YohanHadji/R2Home/README.md

# R2Home
The goal of the project is to design a system with a size of a tube about 40cm long by 7cm in diameter, which can be released in free fall from almost anywhere, and will automatically deploy a parachute canopy and steer it to a precise GPS point. 



You will find way more information about it there : 

https://hackaday.io/project/176621-r2home
https://www.youtube.com/channel/YohanHadji

Support the project on : https://gofund.me/c0ae8d1f

Frequent updates on : https://twitter.com/YohanHadji

If you have any question fell free to contact me at hadji.[putmyfirstnamehere]@gmail.com
