YohanHadji/R2Home/Parachute Design Ressources/Tipps2.pdf

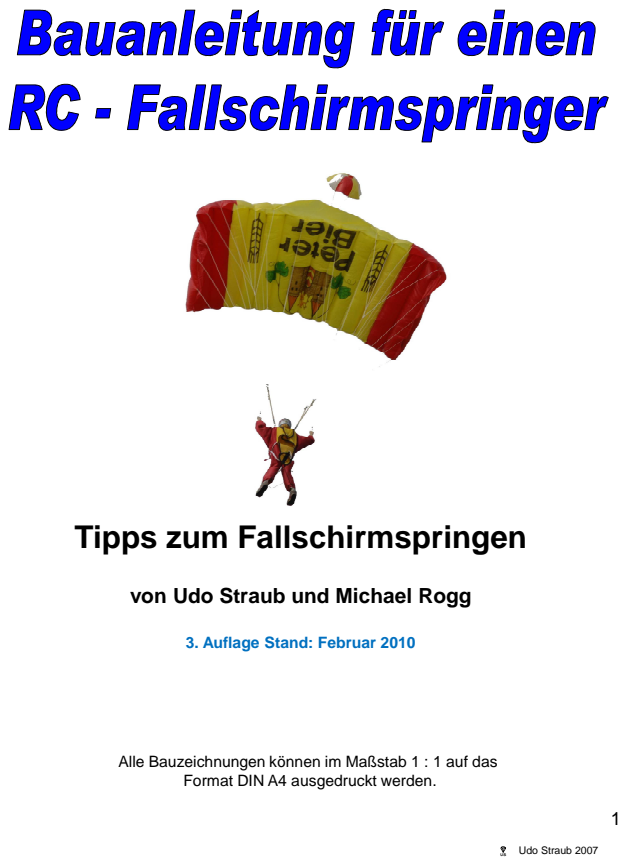
[picture p1: page 1]
Udo Straub 2007

Tipps zum Fallschirmspringen

von Udo Straub und Michael Rogg

3. Auflage Stand: Februar 2010

Alle Bauzeichnungen können im Maßstab 1 : 1 auf das

Format DIN A4 ausgedruckt werden.

## Informationen von Modellfallschirmspringern – für Modellfallschirmspringer

und für solche, die es werden wollen.

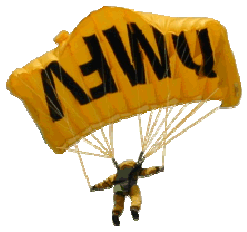
[picture p2: figure]

# Inhaltsverzeichnis

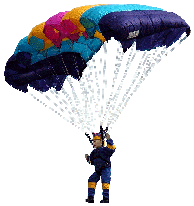
[picture p3: figure]

Informationen zum Modellfallschirmspringen ( nicht nur für Anfänger)

Die Schleppflugzeuge und das Absetzen der Springer

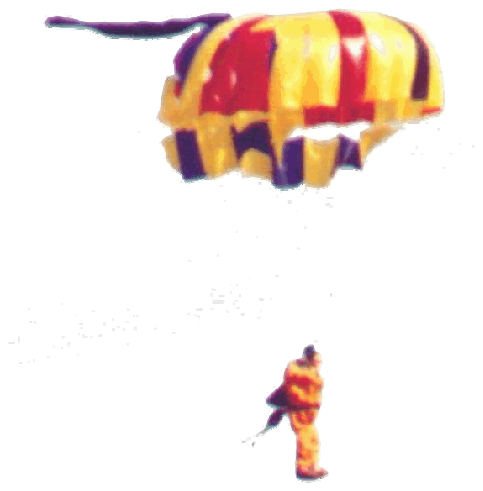
[picture p4: figure]

2

Aerodynamik des Flügelschirms

Wie wird der Fallschirm gepackt?

Der Schlepper vom Dienst

Der Springer im freien Fall

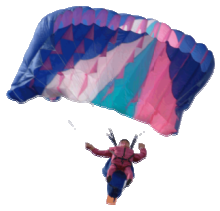
[picture p5: figure]
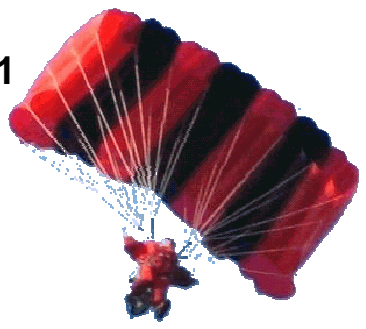
[picture p6: figure]

91
Impressum

## Infos (nicht nur) für Einsteiger von Michael Rogg

Allgemeine Infos zur Matratze

Stabilisatoren halten die Kappe offen (seitlich). Die Flairs (Dreiecke an der Unterseite) erleichtern das Einhalten der Flugrichtung.
Eine Vorbremsung des Schirmes ist evtl. notwendig, da die Kappe mit einem Anstellwinkel nach vorne unten fixiert ist. Ohne Vorbremsung würde die Kappe bei zu langen Steuerleinen sofort nach vorne unten Fahrt aufnehmen/wegschießen. Mit Vorbremsung geht der Schirm im Prinzip zuerst als Kappe ohne Vorwärtsfahrt auf. Erst dann beginnt der Schirm nach vorne zu gleiten.
Das System kann sich nur entfalten, wenn die Leinen ihre ganze Länge erreicht haben. Beim Original zieht der kleine Schirm den großen in einer Tasche verpackt aus dem Rucksack des Springers. Diese kleine Tasche ist mit Gummiringen verschlossen, die durch die Leinen von der Mitte aus versperrt werden. Wirft der Springer den kleinen Schirm aus, entfalten sich zuerst die Leinen, die dabei Stück für Stück die Tasche entriegeln, auf ihre volle Länge. Erst dann wird der Schirm aus der Tasche gezogen. Wurde der Schirm sauber gepackt, ist es praktisch egal, wie er in die Tasche gestopft wird.

Sicherheit

3

Kein Springer sollte jemals ohne einen Ortungspiepser auf die Reise geschickt werden. Eine Sicherheitseinrichtung, die eine vorzeitige Öffnung des Schirms am Flugzeug absolut verhindert ist ebenfalls unabdingbar. Der Schirm würde sich sonst mit großer Wahrscheinlichkeit am Leitwerk verhängen - mit katastrophalen Folgen!!!
Deshalb wird stets einen Art "Reißleine" mit maximal 30 cm Länge am Flugzeug befestigt. (Maurerschnur kann halten, muss aber nicht. Besser ist ein 12 mm breites Kunststoffband mit etwa 10 cm Klettverschluss.) Bei der einen Methode bleibt die Fernsteuerung eingeschaltet und ein Drahthaken an der Sicherheitsleine, der durch Ösen geführt wird, verhindert, dass sich der Schirm zu früh öffnet.
Bei der anderen Methode steckt ein Kohlepin im Allerwertesten des Springers. Er betätigt zwei Schalter (Redundanz!). Fällt der Springer vom Flugzeug ab, wird die Anlage eingeschaltet.

Auf dem Markt werden Sets angeboten, die auf einer Platine Ortungspiepser und Schalter enthalten. Sie sind teuer, aber sehr zu empfehlen, da der Pin die idealen Maße hat, um auch unter schwierigsten Bedingungen sicher auszulösen. Ich habe es mit meiner Do schon erlebt, dass ein Springer nicht vom Pin wollte und wild baumelnd unter dem Flugzeug hing. Stress lass nach!

Abb. 1

## Springer auf den Punkt gebracht !? von Michael Rogg

Tipps für das Zielspringen mit Modell-Fallschirmspringern

Beim Zielspringen mit Modell-Fallschirmspringern steht der Springerpilot sieben Meter vom Nullpunkt entfernt. Wie schwierig es ist, unter dieser Maßgabe bei wechselnden Platz- und Wetterverhältnissen die Scheibe zu treffen, zeigt ein Blick in die Ergebnislisten der Wettbewerbe.
Auch ich habe in den letzten Jahren versucht, mich immer näher heranzuarbeiten. Getreu dem Motto „es gibt für alles einen Grund“, habe ich meine Sprünge und (Fehl-!!!) Landungen analysiert und meine Schlüsse daraus gezogen. Der folgende Aufsatz ist eine Zusammenfassung meiner Erfahrungen, ohne Anspruch auf Allgemeingültigkeit oder Vollständigkeit. Schließlich geht jeder Pilot auch beim Fallschirmspringen seinen individuellen Weg.

### 1 DIE TECHNIK

Müssen es Gelenkarme sein?
Genau wie bei den „großen“ Springern werden die Geschwindigkeit reguliert und die Kurven gesteuert, indem die Hinterkante das Schirmes beid- bzw. einseitig nach unten gezogen wird. Zurzeit werden dazu zwei verschiedene Arme eingesetzt:
A) Arme, die nur am Schultergelenk beweglich sind

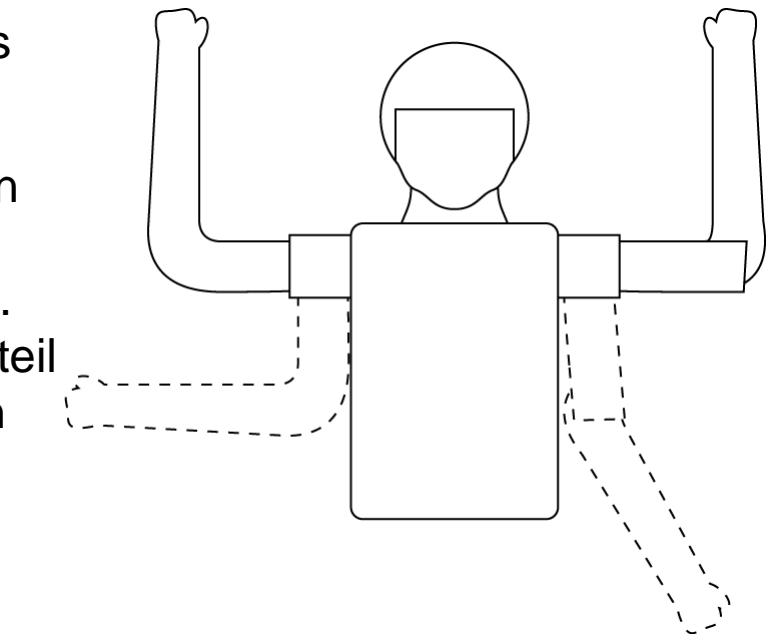
[picture p7: figure]

4

und deren Ellbogengelenk fixiert ist (Abb. 1, links).

B) Gelenkarme, bei denen über ein Hebelsystem Schulter- und Ellbogengelenk bewegt werden (Abb.1, rechts).
Die Gelenkarme haben sich in den letzten Jahren zunehmend durchgesetzt. Sie bieten einen deutlich größeren Steuerweg, der für viele Schirme dringend benötigt wird. Gelenkarme sind jedoch sehr aufwändig in der Herstellung und damit teuer! Es sollten sinnvoller Weise Servos mit mindestens 80 Ncm Stellkraft, besser 130 Ncm, verwendet werden.

Sie sind leicht und kostengünstig aus verschiedenen Werkstoffen herzustellen und haben sich im Dauerbetrieb als äußerst robust und zuverlässig erwiesen. Es genügen Servos mit ca. 80 Ncm Stellkraft. Nachteil dieses Armtyps: der Steuerweg reicht nicht bei allen Schirmen aus, um den ganzen Geschwindigkeitsbereich
auszuschöpfen.

Die Senderbelegung

Hier gibt es wohl so viele unterschiedliche Möglichkeiten wie Piloten. Da ich Flächenflieger bin, bevorzuge ich eine Belegung, bei der das Steuern des Springers mit der eines Seglers mit Querrudern und Störklappen identisch ist.
Beide Funktionen liegen bei mir auf einem Kreuzknüppel. Das bedeutet:
Knüppel vorn: volle Fahrt
Knüppel hinten: Stall („Störklappen ausgefahren“)
Knüppel links/rechts: Kurven
Wichtig ist, dass der Sender so programmiert wird, dass z. B. in der Stellung „ganz vorne“ + „ganz rechts“ der linke Arm den ganzen Weg vom oberen Anschlagspunkt bis zum unteren Endpunkt zurücklegen kann, wobei der linke Arm ganz oben bleibt (Abb. 2). V-Leitwerksmischer lassen diesen extremen Ausschlag nicht unbedingt zu. Frei programmierbaren Mischern ist deshalb der Vorzug zu geben. Werden notfalls zwei freie Mischer gekoppelt, sollte die Sache funktionieren. Ich selbst verwende eine MC 24 und habe zu meinem Erstaunen festgestellt, dass man zwei Mischer mit exakt derselben Bezeichnung (z.B. QR auf K1) zweimal (!) verwenden, und so den Ausschlag auf das geforderte Maß bringen kann.

5

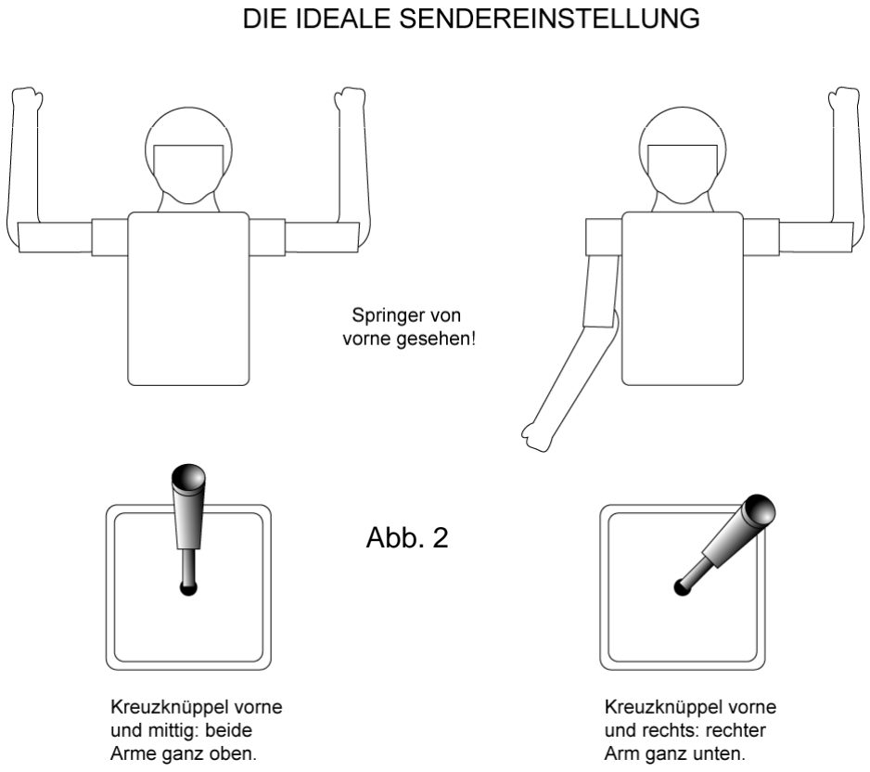
[picture p8: figure]
Abb. 2

Außerdem muss per Ruderwegbegrenzung sichergestellt sein, dass ein Servo einen Arm nicht über den oberen oder unteren mechanischen Endpunkt hinausziehen kann.

Nicht wenige Wettbewerbsspringer haben die Funktionen „Fahrt“ und „Kurve“ auf zwei Kreuzknüppel aufgeteilt, wobei dann die Geschwindigkeit über „Höhe“ gesteuert wird.

Gleiten oder sinken?

Vom Segelfliegen geprägt, habe ich anfangs meine Bemühungen um technische Verbesserungen zu lange auf das Gleiten gelegt. Bei gegebenem Schirm eine Sackgasse, wie sich bald herausstellen sollte. Denn: auf Grund seiner geringen Eigengeschwindigkeit kann sich ein Springer, im Gegensatz zu Segelflugmodellen, häufig nicht gegen den herrschenden Wind durchsetzen. Deshalb bleibt nichts anderes übrig, als den Springer stets recht nah am Zielpunkt zu halten und durch angepasstes Sinken auf den Punkt zu steuern. Manche Wettbewerber passen die Flughöhe an, indem sie mittels Stahlseil die vorderen Tragegurte etwas nach unten ziehen…
Für technische Verbesserungen gilt deshalb: nachdenken, wie sich das SINKEN beeinflussen lässt.
Auch beim Einfliegen eines Springers muss ein guter Kompromiss zwischen extremem Langsamflug (-> geringes Gewicht) und gutem Durchsetzungsvermögen bei Wind (-> höhere Flächenbelastung) gefunden werden.

### 2 DIE TAKTIK

### 2.1 Die Phasen des Zielsprungs

6

Wiederholung. Im Laufe der Zeit wurde mir klar, dass Zielsprünge „für Kopf und Finger“ am ehesten „vergleichbar“ und „wiederholbar“ werden, wenn man sie in Abschnitte unterteilt.

Folgende Unterteilung hat sich als recht nützlich erwiesen:
1. Anflug zum Absetzpunkt
2. Freier Fall und Öffnen
3. Anflug bis zum „Punkt“
4. Anflug bis zum Eindrehen
5. Anflug auf den Zielpunkt

### 1. Anflug zum Absetzpunkt

Auch wenn man es auf den ersten Blick kaum glauben mag: der richtige Absetzpunkt ist oft schon mehr als die halbe Miete. Stimmen Richtung und Entfernung in idealer Weise, hat der Springerpilot kaum etwas anderes zu tun, als den Springer auf sich zu fliegen zu lassen.

Die Richtung
ist dann perfekt gewählt, wenn der Wind den Springer genau auf den Zielpunkt zudriften lässt. Zwei Faktoren machen den Piloten hier das Leben schwer: erstens die Tatsache, dass sich die Windrichtung mit zunehmender Höhe oft stark ändert (hier ist ein feinfühliger und erfahrener Absetzpilot Gold wert) und zweitens die Windstärke.

Bei Abbildung 3 kommt der Wind in der Höhe von links. Hier ist der Vorhaltewinkel mit Sicherheitszugabe so groß zu wählen, dass der Springer am Ende seines Fluges auf jeden Fall eher „im Wind“ und damit links des Piloten ankommt und sich auf keinen Fall von rechts her gegen den Wind vorarbeiten muss. Bei entsprechend starkem Wind würde er das einfach nicht schaffen!
Säumen hohe Büsche oder Bäume den Flugplatz ist mit starken Verwirbelungen bis hin zu umlaufenden Winden zu rechnen. Dann helfen ein gutes Reaktionsvermögen und das notwendige Glück manchmal mehr, als die Theorie.
Die Windstärke

kann von Höhenmeter zu Höhenmeter extrem schwanken, vor allem, wenn der Landeplatz in einer Senke oder auf einer Kuppe liegt. Wird in einer Senke gelandet, kann der Wind auf den letzten Metern komplett ausbleiben. Bei Hügelkuppen wird in etwa 15 bis 50m Höhe oft ein Düseneffekt spürbar, der den Springer einige Sekunden lang mitreißt. Die Luft fließt hier, ähnlich wie bei einem Profil, sehr schnell über eine Wölbung. Dann ist genaueste Beobachtung angesagt.

7

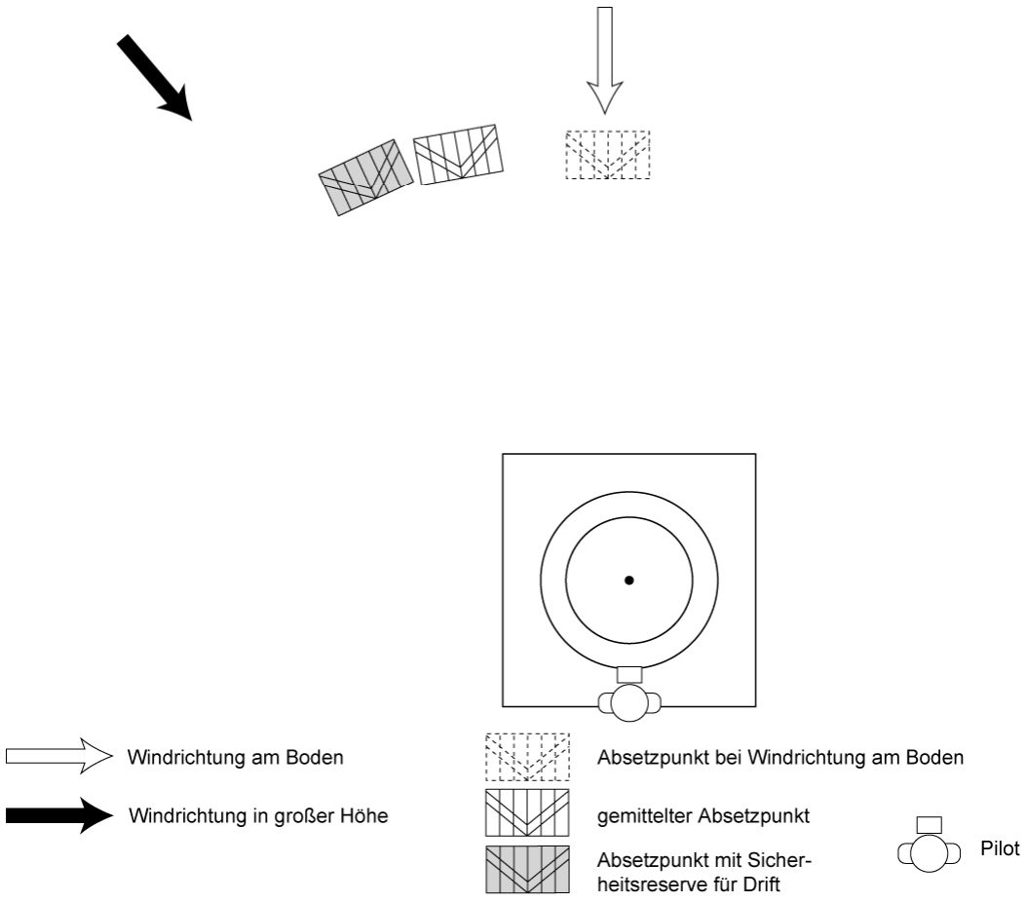
[picture p9: figure]

Lassen es die Geländeverhältnisse zu, so wird bei starkem Wind besser „zu weit vorne“ abgesetzt. Ist, was in der Praxis eher selten vorkommt, zu befürchten, dass der Springer den Zielpunkt nicht mehr erreicht, Schirm auf geringstes Sinken anbremsen und dem Wind die Arbeit überlassen, sprich Springer herantreiben lassen. Ein auf volle Fahrt geöffneter Schirm würde den Platz nicht erreichen, da er im Verhältnis zur Strecke, die er noch zurücklegen kann, viel zu schnell sinkt.
Bei besonders starkem Wind kann es von Vorteil sein, den Springer nur auf die unbedingt notwendige Höhe zu schleppen. Es genügt, wenn nach den beiden im Wettbewerb geforderten Vollkreisen gerade noch genug Zeit bleibt, um den Springer zum „Punkt“ zu bringen.
Hat man sich verschätzt, oder hat der Wind während des Sprunges aufgefrischt, ist es taktisch klüger, auf einen Kreis zu verzichten, als das Risiko einzugehen, über den Platz hinaus geblasen zu werden. Besteht die Gefahr, dass wegen auffrischender, starker Brise der Springer weit ins Lee abgetrieben wird, Springer lange fallen lassen und Kappe stets voll geöffnet gegen den Wind halten. Keinesfalls Kreise fliegen!

### 2. Freier Fall und Öffnen

Wenn man den freien Fall „tunen“ will, kommt man an zahlreichen Probesprüngen nicht vorbei! Dreht sich der Springer grundsätzlich wie auf einem Teller in eine Richtung, obwohl er sauber symmetrisch gebaut ist, kann man versuchen durch Bleizugabe (Körperinnenseite) auf der gegenüber liegenden Seite das Problem zu beheben.

8

Wippt die Puppe mit Kopf/Beinen stark auf und ab, oder überschlägt sich gar, liegt der Schwerpunkt nicht an der richtigen Stelle. Vor allem bei Gelenkarmen ist die Puppe oft zu kopflastig. Blei in den Beinen tut Not!

Für das Öffnen gilt: es wird selten zu spät geöffnet! Der Springer ist genauestens zu beobachten. Zum Zeitpunkt der Schirmöffnung muss er ruhig und sauber liegen. Viele Puppen benötigen einige Sekunden, bis sie ruhig auf ihrem Luftpolster durch die Luft gleiten.
Nervöse Anfänger zählen am besten in Ruhe laut bis drei, ehe sie öffnen.
Sollte der Schirm zum Öffnen sehr lange brauchen, muss überprüft werden, ob der Hilfsschirm tatsächlich sehr schnell ausgeworfen wird. Hilfsschirm so packen, dass ein beträchtlicher Teil der Verbindungsleine zum Hauptschirm nicht aufgewickelt ist, Hilfsschirm evtl. mit nur zwei oder drei Umdrehungen in den Auswurflappen einrollen. Öffnet sich der Schirm einmal nicht innerhalb des üblichen Zeitrahmens, beide Arme kurzzeitig etwas nach unten bewegen. Das bringt für gewöhnlich sofort „Bewegung“ in die Sache. In diesem Fall jedoch darauf achten, dass beim Entfalten der Kappe beide Arme ganz oben am Anschlag stehen, damit beim Öffnungsstoß die Mechanik geschont wird.

### 3. Anflug bis zum „Punkt“

Was ist „der Punkt“? Ich markiere mir nach meiner räumlichen Vorstellung stets einen Punkt am Himmel, von dem ab für mich die heiße Phase der Landung beginnt. „Der Punkt“ befindet sich etwa 40 bis 60 m und meist in direkter Windrichtung vor mir. Bei Seitenwind liegt er einige Grad „in den Wind“. Der Springer befindet sich am „Punkt“ in etwa 40 m Höhe. Nach der Vollendung der im Wettbewerb geforderten Kreise werden Distanz und Höhe so abgeglitten, dass sich der Springer möglichst ruhig genau „dem Punkt“ nähert. Der „Punkt“ hat für das Eintrainieren des letzten Abschnittes enorme Bedeutung,
Da er ein konstanter Ausgangspunkt ist, von dem sich die Landemanöver in relativ engen Grenzen wiederholen.

### 4. Anflug bis zum Eindrehen

Bei Windstille kann der Springer ab dem „Punkt“ angebremst und mit gleichmäßigem Sinken zum Zielpunkt geflogen werden. Die Landeeinteilung der Flugzeuge in Gegenanflug, Queranflug und Endanflug kann hier

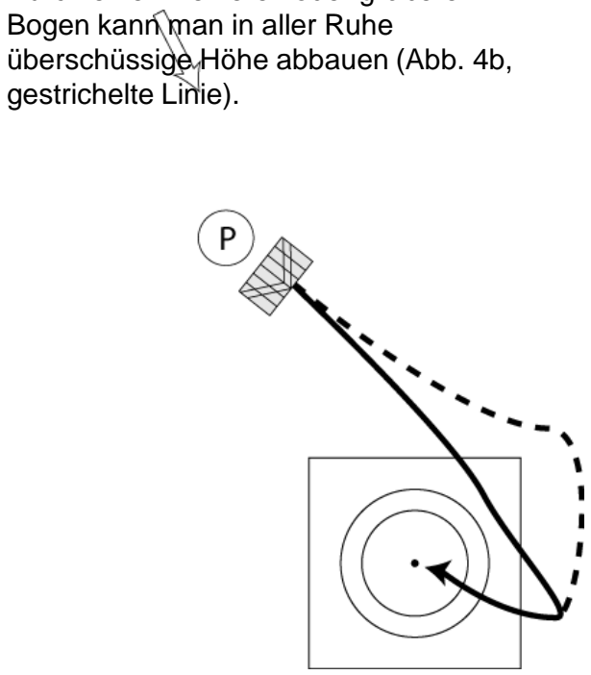
[picture p10: figure]
Bogen kann man in aller Ruhe überschüssige Höhe abbauen (Abb. 4b, gestrichelte Linie).

9

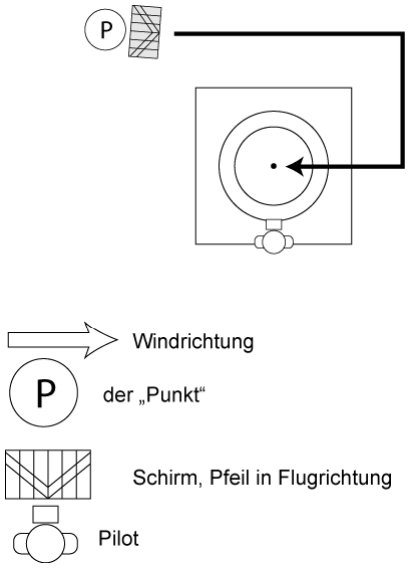
[picture p11: figure]

Abb. 4a

Abb. 4b

durchaus angewandt werden (Abb. 4a).

Durch einen kleineren oder größeren

Ab mittlerem Wind muss der Springer zunächst einige Sekunden volle Fahrt mit dem Wind abgleiten. Bei zu geringer Eigenfahrt wäre beim Eindrehen gegen den Wind der Widerstand der Kappe zu groß und es ginge wertvolle Zeit verloren, bis der Springerpuppe der Wind wieder ins Gesicht bläst. Hier ziehen es nicht wenige gute Piloten vor, den „Punkt“ außerhalb der direkten Windrichtung zu legen und die letzten Meter vor dem Eindrehen im spitzen Winkel zum Wind und

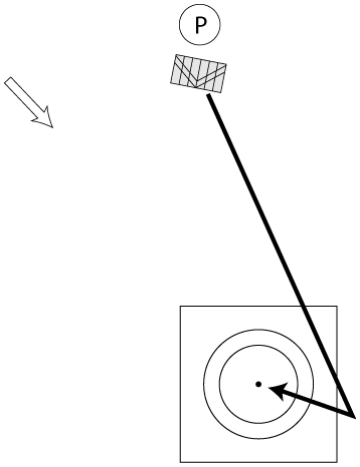
[picture p12: figure]

seitwärts driftend zurück zu legen. Auf diese Weise kann der Einfluss des Windes sehr gut abgeschätzt werden (Abb. 4c).

10

Abb. 4c

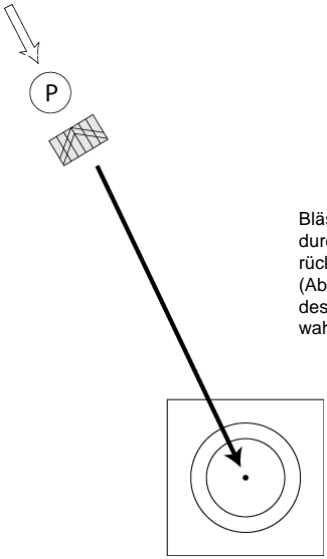
[picture p13: figure]

Bläst es sehr stark, aber auch konstant, kann es durchaus vernünftig sein, vom „Punkt“ weg rückwärts driftend den Zielpunkt anzugehen (Abb. 4d). Spätestens, wenn Hemd und Hose des Piloten im Wind flattern, ist dies die einzig wahre Technik.

Abb. 4d

### 5. Anflug auf den Zielpunkt

Gibt es über diese paar Meter tatsächlich noch etwas zu sagen?
Selbstverständlich! Zunächst ist alles eine Frage des „richtigen“ Standpunkts! Manche Piloten stellen sich gerne mit der Nase in den Wind, andere bevorzugen eine Stellung 90 Grad dazu. Der eine dreht notfalls gerne mal den Springer über seinem Kopf ein, der andere kann den Springer nur von links vernünftig steuern… Wichtig und richtig ist es sicherlich, mit wechselnden Standpunkten zu üben und Erfahrung zu sammeln, sich im Training vor allem auch auf seine „schlechte“ Seite zu konzentrieren, ehe man im Wettbewerb durch äußere Umstände dazu gezwungen wird.
Gewöhnt man sich außerdem an, mit seinen Zehenspitzen stets genau in Richtung Zielpunkt zu zeigen, hat man im Eifer des Gefechtes durch einfaches Ausrichten des Oberkörpers schon mal die exakte Richtung gefunden.

11

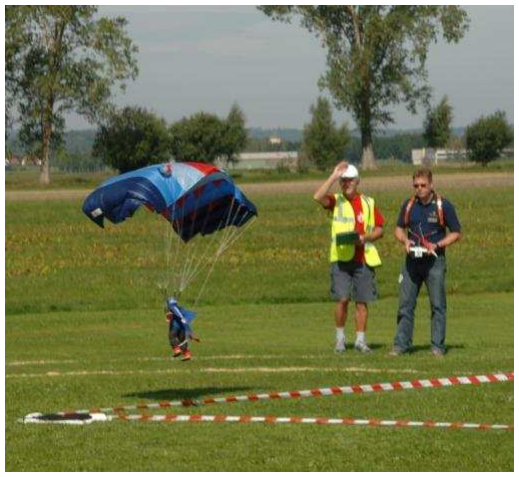
[picture p14: figure]

Die Regeln schreiben bislang vor, dass der Springer am Schluss ein paar Meter gegen den Wind fliegen muss und keinesfalls direkt aus einer Kurve heraus auf die Scheibe geschleudert werden darf. Allein schon aufgrund des oft krassen Missverhältnisses zwischen Windgeschwindigkeit und Springergeschwindigkeit, ist man in der Praxis damit zufrieden, wenn das Modell am Ende einige Sekunden stabil gegen den Wind fliegt.
Ob es sich dabei notfalls über Grund rückwärts bewegt, spielt keine Rolle.
Vor allem bei gemäßigtem, absolut konstantem Wind ist es mir immer wieder passiert, dass die Puppe über das Ziel hinausschoss, obwohl bis zur vorletzten Sekunde des Fluges alles perfekt zu sein schien. Eine logische Erklärung wäre, dass auf den letzten zwei oder drei Höhenmetern die Windgeschwindigkeit rasant zurückgeht. Nimmt der Springer deshalb auch nur für einen kurzen Moment Fahrt auf, schwingt selbst bei promptem Anbremsen die Puppe wegen ihrer Massenträgheit nach und setzt zu weit entfernt auf.

Ein zweites, häufig zu beobachtendes Phänomen zeigt sich, wenn nach mehreren Durchgängen der Wind ganz abflaut. Für gewöhnlich schießen auch in dieser Situation die Springer über den Zielpunkt hinaus. Jetzt kommt plötzlich die sonst kaum merkbare Minimalfahrt zum Tragen und die Puppe lässt sich nicht mehr über dem Zielpunkt halten. Eine Tatsache, auf die sich die wenigsten Wettbewerber innerlich einstellen können.
Dies kann nur umgangen werden, indem man mit etwas mehr Fahrt als „gewöhnlich“ den Landeanflug angeht.

Alles verstanden? Dann wird es Zeit, zum Flugplatz zu fahren…

Anregungen und Kritik (und vielleicht auch Lob) bitte über die Internetseite des MFC Ettringen (www.mfc-ettringen.de) oder privat (rgkestrel@aol.com/) Tel. 08246 1422 an den Autor.

Unendlich viel Springerspaß wünscht Euch

Michael Rogg, im Juli 2006

12

## Wie wird der Fallschirm gepackt?

von Udo Straub

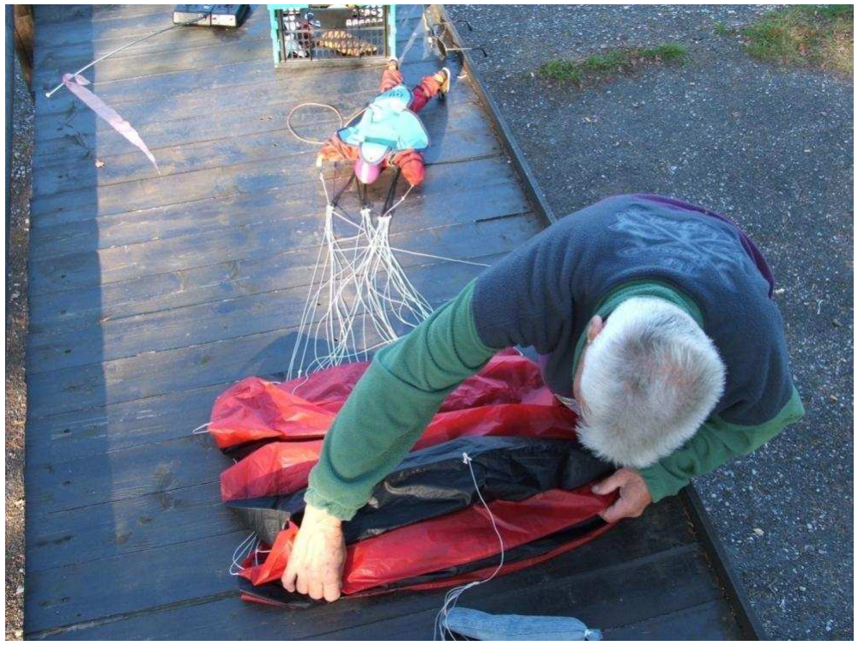
[picture p15: figure]

13

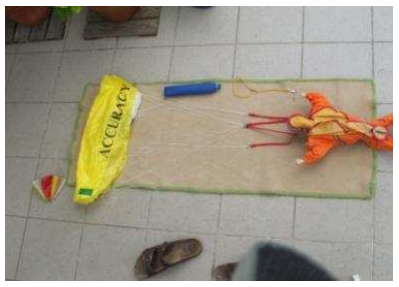
[picture p16: figure]

1

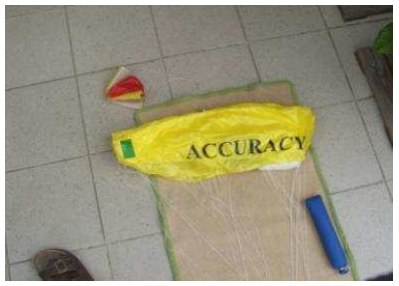
[picture p17: figure]

2

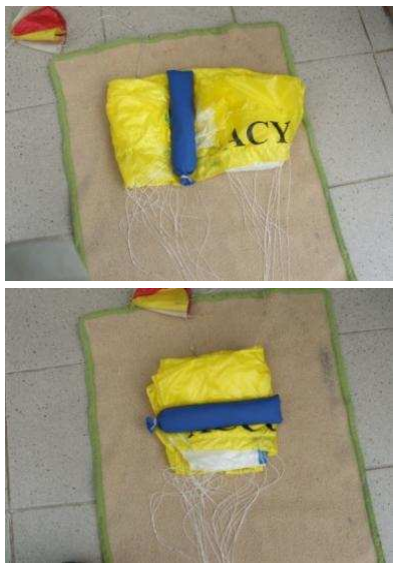
[picture p18: figure]

3

- aus einer alten Decke habe ich eine Packunterlage
- ein kleiner Sack mit Sand gefüllt erleichtert das Packen auch bei Wind
- der Springer wird auf dem Bach liegend gepackt. Die Schirmöffnung nach oben.
- Die Fangleinen liegen noch normal

3

4

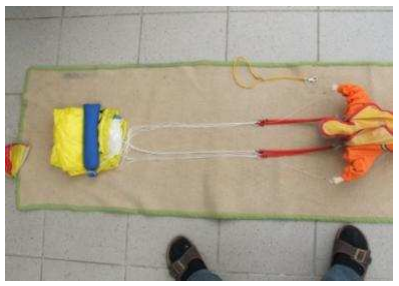
[picture p19: figure]

5

- Danach vorne 1/3 eingeschlagen
- Die Fangleinen werden von den Tragegurten zum Schirm gerichtet

14

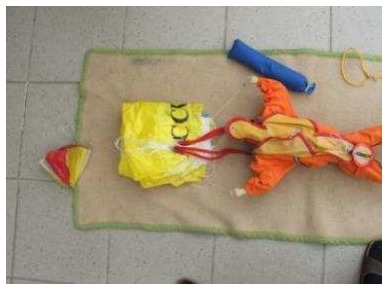
[picture p20: figure]

6

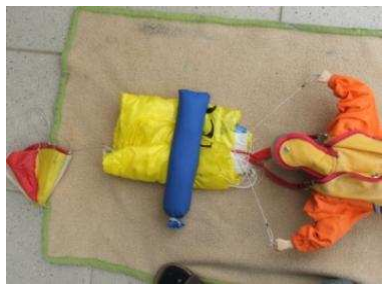
[picture p21: figure]

7

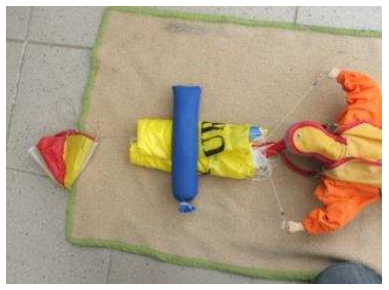
[picture p22: figure]

8

- Jetzt die Fangleinen und Tragegurte auf den Schirm legen.
- Die Fangleinen dann mit dem ersten Drittel des Schirmes erneut einschlagen
- Nun das andere Drittel ebenfalls einschlagen

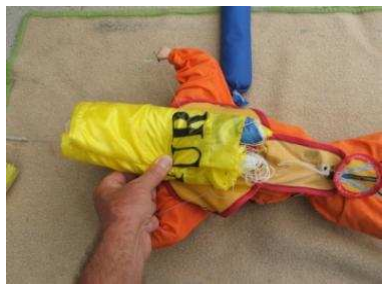
[picture p23: figure]

9

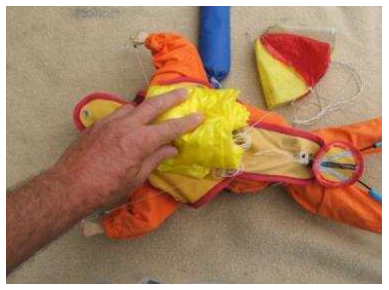
[picture p24: figure]

10

- Den ganzen Pack in den Packsack legen uns umzuklappen
- Die obere Hälfte nochmals umschlagen

15

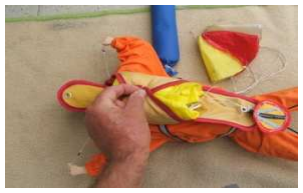
[picture p25: figure]

11

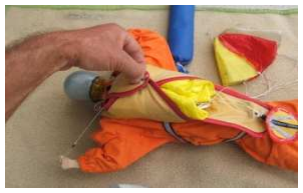
[picture p26: figure]

12

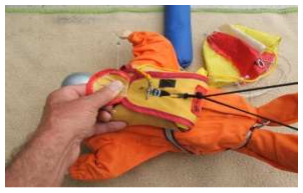
[picture p27: figure]

13

- Die beiden Seitenteile des Packsackes werden zusammengeführt..
- Die obere Packlasche folgt
- zuletzt die untere Packlasche einfädeln und mit dem Sicherungspin sichern

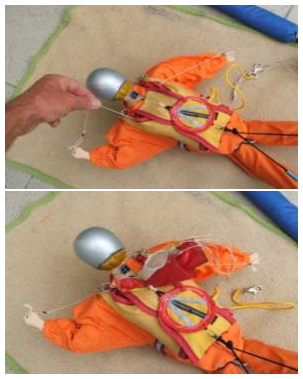
[picture p28: figure]

14

15

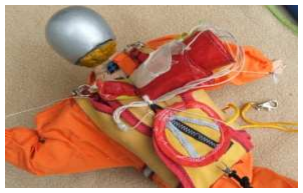
[picture p29: figure]

16

- Ggf. die Steuerleinen ein wenig herausziehen. Der Arm muss bei gepackten Schirm voll beweglich sein.
- Danach die Auslöseschlaufe (Fernsteuerung einschalten) einhängen.
- Die Leinen des Hilfsschirms ebenfalls unterklemmen
- Den Hilfsschirm einfach zwischen dem Packsack und der Auslöseleine klemmen.

16

## Hier die Auslösung Ein 3mm

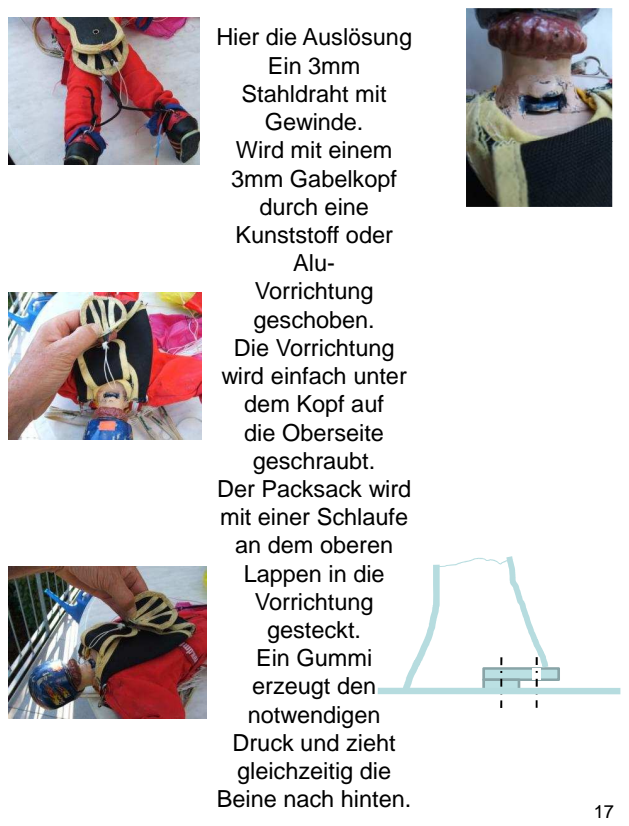
[picture p30: page 17]
Beine nach hinten.

Stahldraht mit
Gewinde.
Wird mit einem
3mm Gabelkopf
durch eine
Kunststoff oder
Alu-
Vorrichtung
geschoben.
Die Vorrichtung
wird einfach unter
dem Kopf auf
die Oberseite
geschraubt.
Der Packsack wird
mit einer Schlaufe
an dem oberen
Lappen in die
gesteckt.
Ein Gummi
erzeugt den
notwendigen
Druck und zieht
gleichzeitig die

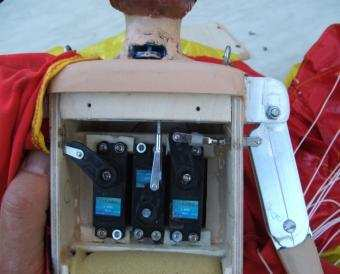
[picture p31: figure]

## Hier die gesamte

Anlenkung.

## Starke Servos > 6kg Zugkraft und 3mm Gabelköpfe auf 3mm Gewindestange reichen

aus.

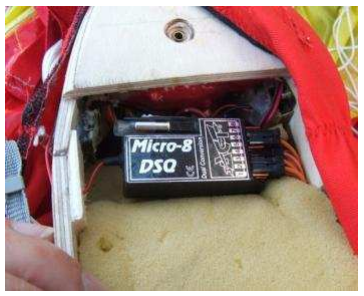
[picture p32: figure]

## Der offengelegte Empfänger. Dahinter der Ortungspiepser. Rechts der Schalter Ein/ Aus – links der Summer für den

Ortungspiepser.

## Ganz unten die beiden Endschalter für EIN/

AUS.

## Ich habe also zwei in Reihe geschaltete EIN/AUS- Schalter und als Sicherheit den SAFTY-PIN plus Elektro-

PIN.

## Deshalb auch zwei Stifte an der SEFTY-LINE ( Bild

rechts oben) | 18

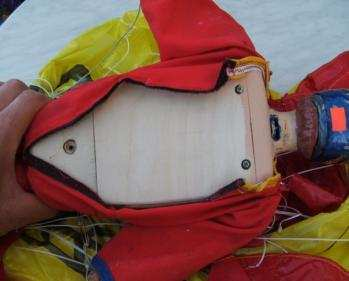
[picture p33: figure]

# Fachliteratur zum Thema

19

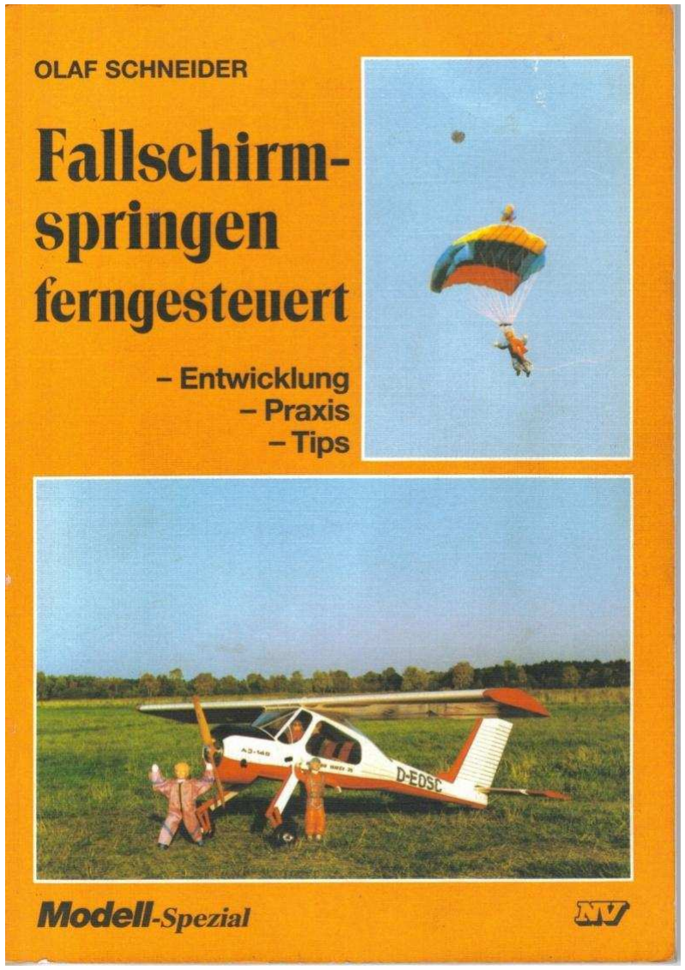
[picture p34: figure]

## Neckar – Verlag GmbH, 78045 Villigen-Schwenningen www.webshop.neckar-verlag.de

# Die Schlepper vom Dienst

von Michael Rogg

Diese Zeilen sind den unerlässlichen Schleppern - Mensch und Maschine - gewidmet. Es geht um Abgassysteme und Aufnahmevorrichtungen, Flügelspannweiten und Fahrwerke, Profile und Propeller, den Transport und selbstverständlich um dasTeam.
Zuweilen wird dieser Begriff als Kurzform für „Toll, Ein Anderer Macht´s.“ interpretiert. In unserem Fall ist nicht nur etwas Wahres daran, sondern es trifft den Nagel voll auf den Kopf.
Die besten Springerambitionen blieben auf der Strecke (Piste), gäbe es in den Vereinen keine lieben Kollegen, die nicht nur bereit sind die Springerpuppen auf Höhe zu schleppen, sondern auch noch geduldig den Anweisungen der Fallschirmspringerfans zu folgen. Darüber hinaus fertigen sie für die Springer Schleppmodelle an oder rüsten vorhandene Flugzeuge zum Absetzen um. Im Namen aller Springer-Piloten sei all diesen lieben Menschen deshalb hier zuerst einmal ein herzliches und riesiges Dankeschön ausgesprochen!
Und jetzt gibt es Tipps, wie man die Sache auf Dauer vernünftig angeht.
Es muss nicht immer Kaviar sein

In einer Zeit, da üppig motorisierte Flugmodelle mit zwei Metern Spannweite oder mehr auf unzähligen Flugplätzen zu Hause sind, sollte es kein Problem sein, eine für den

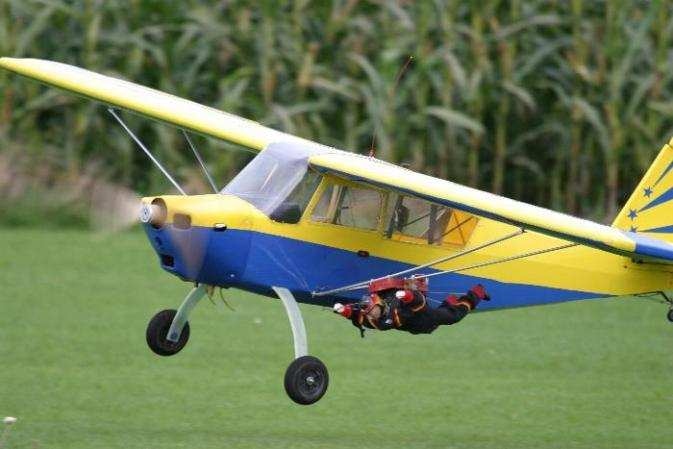
[picture p35: figure]

20

Springertransport geeignete Maschine der „Mittelklasse“ zu finden.
Um Anregungen zu geben und dabei verschiedenste Interessen und Vorlieben zu berücksichtigen, wurde eine Tabelle mit, wenn man so will, drei verschiedenen Typen von Modellen zusammengestellt.

Stellvertretend für auf Flugplätzen häufig zu findende (Baukasten-) Modelle, die mit wenig Aufwand für den Springertransport umgerüstet wurden, gibt es Informationen zu einer Bellanca Decathlon, Do 27, Jodel Robin und Piper PA18. In der mittleren Gruppe finden sich mit einer Daisy, einem Hannibal und einer Charter drei Beispiele für nach modifizierten Bauplänen erstellte Schleppmodelle. In der dritten Kategorie ist von einem OHA zu lesen - ein reines Zweckmodell, dessen Piloten Stein und Bein darauf schwören, dass es das beste Absetzmodell ist, das es gibt.
Wem die hier vorgestellten Modelle zu klein oder zu profan sind, wird zugeben müssen, dass es keines sonderlichen Aufwands bedarf, eine demontierbare Springeraufnahme (s. u.) auch an größeren Modellen vorzusehen. Ausgesprochene Großmodelle verfügen oft über eine extrem niedrige Grundgeschwindigkeit. Ein 160er Boxermotor dürfte ob zwei Kilogramm mehr oder weniger zu bewegendem Gewicht lediglich schmunzeln – wenn er denn könnte. Sowohl die überschüssige Motorkraft als auch die außerordentliche Minimalgeschwindigkeit prädestinieren Großmodelle auf jeden Fall für den
Springertransport.
Pflichtenheft für Schleppmaschinen

Die Gesamtauslegung des Modells sollte so sein, dass es bei gutmütigen Flugeigenschaften etwas übermotorisiert ist. Spannweiten ab etwa zwei Meter sind ideal, ebenso tragende oder dicke symmetrische Profile (Clark Y, NACA 2415, NACA 4415 usw.). Ein Springer wiegt für gewöhnlich zwischen 1,4 und 1,7 kg. Ein kritischer Blick auf die Gesamttragflächenbelastung kann deshalb nicht schaden. Wie man weiß, ist eine

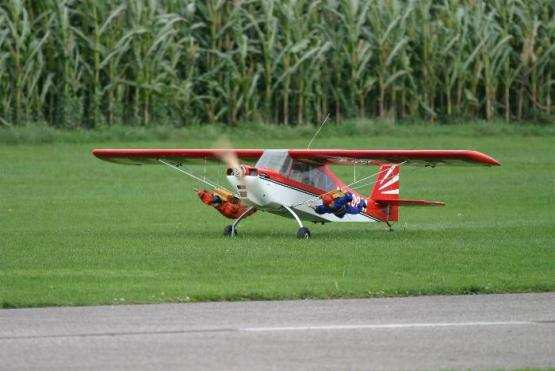
[picture p36: figure]

21

niedrige Flächenbelastung mit ausschlaggebend für eine niedrige Mindestfluggeschwindigkeit – eine absolut wünschenswerte Eigenschaft für Absetzmaschinen. Hochdecker oder Schulterdecker mit einigen Grad V-Form lassen in Punkto Eigenstabilität um die Längsachse bekanntlich nichts zu wünschen übrig. Auch das kommt unserem Einsatzzweck sehr entgegen. Um die Querachse ist ebenfalls ein hohes Maß an Eigenstabilität sehr gefragt. Dies wird durch ordentliche Höhenleitwerksabmessungen und einen großen Leitwerkshebelarm erreicht.
Die Springer können nicht immer so angebracht werden, dass sie die Lage des Schwerpunkts nicht beeinflussen. Bei vielen Modellen erzwingt die Fahrwerkskonstruktion eine Aufhängung hinter dem Schwerpunkt. Die Flugzeuge müssen deshalb etwas kopflastig ausgewogen werden.

Storchenbeine sind nicht zwingend vorgeschrieben, aber von Vorteil. Je höher das Fahrwerk ist, desto bandscheibenfreundlicher lassen sich die Springer unterschnallen. Wann ist die Fahrwerkshöhe gerade noch ausreichend? Schnallen Sie den oder die Springer unter den Rumpf und stellen Sie das Modell auf glatten, ebenen Grund. Sind an der engsten Stelle noch zwei Fingerbreiten Luft, geht die Sache in Ordnung. Das ist z. B. bei meiner Do 27 beim hinteren Springer der Fall. Auf einer Graspiste wird beim Rollen zwar der Eindruck erweckt, dass der Springer mit den Kniescheiben die Wiese umpflügt, bislang hatte aber keiner meiner Fluggäste auch nur Grasflecken auf dem Springerkombi.
Das Fahrwerk muss robust und hart im
Nehmen sein. GFK-Fahrwerke der Firma
KHK sind bei den Schlepppiloten äußerst
beliebt. Bei Baukastenmodellen erzwingt die erhöhte Zuladung oft eine härtere Federung. Dann muss mit zusätzlichen oder dickeren Stahldrähten bzw. Spiralfedern nachgebessert werden. Kommen Springerhände oder Leinen dem Rad s ehr nahe, sollte man an der Fahrwerksschwinge einen Abweiser anbringen.

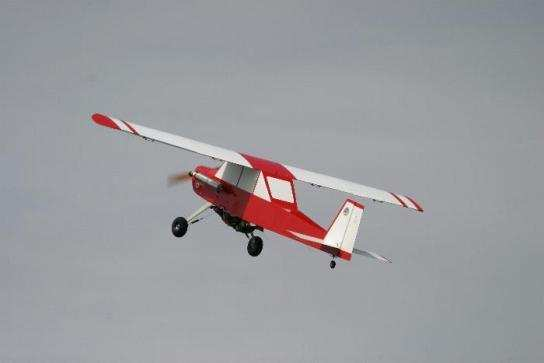
[picture p37: figure]

Dampf ist wichtig, aber nicht alles. Eine Wilga mit 2,2 m Spannweite, tragendem Profil, 35

22

ccm OS BGX und Resonanzrohr aus unserem Verein ließ sich von den kleinen Passagieren in keinster Weise beeindrucken. Sie klettert (e – leider) wirklich hervorragend. Ideal sind zweifelsohne Resonanzrohre mit einem Auslass am hinteren Ende, die in einem Tunnel im Rumpfinneren verlegt sind. Die Abgase treten dann hinter der Außenlast ins Freie, der Springer behält eine „weiße Weste“. Wer einen Benzinmotor mit Topfschalldämpfer verwendet, muss versuchen die Abgase zur Seite zu leiten. Sonst sieht der arme Springer schon nach einer Handvoll Transporte aus wie ein Aviateur, der ein Flugzeug mit Umlaufmotor pilotiert hat. Öliger Auswurf von Methanolmotoren darf sich keinesfalls auf dem Springer ansammeln. Die verwendeten Kriechöle perlen nicht wie Wasser auf den verwendeten Geweben ab, sondern dringen in sie ein und setzen sich fest. Über kurz oder lang würde der Fallschirm verkleben, das teure Stück wäre ruiniert.
Wer fliegen kann, hat auch viel Erfahrung mit Propellern. Bitte einfach daran denken, dass es stets mit Volllast nach oben geht und von den unerlässlichen Luftquirls genügend Leisetreter auf dem Markt sind. Acht oder zehn Zoll Steigung sind für unseren Zweck ideal.
Grundsätzliche Überlegungen zu Springeraufnahmen

Die Springeraufnahme hat die Aufgabe, den kleinen Passagier während des Transports sicher zu fixieren und ihn schließlich ebenso zuverlässig für den freien Fall zu entlassen. Weder Motorvibrationen noch heftige Schläge beim Rollen oder abrupte Flugmanöver dürfen ein Verrutschen des Springers zur Folge haben. Was folgt daraus im Detail?

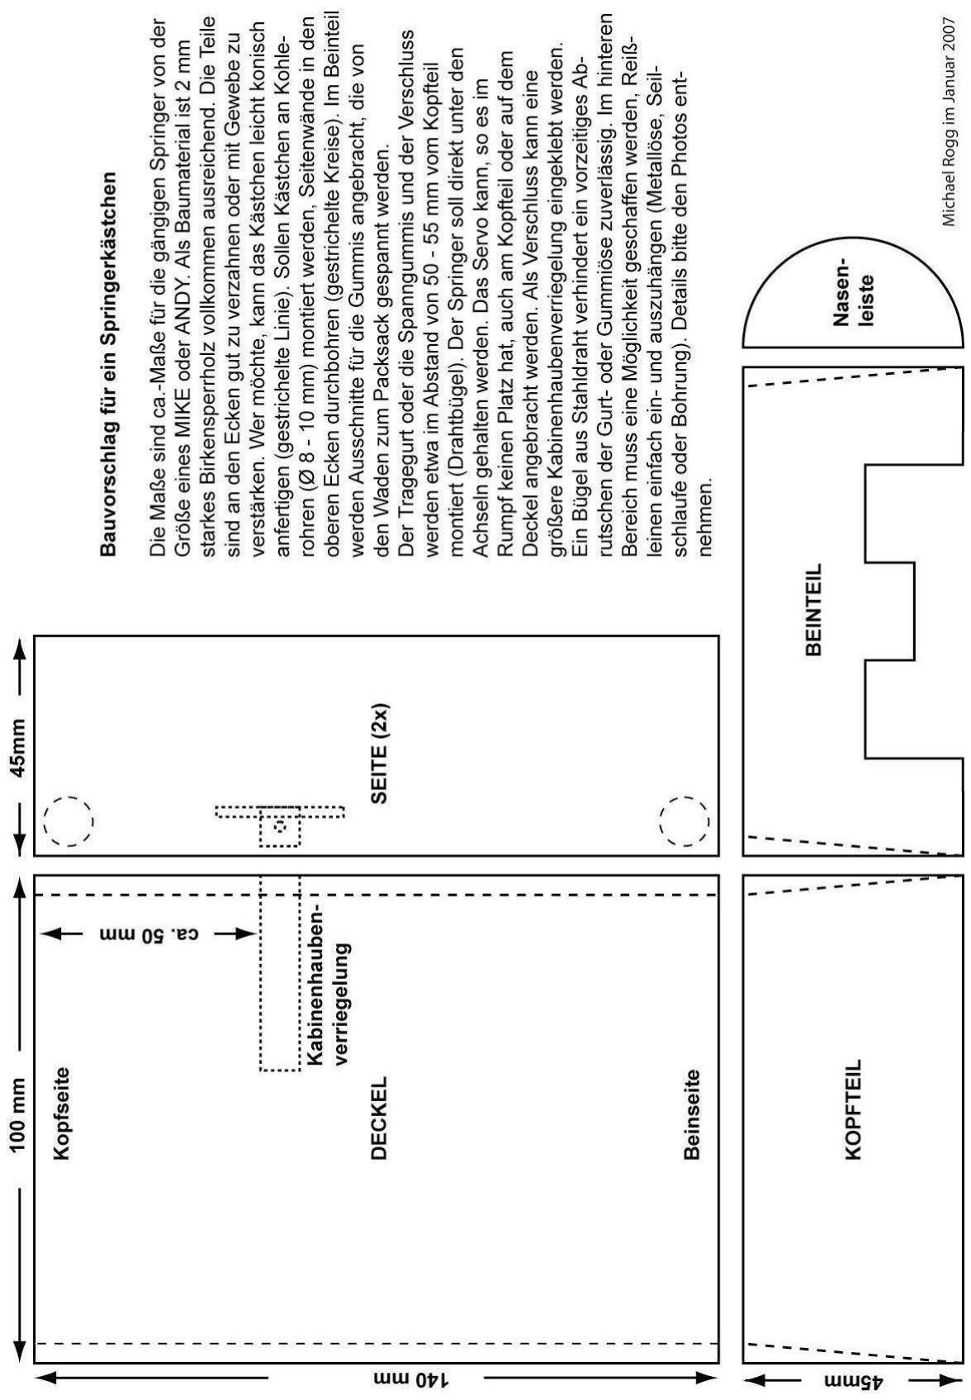
[picture p38: page 23]

23

Generell gilt: Bei der Gestaltung der Halterungen und Verschlüsse darf man seiner Phantasie freien Lauf lassen. Es sollte sich jedoch nach menschlichem Ermessen keine Leine oder Antenne in irgendeiner Weise verhaken können.

Das Kästchen
Eine der größten Gefahren für die Schleppmaschine stellt ein sich vorzeitig öffnender Schirm dar. Puppe oder Packsack sind deshalb mit entsprechenden Sicherheitseinrichtungen ausgestattet (vgl. Berichte 1 und 2). Ein kleines Kästchen an der Schleppmaschine (Maße siehe Zeichnung) ist ein weiterer wichtiger Beitrag zur Sicherheit. Es umschließt den Packsack eng, aber ohne ihn einzuklemmen. Sollte sich durch Vibrationen oder sonstige Ursachen einmal ein Lappen des Packsacks lösen o. ä., verhindert das Kästchen, dass sich die Fallschirmkappe im Luftstrom des Propellers entfaltet.
Befestigungsmöglichkeit für die Reißleine
Am hinteren Ende des Kästchens muss eine kräftige, gut zugängliche Öse oder Schlaufe für die Befestigung der Reißleine vorhanden sein. Zum Ein- und Aushängen von Reißleinen wird fast ausnahmslos eine der folgenden Techniken angewendet: man fädelt eine Schlaufe ein, benutzt einen Karabinerhaken oder Klettverschluss.

Gurt oder Gummi
Haltegurte oder -gummis haben die Aufgabe, den Springer sicher zu fixieren. Was passieren kann, wenn 1,5 kg an einem Bein hinter dem Schwerpunkt unter der

24

Ein breiter, stramm sitzender Gurt, der den Brustkorb der Puppe direkt unter den Achseln umfasst hat sich gut bewährt. Da man nie ganz perfekt gleich packen kann, trägt allein schon der Packsack immer etwas unterschiedlich auf. Außerdem haben nicht alle Springerpuppen das gleiche Maß. Deshalb muss man entweder für einen flexiblen Gurt sorgen (z. B. Hosenträgermaterial) oder den Verschluss eines Ledergurts anpassungsfähig gestalten. Eine Kombination aus Schlüsselring, Haushaltsgummis und Drahtöse leistet dabei gute Dienste. Der Einsatz von Klettverschluss ist auch immer eine Überlegung wert.
Die Verwendung von zwei breiten Gummiringen hat sich ebenfalls ausgezeichnet bewährt. Sie werden auf einer Seite im Abstand von einigen Zentimetern durch Ösen oder Schlaufen gezogen und auf der Verschlussseite mit einem kräftigen Kabelbinder oder kleinen Schlüsselring zusammengefasst.
Verriegelung
Der Verriegelungsmechanismus muss gut zugänglich und solide konstruiert sein. Ehe Sie ein Servo dafür auswählen bedenken Sie bitte, dass ordentlich Zug auf dem Riegel lasten wird und es sehr unangenehm sein kann, mit nur einem Springer auf einer Seite des Rumpfes zu landen.
In der Praxis sehr bewährt haben sich Mechanismen, die über die Fernsteuerung lediglich auf Zug geöffnet werden. Das Schließen übernimmt eine Spiralfeder. Ein handelsüblicher Kabinenhaubenverschluss leistet hier gute Dienste.

Wer etwas mehr Zeit und Aufwand investieren möchte, kann sich einen L-förmigen Riegel basteln. Die L-Form entlastet das Servo in besonderer Weise, da der Hebelarm, der verriegelt, deutlich länger ist, als der Hebelarm an dem der Gurt eingehängt wird.
Als „Gestänge“ wird flexibler Bowdenzug oder Stahlseil verwendet. So kann der Springer-Pilot sein Modell jederzeit einhängen, ohne dass der Pilot der Absetzmaschine ständig dabei sein muss.

Aufnahme für einen einzelnen Passagier

Ist ein Modell von Anfang an für den Transport eines einzelnen Springers vorgesehen, gibt es wohl keinen vernünftigen Grund es nicht schon beim Bau mit einer permanenten Springeraufnahme auszustatten. Dazu wird in die Rumpfunterseite kleines Kästchen eingelassen (Maße siehe Zeichnung). Der Springer sollte natürlich möglichst in der Nähe des Schwerpunktes seinen Platz finden. Achten Sie jedoch darauf, dass sich keine Leinen am Fahrwerk verfangen können. Auch wenn sie zunächst Bauchweh dabei haben: manchmal ist es besser, den Springer mit dem Kopf in Richtung Leitwerk unterzuschnallen.
Wird ein Flugzeug nur gelegentlich zum Absetzen eingesetzt, sieht man eine Befestigungsmöglichkeit für ein abnehmbares Kästchen vor. In diesem Fall werden in den Rumpf einfach zwei Einschlagmuttern eingeharzt.

Zwei oder mehr Springer sollen mit

25

Richtung der Tragflächen verteilt werden sollen. Eine Do 27 mit 2,7 m Spannweite hat genügend Längsstabilität, um die Puppen problemlos unter dem Rumpf zu transportieren. Sie reagiert auf die Schwerpunktverschiebungen nach dem Absetzen eines Springers äußerst gutmütig. Wenn nur der vordere Platz belegt ist, hält sich die Kopflastigkeit in Grenzen und lässt sich mit wenigen Zacken Höhe ausgleichen. Ist das Modell etwas kopflastig ausgewogen, hat man selbst dann keine ernsthaften Probleme, wenn nur in der hinteren Aufnahme ein Springer transportiert wird. (Selbstverständlich wird bei einem Einzelschlepp stets der vordere Platz belegt.) Unterschätzen Sie den Stirnwiderstand von Springeraufnahmen nicht. Halten Sie die Stirnseiten aller Halterungen so klein wie möglich. Gestalten Sie Stirnseiten stets rund.
Die Alternative zur Längsachse des Rumpfes ist die Querachse der Tragflächen.
Hier stellt sich zunächst die Frage ob Streben vorhanden sind und ob man die Springeraufnahmen daran befestigen möchte. Vor allem wenn die Streben aus Stahlrohren gefertigt sind, wie bei der 3-Meter-Version der Decathlon, steht einer Befestigung an ihnen nichts entgegen. Ich persönlich ziehe eine Aufhängung an Raumpfauslegern vor. Dabei werden die Aufnahmen an zwei Kohlestangen (Ø 8 mm) oder Kohlerohren (Ø 10 mm) in möglichst geringem Abstand zum Rumpf fixiert. Die Rohre oder Stangen schiebt man quer durch den Rumpf. In die Kohlerohre werden an besonders belasteten Stellen, wie dem Übergang in den Rumpf, kurze Buchenholzstücke eingeklebt. Karosseriesplinte aus dem RC-Car-Bereich sind ein probates Mittel wenn es um die Fixierung der Kohleträger geht.
Hat man üppig Motorleistung, kann zeitgleich mit den Springern an den Auslegern eine weitere Puppe unter dem Rumpf mitgenommen werden.

Standards

Durch das in Wettbewerben des DMFV nach wie vor gültige Gewichtslimit von 1,7 Kilogramm haben die allermeisten Springer eine vergleichbare „Standardgröße“. Sie können also sicher sein, dass Sie fremde Springer problemlos transportieren können, wenn Ihr Transportkästchen die in der Zeichnung angegebenen Maße hat und wenn man die Reißleine ohne Aufwand wechseln kann. Es lohnt sich sicherlich auch, innerhalb eines Vereins Standards zu vereinbaren. Dann kann eine Springeraufnahme problemlos von Modell zu Modell wandern.
Fliegen – Safety First

Der Transport und das Absetzen sind von jedem halbwegs versierten Piloten leicht zu bewältigen. Damit Sie vor unnötigen herben Rückschlägen definitiv verschont bleiben, seien hier noch ein paar grundlegende Dinge kurz erwähnt.
Bis man die Grenzen des sicheren Fliegens ausgelotet hat, empfiehlt es sich, das Modell beim Rollen ganz sauber mit Seitenruder gerade zu halten. Bei Seitenwind ist nach Bedarf mit etwas Querruder vorzuhalten. Nutzen Sie die gesamte Länge der Startbahn. Lassen Sie das Modell möglichst viel Fahrt aufnehmen. Es muss am Ende von selbst abheben und flach steigen.
Durch die Außenlasten haben sich die aerodynamischen Eigenschaften Ihres Modells in mehrfacher Hinsicht verschlechtert. Die höhere Tragflächenbelastung bedingt eine höhere

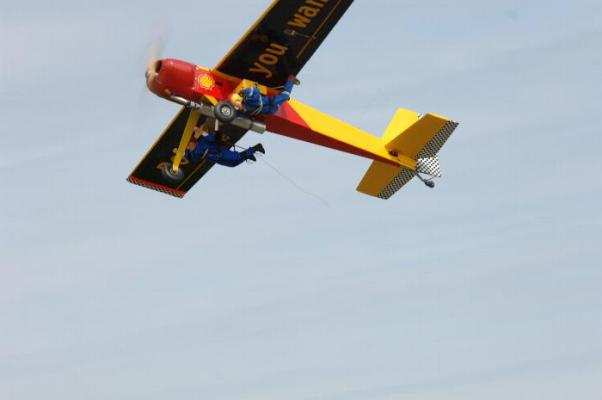
[picture p39: figure]

26

Minimalgeschwindigkeit. Anders herum formuliert: Der Strömungsabriss kommt eine ganze Ecke früher. Springer und Aufnahme haben eine deutlich spürbare Bremswirkung. Dieser Effekt tritt eben gerade dann auf, wenn sie mehr Fahrt brauchen. Landeklappen erhöhen nicht nur den Auftrieb, auch sie haben eine deutliche Bremswirkung. Verzichten Sie aus Sicherheitsgründen deshalb zunächst auf die Landeklappen und erfliegen Sie später die optimale Einstellung peu á peu. Vergessen sie nicht, dass Sie letztendlich bei einer vollgeladenen Maschine (viel) mehr Masse als zuvor in Bewegung setzen oder abfangen müssen. Ein satter Ruderdruck ist notwendig – wieder ein gute Argument für viel Fahrt.

Absetzen

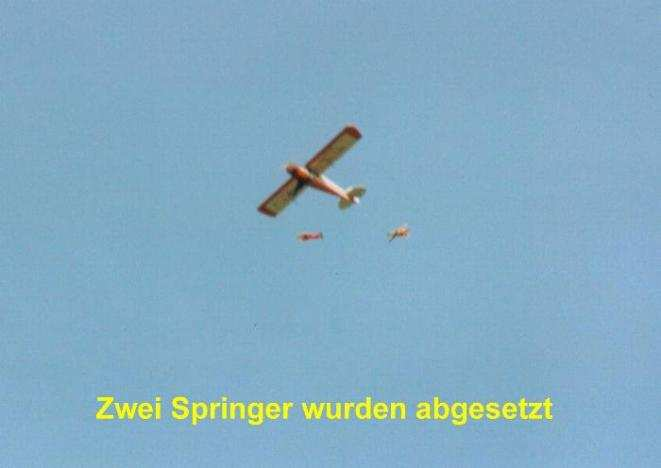
[picture p40: figure]

Verständigen Sie sich rechtzeitig mit Ihrem Springer-Piloten über den Absetzpunkt.
Tipps, wie man ihn auch unter ungünstigen Umständen sinnvoll wählt, finden sie in unserem Download ….

27

Das Absetzflugzeug sollte in den letzten zehn oder mehr Sekunden exakt gegen den Wind fliegen und keine Richtungskorrektur mehr vornehmen müssen. Nehmen Sie das Gas langsam und kontinuierlich heraus und lassen sie die Maschine Fahrt abbauen. Der Springer-Pilot sollte etwa drei Sekunden vor dem Erreichen des Absetzpunkts eine laute und deutliche Anweisung geben.
Im Idealfall fliegt das Flugzeug zum Zeitpunkt des Absetzens gerade noch so schnell, dass Sie es mit einer Hand sauber aussteuern können, ohne dass gleich mit einem Strömungsabriss gerechnet werden muss.
Da der Springer in großer Höhe und im Schatten des Flugzeugs oder Dunst nicht so einfach auszumachen ist, wird das Absetzen mit einem nachhaltigen „Weg!!!“ bestätigt. Sieht man den Springer tatsächlich einmal nicht, zählt der Springerpilot in Ruhe bis Drei und öffnet dann den Schirm.
Je mehr Geschwindigkeit ein Flugzeug im Moment des Absetzens hat, desto mehr Probleme gibt es im freien Fall. Es dauert viel länger, bis sich die Puppe stabilisiert. Eine in rasanter Vorwärtsfahrt abgesetzte Puppe hört manchmal nicht mehr auf, sich zu überschlagen. Dann verheddern sich beim Öffnen Körperteile in den Leinen usw.
Gut, das wäre auf die Dauer eine Möglichkeit, einen eventuell lästigen Springerfan loszuwerden, aber wir sind doch ein Team, nicht wahr?

## Die Aerodynamik des Flügelschirms

von Hartmut Buch und Dipl.Phys. Norbert Lucke

Auch bei den Modellfallschirmspringern bestimmen die rechteckigen Stauluftgleitfallschirme das Bild der Sprung-/ Modellfluggelände. Ihre Besonderheiten bestehen vor allem in ihrer hohen Fluggeschwindigkeit bei geringem Sinken sowie in ihrer hervorragenden Manövrierfähigkeit noch im Landevorgang. Die Grundlage dafür bilden die spezifischen aerodynamischen Vorgänge an der Kappe des Stauluftgleiters.
FLIEGER - REVUE veröffentlichte bereits in den Heften 6 und 7 / 1984 einen ausführlichen Beitrag zur Aerodynamik des Flügelschirms. Dieses Grundwissen über unsere Fallschirme sollte jeder Modellfallschirmspringer kennen.
Eigentlich dürfte jedem Fallschirmspringer klar sein, dass die Stauluftgleitfallschirme völlig andere aerodynamische Eigenschaften besitzen als die Rundkappengleitfallschirme. Deshalb werden auch nur jene Sportler in einem vertretbaren Zeitraum mit ihnen zu hohen Leistungen gelangen, die sich gründlich mit der Theorie vertraut gemacht haben. Mangelnde Kenntnis der Spezifik des Flügelschirms kann sogar zu Unfällen führen. Selbst erfahrene Springer, die in Bodennähe einen überzogenen Flugzustand herbeiführten oder mit zu hoher Fluggeschwindigkeit bei der Landung aufkamen, waren davon betroffen. Dabei bietet der Flügelschirm bei richtiger Handhabung ein hohes Maß an Sicherheit und gestaltet vor allem den Landevorgang wesentlich „sanfter" als eine Rundkappe.
Und diese Aerodynamischen Grundlagen sind auch auf die Modellfallschirme übertragbar.

28

Fallschirme – Widerstandskörper

Der klassische Fallschirm war ein idealer Widerstandskörper, denn großer Widerstand garantierte relativ langsames Sinken und sichere Landungen.
Die konkav, nach innen gekrümmte Fläche, also die Form der Hohlkugel, ist bekanntlich am besten dazu geeignet, einen entsprechend großen Widerstand zu erzeugen. Die Rundkappe wird von der Luft außen und innen umströmt, und der Widerstand entsteht durch einen Überdruck innerhalb und einen Unterdruck oberhalb der Kappe. Der so erzeugte Widerstand sicherte beispielsweise an dem sowjetischen Luftlandefallschirm D-1, der eine Kappenfläche von 82 m² (!) aufwies, bei einer Masse des Springers von 80 kg eine Sinkgeschwindigkeit von 5 m/s. Nehmen wir nun den modernen Flügelschirm. Der Seifenhennersdorfer RL-10 besitzt eine Kappenfläche von nur 21 m², doch beträgt die mittlere Sinkgeschwindigkeit lediglich 3 m/s bei 100 kg (Gleitverhältnis 1:3). Trotz drastischer Verringerung der Kappenfläche wird also ein fast doppelt so hoher Wirkungsgrad erreicht. Ohne auf die vielen Fallschirmformen einzugehen, die zwischen der traditionellen Rundkappe, für die wir den D-1 als Beispiel nannten, und dem modernen Sportfallschirm liegen, wollen wir nun betrachten, wie die erstaunlichen Verbesserungen zustande kamen, die sich selbstverständlich nicht nur im geringen Sinken ausdrücken.

Fallschirm oder Flügel?

Während die Konstrukteure bei der Entwicklung der herkömmlichen Typen stets bestrebt waren, einen hohen Widerstand zu erzeugen, mussten sie bei der Schaffung des Flügelschirmes einen anderen Weg gehen. Um eine möglichst hohe Vorwärtsgeschwindigkeit zu gewährleisten, darf der Flügel nur einen geringen Stirnwiderstand besitzen. Gleichzeitig muss am Flügel ein Auftrieb erzeugt werden, der eine geringe Sinkgeschwindigkeit des Systems Fallschirmkappe Springer ermöglicht.
Die Schöpfer der ersten Flügelschirme brauchten sich - vom Prinzip der Entstehung des Auftriebes aus betrachtet - nichts Neues einfallen zu lassen. Sie konnten bei den Flugzeugkonstrukteuren Anleihen aufnehmen und fanden in der Aerodynamik des Tragflügels die Grundlagen für die neuen Schirme. Das große Problem bestand allerdings darin, dass der Fallschirm erst nach dem Absprung mit dem Öffnungsvorgang jene Form erhält, die seine Funktionsfähigkeit sichert. Diese Besonderheit des Luftfahrtgerätes Fallschirm machte es den Konstrukteuren schwer, denn nach wie vor musste das ganze System vor jeden Einsatz in einem Tornister untergebracht werden, und somit kam wieder nur ein flexibles Material, also ein Gewebe, in Frage. Sollte jedoch der neue Fallschirm erstmals ein auftriebserzeugendes Luftfahrtgerät werden, dann muss er nach der Öffnung ein Flügelprofil (Querschnitt durch den Flügel) besitzen, denn nur mittels des entsprechenden Profils war die Erzeugung von Auftrieb möglich.

29

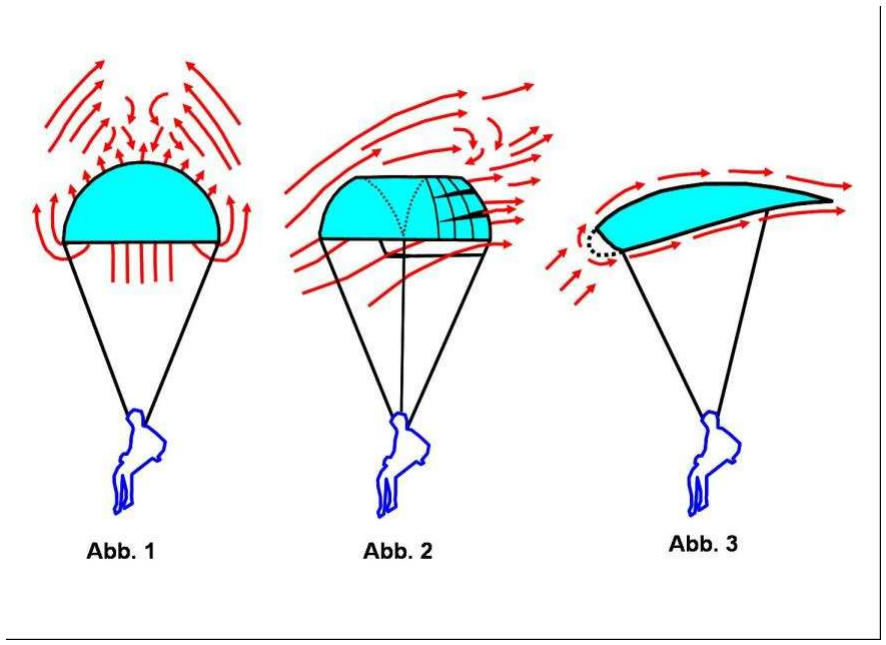
[picture p41: figure]

## Strömungsverhältnisse an Fallschirmkappen

Die ersten Rechteckgleiterentwicklungen besaßen bereits ein Profil, verwirklicht durch eine einzelne gewölbte Stofffläche. Wir hatten es hier also mit einem sehr dünnen Profil zu tun, das in einem begrenzten Anstellwinkelbereich (Anstellwinkel: Winkel zwischen Profilsehne und Anblasrichtung) auch einen ausreichend großen Auftrieb lieferte. Bestimmte, von dieser Profilform und dem Flügel abhängige Eigenschaften wie geringer Anstellwinkelbereich und mangelnde Stabilität im Langsamflug ließen eine Reihe von Wünschen offen. Mit einem solchen Profil war der steuerbare Rechteck-Fallschirm offensichtlich nicht zu realisieren. Erst mit der Entwicklung des druckaufgeblasenen Flügelschirms, der eine obere und eine untere Fläche sowie durch Rippen gebildete Kammern besitzt, war die Losung für ein Gerät gefunden, mit dem die Forderungen der Sportspringer erfüllt werden konnten. Dieser Flügel besaß einen großen Anstellwinkelbereich, hohen Eigenvortrieb bei geringem Sinken, gute Steuerbarkeit und Stabilität, besonders in Bezug auf das Abbremsen der Vorwärtsgeschwindigkeit.
Die Luftfüllung der Kammern nach dem Öffnungsvorgang lässt ein relativ dickes, unsymmetrisches Profil mit konkaver Unterseite entstehen. Ähnliche Profile fanden in den zwanziger Jahren bei einigen langsamfliegenden Motorflugzeugen und bei Schulgleitern Verwendung. Diese dicken Profile haben die Eigenschaft, dass sie bei geringer Fluggeschwindigkeit in einem großen An-stellwinkelbereich geflogen werden können. Nun ist aber der Flügelschirm nicht starr, sondern flexibel, und außerdem fehlt die Profilnase, jener Punkt also - er wird auch Staupunkt genannt -, an dem sich die anströmende Luft teilt. Die Fallschirmkonstrukteure jedoch erbrachten den Nachweis dass es auch ohne ihn geht.
Die Profilnase des Flügelschirms wird nach der Füllung der Kammern durch den Stau der

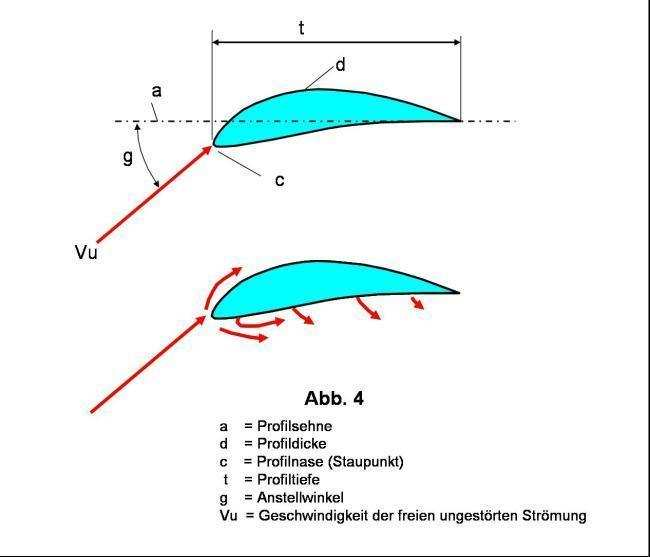
[picture p42: figure]

30

Luft gebildet. So entsteht hier der Staupunkt, von dem aus die Luft das Profil unten und oben umströmt. Die Strömungsvorgänge, die sich nun an der Kappe abspielen (Abb. 3), unterscheiden sich im Prinzip nicht vor denen am starren Tragflügel.

Das Profil macht's möglich

Obwohl das Profil des Flügelschirmes vorn offen ist und damit auch Strömungsvorgänge zwischen innerer und äußerer Kappenfläche eine bestimmte Rolle spielen, berücksichtigen wir diese Besonderheit hier erst einmal nicht, da sie von untergeordneter Bedeutung ist. Die Luft zwischen den Kappenflächen hat die Aufgabe, dem flexiblen Flügel sein charakteristisches Profil zu geben.
Am Staupunkt teilt sich die anströmende Luft. Auf Grund der Profilform haben die Luftmoleküle auf der Oberseite einen längeren Weg zurückzulegen als die auf der Unterseite. Deshalb ist die Geschwindigkeit und damit der dynamische Druck auf der Oberseite größer als auf der Unterseite des Profils. Folglich ist auch der statische Druck auf der Oberseite kleiner als auf der Unterseite. Es wirkt somit eine Druckdifferenz von unten nach oben (Abb. 5), die, multipliziert mit der Fläche, auf die sie wirkt, eine nach oben gerichtete Kraft ergibt (die theoretischen Erklärungen dafür finden wir im Stetigkeitsgesetz und im Bemoullischen Gesetz).
Die Profiloberseite eines Flügels trägt mit ihrem Druck etwa zu zwei Dritteln zur Entstehung der auftriebserzeugenden Druckdifferenz bei. Genau wie beim Flugzeug hängt das Fliegen also auch beim Flügelschirm nicht so sehr vom Druck unterhalb, sondern vom Unterdruck und der damit verbundenen Sogwirkung oberhalb des Flügels ab.

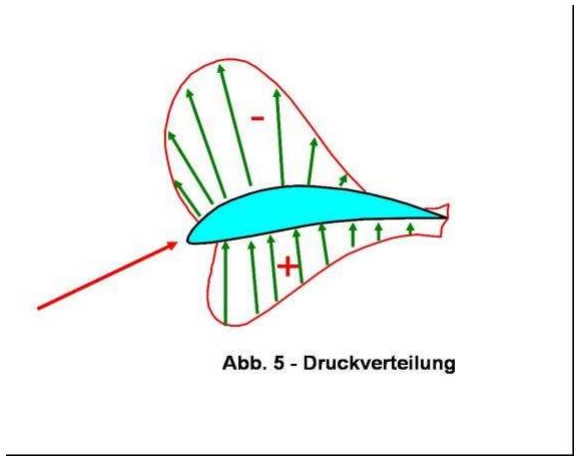
[picture p43: figure]

Die Profilform stellt selbstverständlich nur eine Einflussgröße des
Auftriebes dar, sie ist jedoch der

31

Ausgangspunkt, da ganz bestimmte Profilformen ganz bestimmte Eigenschaften besitzen. Wir erwähnten bereits das dünne Profil der ersten Flügelschirme, das nur durch eine einzige Bahn gebildet wurde. Der geringe Bereich, in dem bei diesem Profil der Anstellwinkel verändert werden kann, machte sie für das Zielspringen ungeeignet, schränkt doch der. geringe Anstellwinkelbereich die Möglichkeit ein, die
Vorwärtsgeschwindigkeit abzubremsen und bei verringerter Geschwindigkeit wirksame, stabile Steuermanöver auszuführen. Zu schnell erreichte dieser Flügel den kritischen Anstellwinkel, jenen Bereich, bei dem die Strömung abzureißen beginnt (wir kommen. Noch auf die dabei entstehenden aerodynamischen Verhältnisse zu sprechen).

Gesucht und gefunden

Die theoretischen und praktischen Erkenntnisse mit diesen ersten Typen zeigten den Konstrukteuren eindeutig, welche Profilform für das Zielspringen günstiger war, nämlich das dicke Profil, dessen grundsätzliche Eigenschaften wir bereits genannt hatten. Als mit dem druckaufgeblasenen Fallschirm die konstruktive Losung dafür gefunden war, wurden bei den Herstellern zunächst eine ganze Reihe von dicken Profilen im Windkanal und bei Sprüngen mit Prototypen auf ihre Eignung getestet, ehe schließlich das geeigneteste Profi! gefunden worden war. Es stellte den günstigsten Kompromiss zwischen den verschiedenen Anforderungen dar, denn stets sind es mehrere, zum Teil einander widersprechende Eigenschaften, die miteinander in Einklang gebracht werden müssen. So hat ein dünneres Profi! zwar den Vorteil, dass es schneller ist und damit die Gleitzahl erhöht werden kann, jedoch besitzt es ungünstige Eigenschaften im Langsamflug. Es wäre auch möglich gewesen, dem Flügelschirm ein dickeres Profil zu geben als es die gegenwärtigen Typen besitzen, das jedoch wäre bei guten Langsamflugeigenschaften auf Kosten der Gleitzahl gegangen.
Die Strömungsversuche mit dem druckaufgeblasenen Flügelschirm erbrachten auch ein klares Bild darüber, wie sich die Strömung innerhalb der Kammern verhält. Die Luft strömt in die Kammern ein, staut sich und wird verwirbelt. Ein Teil der einströmenden Luft fließt vorn, an der Unterseite der Öffnung, wieder ab. Bei der Verwendung von teilweise luftdurchlässigem Material für die Gewebebahnen der Oberkappe und der Unterkappe tritt außerdem ein gewisser Anteil der in den Kammern gestauten Luft durch das Kappengewebe hindurch und beeinflusst die Umströmung des Profils. Innerhalb der Kammern

32

schließlich die gewünschte Profilform. Obwohl die notwendige Luftfüllung des Flügels und die dabei auftretende Zirkulation von innen nach außen eine Besonderheit darstellen, ist die Umströmung des Flügelschirmprofils in ihrem Wesen nichts anderes als die des starren Tragflügels.
Wir haben nun die Profilform als wichtige Einflussgroße des Auftriebes kennen gelernt Sie ist aber nicht die einzige. Weitere Faktoren sind die Strömungsgeschwindigkeit (Staudruck) der Anstellwinkel des Profils und die Flügelfläche. Vereinfacht ausgedrückt, kann beispielsweise durch Erhöhung der Kappenfläche in bestimmten Grenzen der Auftrieb vergrößert werden. Allerdings produziert der Flügelschirm nicht nur Auftrieb, sondern auch Widerstand, und zwar eine ganze Menge. Das relativ dicke Profit, das sich für den Flügelschirm als günstig erwiesen hat, besitzt einen großen Anstellwinkelbereich, auf den die guten Steuereigenschaften und die hohe Stabilität auch während des Langsamfluges zurückzuführen sind. Mit der Änderung des Anstellwinkels beim Herunterziehen oder Nachlassen der Steuerknebel verändert sich auch das Verhältnis zwischen Auftrieb und Widerstand. Dieses Verhältnis wird in der Luftfahrt bekanntlich durch den Auftriebsbeiwert (ca.) und den Widerstandsbeiwert (cw) ausgedrückt. Das sind zwei dimensionslose Größen, die jeweils für verschiedene Anstellwinkel im Windkanal ermittelt werden. Die an unserem Flügelschirm auftretenden Widerstände unterscheiden sich in ihren Entstehungsursachen ebenfalls nicht vom starren Flügel. Allerdings sind die Reaktionen völlig anders.

Turbulenz dominiert

Nehmen wir als erstes den Reibungswiderstand, der durch eine gewisse Zähigkeit der Luft und natürlich durch die Oberflächenbeschaffenheit (Rauhigkeit) entsteht. Diese Zähigkeit bedingt ein Anhaften der Luftteilchen unmittelbar an der umströmten Körperoberfläche. Die Strömungsgeschwindigkeit ist hier gleich Null, und diese Schicht bremst die Teilchen der nächsten Schicht. Das setzt sich so lange fort, bis an einer bestimmten Stelle die Luftteilchen die Geschwindigkeit der freien Strömung erreicht haben.
Den Bereich, in dem die Geschwindigkeit von Null auf die Geschwindigkeit der freien Strömung anwächst, nennt man Grenzschicht. Sie misst nur wenige Millimeter, und die darin auftretenden Reibungskräfte besitzen eine große Bedeutung. Bei Verwirbelungen innerhalb der Grenzschicht sprechen wir von turbulenter Grenzschicht. Ist die Strömung unverwirbelt, haben wir es mit laminarer Grenzschicht zu tun. Am Tragflügel entstehen stets beide Grenzschichtarten, laminare im vorderen, turbulente im hinteren Abschnitt. Ganz allgemein kann man feststellen, dass der laminare Bereich an unserem flexiblen Flügel sehr klein ist, die turbulente Grenzschicht überwiegt. Wir haben es mit einem extremen Turbulenzprofil zu tun.
Zwar besitzt die laminare Grenzschicht den Vorzug, dass ihr Reibungswiderstand wesentlich geringer als der der turbulenten ist (deshalb strebt man bei Segelflugzeugen einen großen laminaren Bereich an), doch es sind auch Nachteile damit verbunden. Die laminaminare Grenzschicht löst sich bei höherem Anstellwinkel schneller vom Profil ab als die turbulente, da letzterer die Fähigkeit innewohnt, aus der

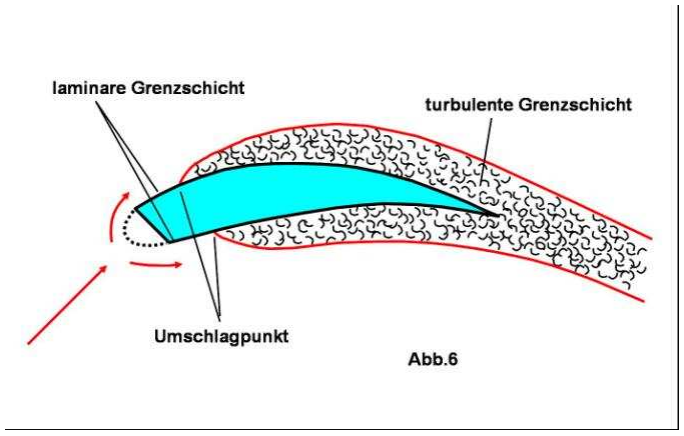
[picture p44: figure]

33

Flügelschirm in einem großen Anstellwinkelbereich Auftrieb liefert.

Der Widerstand unseres Profils wird jedoch nicht nur von Reibungskräften, sondern auch vom Druckwiderstand bestimmt. Er unterteilt sich wiederum in den Form- und in den induzierten Widerstand.
Betrachten wir zuerst den Formwiderstand.

Ganz schöner Wirbel

Nicht nur die klassische Fallschirmkappe erzeugt bei ihrer Umströmung Wirbel, sondern auch die aerodynamisch gestaltete Kappe des Flügelschirms. Die daran auftretenden Verwirbelungen sind abhängig von Größe und Form des Profils und dem jeweiligen Anstellwinkel, denn alle Faktoren zusammen tragen zu einem geschlossenen Wirbelsystem bei (s. Abb. 7). Mit größer werdendem Anstellwinkel verstärken sich die Wirbel und erhöhen damit den Formwiderstand. Das kann schließlich so weit führen, dass sie die Grenzschicht ablöst und der Auftrieb praktisch zusammenfällt. Durch den Ausgleich der Druckdifferenz zwischen Profilober- und Unterseite treten auch kräftige Wirbel an den Flügelenden auf. Sie bewirken den so genannten induzierten Widerstand. Flugzeugkonstrukteure begegnen ihm beispielsweise mittels Endkeulen an den Flügelnden oder indem sie den Tragflügeln eine große Streckung und schmal auslaufende Flügelnden geben. Das geht am Fallschirm allerdings nicht. Die geringe Streckung unseres Flügelschirmes produziert deshalb einen sehr großen induzierten Widerstand und erhöht damit den Widerstandsbeiwert entscheidend. Ließe sich nun durch entsprechende konstruktive Maßnahmen nicht auch dieser Widerstandsanteil reduzieren und damit das Verhältnis von ca zu cw zugunsten des Auftriebs verbessern? In diesem Zusammenhang müssen wir einiges zum Einsatzzweck unseres Flügelschirms sagen.

34

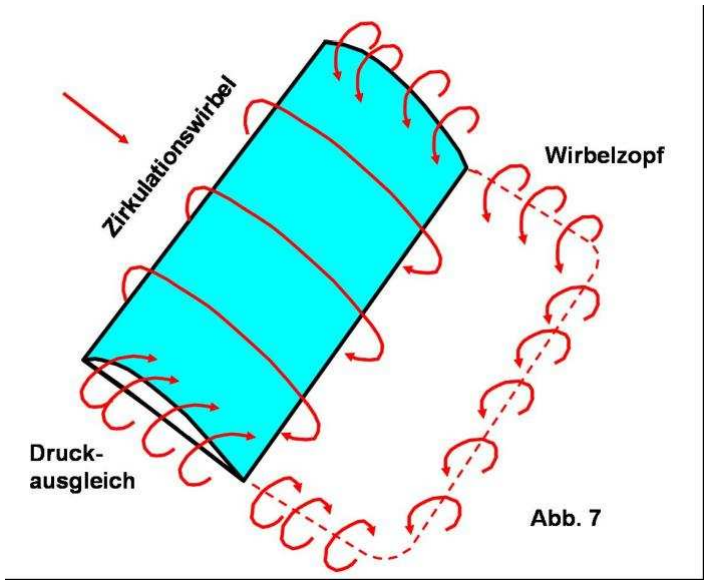
[picture p45: figure]

Der Fallschirm als Sportgerät

Eine wesentliche Aufgabe für die Sportfallschirmentwicklung war und ist es, Fallschirmkappen mit optimalen technischen und aerodynamischen Eigenschaften für das Zielspringen zu schaffen. Gilt es doch dabei, mit möglichst geringer Geschwindigkeit das Ziel so anzufliegen, dass dem Sportler genügend Zeit bleibt, die Nullscheibe exakt zu treten. Die beim Bremsen des Fallschirmes verbleibende horizontale Geschwindigkeitskomponente soll also nur geringfügig über der gerade, am Landeplatz herrschenden Windgeschwindigkeit liegen, damit das System Fallschirmkappe - Springer fast senkrecht mit einer geringen Vorwärtsgeschwindigkeit das Ziel anfliegt. Bei geringen Bodenwindgeschwindigkeiten ist dies allerdings nicht ganz problemlos, weil sich der Vortrieb eines solchen tragflügelähnlichen Staukammergleitfallschirmes nicht völlig wegbremsen lässt, ohne dass die Strömung abreißt und sich die Geschwindigkeit des Systems daraufhin wieder wesentlich erhöht.

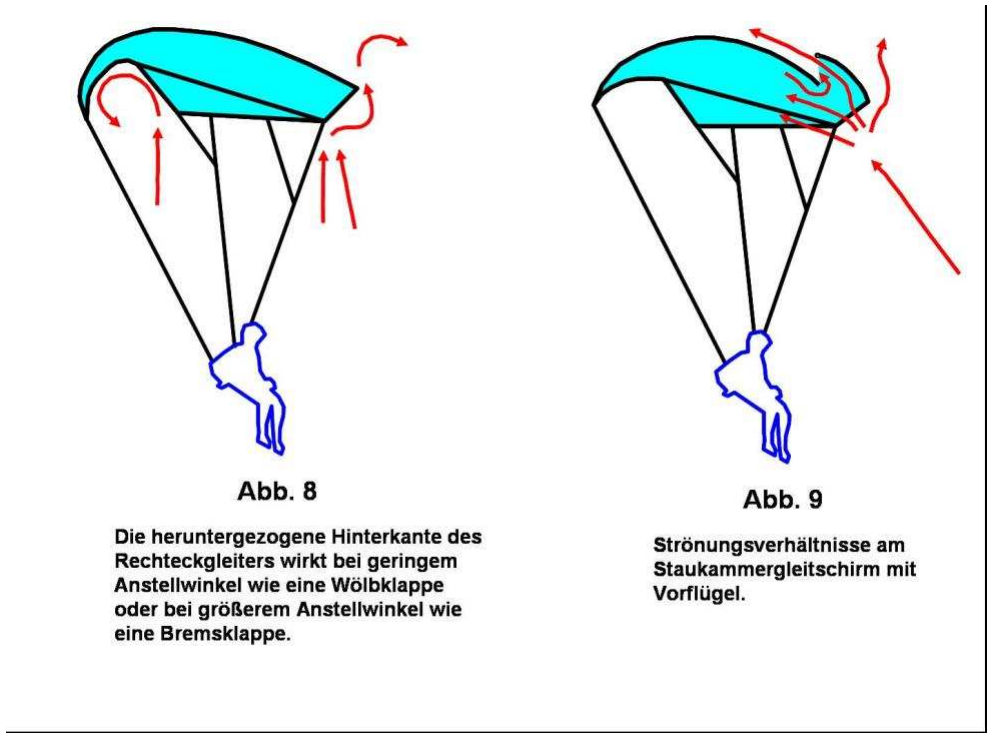
[picture p46: figure]

35

An dieser Stelle einige Erklärungen zu diesem Effekt: Wie bereits beschrieben, wird das Profil im Flugzustand unter dem Anstellwinkel A angeströmt. Der Vektor der Anströmgeschwindigkeit B ist der Bahngeschwindigkeit entgegengerichtet. In ihren Beträgen stimmen beide Größen überein. Mit Bahngeschwindigkeit ist dabei die Geschwindigkeit des Systems Fallschirmkappe-Springer bezüglich des Bezugssystems Luft gemeint. Das heißt, nur bei genau 0 m/s Bodenwind, also bei absoluter Windstille, stimmt diese Geschwindigkeit mit der über dem Erdboden beobachteten und tatsächlich für den Springer ausschlaggebenden Bahngeschwindigkeit überein.
Im Normalfall muss man also, um die entsprechenden Geschwindigkeiten über Grund zu erhalten, Vortrieb der Kappe und Windgeschwindigkeit einfach addieren bzw. beim Fliegen gegen Wind die Windgeschwindigkeit vom Vorschub subtrahieren.
Um zu bremsen, wird die Hinterkante der Fallschirmkappe mittels der Steuerleinen beiderseitig gleichmäßig heruntergezogen. Dadurch wird das Profil im hinteren Bereich gewölbt. Dieses gewölbte Profil besitzt aber einen höheren Widerstand. Und zwar wachsen zunächst sowohl der Auftriebsbeiwert ca als auch der Widerstandsbeiwert cw. Der Gesamt (Normal) Widerstandsbeiwert ergibt sich, da ca und cw senkrecht aufeinander stehen, als cn² = ca² + cw². Beim Durchwölben des Profils wachsen ca und cw aber nicht proportional. Vielmehr wächst cw schneller als ca. Das führt dazu, dass der Quotient ca/cw umso kleiner wird, je stärker der Schirm gebremst wird. Das Verhältnis von ca zu cw entspricht aber genau dem Gleitvermögen, das heißt, der so genannten Gleitzahl m der Fallschirmkappe.

Für die Gleitzahl gilt:

m = tan = ca/cw = V vor/ V sink

36

Diese Beziehung gilt im Bezugssystem Luft. Die Verringerung von m ist gleichbedeutend mit einer Verkleinerung des Gleitwinkels y. Bei konstanten Windverhältnissen nimmt C im gleichen Maße ab (vergl. Abb. 10). Beim Zielanflug wird im Idealfall so weit gebremst,
bis der Landewinkel C fast 0 wird, der Springer also nahezu senkrecht landet. Bei sehr kleinen Windgeschwindigkeiten müsste in diesem Fall auch der Gleitwinkel C sehr klein werden, wie Abb. 8 zeigt. Diese Abbildung verdeutlicht aber auch, dass mit einer Verkleinerung von G eine Erhöhung des Anstellwinkels A verbunden ist. Er kann nun aber nicht beliebig erhöht werden, denn wenn ein bestimmter kritischer Anstellwinkel erreicht wird, ist die Strömung nicht mehr in der Lage, der Profilkontur an der Oberseite des Flügels zu folgen. Die Grenzschicht löst sich bereits an der Profilvorderkante ab, und der Auftrieb des Tragflügelprofils bricht zusammen (vergl. Abb. 8). Übrig bleibt dann in erster Näherung nur noch ein „einfacher Widerstandskörper" von etwas über 20 m² Fläche. Dass dies für eine sichere Landung nicht ausreicht, dürfte allgemein einleuchten. (Selbst kleine Rettungsfallschirmkappen, die in konventioneller Rundkappenbauweise gefertigt sind, haben noch etwa die doppelte tragende Fläche!) Um der Forderung nach einem möglichst geringen Landewinkel, d. h. fast senkrechtem Zielanflug, auch bei wenig Wind gerecht zu werden, gehen die Bestrebungen bei der Entwicklung von Hochleistungssportfallschirmen deshalb allgemein dahin, Kappen zu bauen, die einen möglichst großen kritischen Anstellwinkel besitzen, oder besser gesagt, die über einen großen Anstellwinkelbereich hinweg stabil und flugfähig sind.

Neben der recht aufwendigen Suche nach Profilen, die diese Forderung immer besser erfüllen sollen, sind aus dem Flugzeugbau einige Methoden zur Auftriebserhöhung und Reduzierung der Landegeschwindigkeit bekannt.

Eine Möglichkeit ist die Anbringung eines
Vorflügels. Durch diesen wird die Strömung so
beeinflusst, dass sie im stark angebremsten Zustand, d.h. bei Erreichen eines relativ hohen Anstellwinkels an der Profiloberseite, weiterhin anliegt. Dieses Verfahren wurde bei den Kappen der RL-12-Baureihe aus DDR-Produktion in der

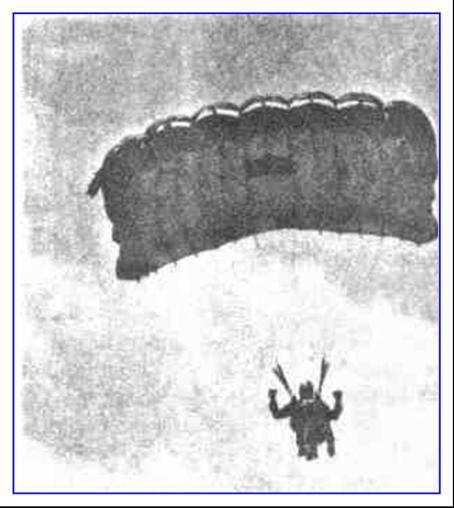
[picture p47: figure]

Welt erstmals für solche flexiblen Staukammergleitfallschirme angewandt. Dadurch konnte gegenüber den Vorgängermodellen eine spürbare Verbesserung der aerodynamischen Parameter erreicht werden. Abb. 9 zeigt schematisch die Strömungsverhältnisse an solch einer Vorflügelkappe. Die Abbildung verdeutlicht, dass auch im stark angebremsten Zustand die Luft, die durch den, Spalt an der Oberkappe ausströmt, dem sich stromabwärts an diese Stelle anschließenden Bereich der Profilkontur folgt. Auf Grund

37

dessen wird im hinteren Bereich des Profils noch ein Auftrieb erzeugt, wenn sich die Strömung an der Profilnase bereits ablöst. Das gestattet es, den Vortrieb einer solchen Kappe weiter abzubremsen als bei einer Kappe mit einem aerodynamisch gleichwertigen Profil ohne Vorflügel. Außerdem bringt der Vorflügel eine spürbare Auftrieberhöhung, also eine Verringerung der absoluten Landegeschwindigkeit durch Reduzierung der Sinkgeschwindigkeit.

Und weil die Strömung auch nach Erreichen des kritischen Anstellwinkels im Gebiet hinter dem Vorflügel und vor allem unter diesem noch anliegt und einen Auftrieb erzeugt, bricht die Fallschirmkappe auch in diesem überzogenen Zustand weder seitlich aus, noch rutscht sie nach hinten weg - ein Vorteil, den erfahrene Springer zum Abbau überschüssiger Höhe beim Zielanflug ausnutzen. Der Forderung nach einer möglichst geringen Landegeschwindigkeit könnte man formal natürlich auch mit entsprechend großen Kappenflächen gerecht werden. In gleichem Maße, wie die Sinkgeschwindigkeit verringert würde, nähme aber in diesem Fall auch die maximale Vorwärtsgeschwindigkeit ab.

Bekanntlich wird das Zielspringen bis zu 7 m/s Wind-geschwindigkeit durchgeführt. Das verlangt also eine maximale Vorwärtsgeschwindigkeit des Fallschirms von mindestens 8 m/s. Das ist besonders für sehr leichte Springer von Bedeutung, da sich mit dem Gewicht des Systems nicht nur die Sinkgeschwindigkeit, sondern in gleicher Weise auch die maximale Vorwärtsgeschwindigkeit erhöht. Und somit sind wir wieder bei der Frage, ob nicht durch konstruktive Veränderungen das Verhältnis von ca zu cw verbessert werden könnte. Ein Vergleich der international führenden Fallschirmtechnik zeigt, dass alle diese Kappen in ihrer maximalen Gleitzahl um den Wert ca/cw = 3 liegen. Eine Erhöhung dieses Wertes auch nur um ein paar Zehntel wäre jedoch beim derzeitigen Stand der Technik mit einem ungeheuer großen Aufwand und viel Feinarbeit am Profilverlauf selbst verbunden. Auch eine Vergrößerung der Kappenstreckung, d.h. der Einsatz von schmaleren Flügeln mit einem großen Verhältnis von Kappenbreite zu Kappentiefe, brächte hier keine durchschlagenden Erfolge. Außerdem kann die Breite einer Staukammer nicht beliebig erhöht werden, ohne dass dabei das Profil in unzulässiger Weise verzerrt würde. Man müsste also die Anzahl der Spanten erhöhen. International tauchen deshalb wohl auch vereinzelt Zielsprungkappen auf, die anstelle der allgemein üblichen sieben doppelten Staukammern neun besitzen und somit über ein größeres Streckungsverhältnis verfügen. Aber auch sie zeigen sich den anderen führenden Sportfallschirmkappen nicht überlegen. Unter anderem müssen an diesen gestreckten Kappen die Fangleinen verlängert werden, da sie sonst seitlich stärker gekrümmt würden. Eine generelle Leinenverlängerung wirkt sich aber negativ auf die Stabilität der Kappe aus und speziell auf den Kontakt, den der Springer zur Kappe hat.

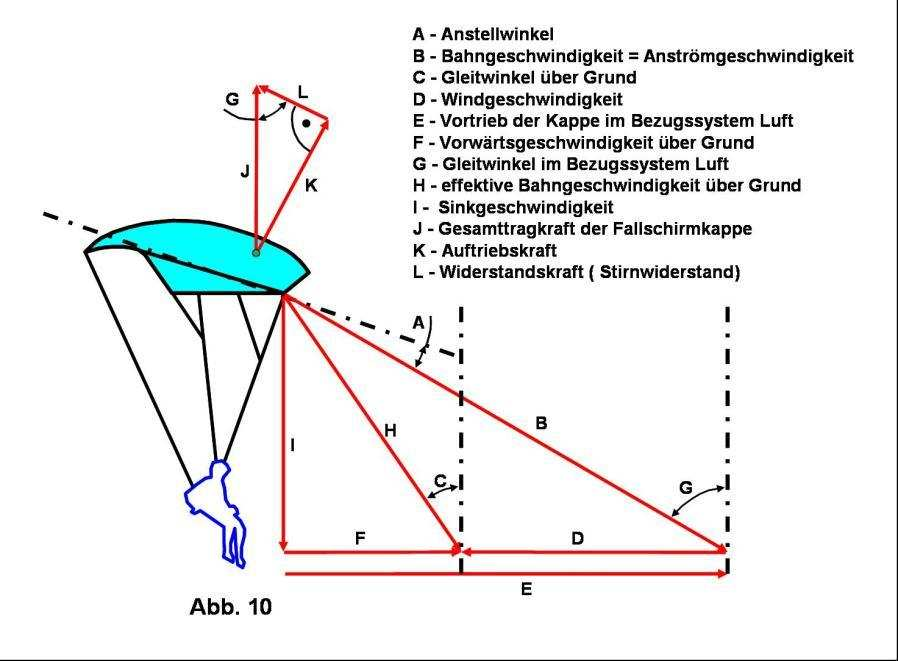
[picture p48: figure]

38

Eine Verkürzung der Fangleinen wiederum führt, wie bereits angedeutet, zu einer stärkeren Krümmung der Fallschirmkappe, bezogen auf die Querachse. Damit aber sind grundsätzlich eine Verschlechterung des Gleitvermögens und eine Erhöhung der Sinkgeschwindigkeit im angebremsten Zustand verbunden. Das lässt sich folgendermaßen erklären: Durch die seitliche Krümmung ist der Auftrieb, den die Randkammern liefern, nicht genau nach oben gerichtet, weil der Auftriebsvektor stets senkrecht auf der Kappenoberfläche steht. Je stärker die Kappe gekrümmt würde, desto stärker wäre also der Verlust an effektiver Auftriebskraft. Des Weiteren führt eine Verkürzung der Fangleinen indirekt zu einer Anstellungserhöhung am Kappenprofil, da der Vektor der Gesamtauftriebskraft im vorderen Teil der Kappe angreift und dadurch die Kappe beim Verkürzen der Fangleinen hinten stärker heruntergezogen wird als vorn. Die Erhöhung des Anstellwinkels bewirkt wiederum eine Abnahme der Bahngeschwindigkeit, Das heißt, im vollen Gleiten nehmen sowohl die Sinkgeschwindigkeit als auch der Vortrieb ab. Für die optimale Fangleinenlänge muss also der günstigste Kompromiss zwischen maximalem ca und maximaler Stabilität gesucht werden.
In diesem Zusammenhang sei eindringlich vor eigenmächtigen Veränderungen von Leinenlängen und Anstellungen derartiger Fallschirmkappen gewarnt!
Ziel künftiger Entwicklungen wird es also sein, bei einer weiteren Verbesserung des Steuer- und Bremsverhaltens die Sinkgeschwindigkeit und den Landewinkel in stark angebremstem Zustand zu verkleinern.
Dennoch können die Fachleute kein Gerät schaffen, das jede unkontrollierte Steuerbewegung des Springers hinnimmt, dass sich ohne Abreißen der Strömung über-

39

ziehen lässt. Der Flügelschirm muss wie ein Tragflügel geflogen werden. Die an der Kappe herrschenden aerodynamischen Gesetzmäßigkeiten kann kein Springer ungestraft ignorieren.

Fallschirm mit Polare

So liefert der Flügel beispielsweise nur in einem ganz bestimmten, genau ermittelten Anstellwinkelbereich Auftrieb. Immer stehen Auftrieb und Widerstand in einem ganz bestimmten Verhältnis zueinander. Dieses Verhältnis wird für ein ganz bestimmtes Profil, einen ganz bestimmten Tragflügel oder für das gesamte Luftfahrtgerät in der Polare dargestellt.
Auch von unseren Flügelschirmen bestehen solche Polaren. Je nach Stellung der Steuerknebel verläuft der Flug stets mit einem bestimmten Anstellwinkel. Ausgangspunkt ist die Nullstellung der Steuerknebel. Hierbei wird der Anstellwinkel durch die entsprechende Länge der Fangleinen garantiert. Es ist ein kleiner Anstellwinkel, bei dem die Kappe eine hohe Vorwärtsgeschwindigkeit entwickelt. Mit dem Herabziehen der Steuerknebel variiert nun der Springer entsprechend der Flugsituation den Anstellwinkel. Dabei wird die Hinterkante des Flügels nach unten gezogen, gewölbt. Das Profil wird somit verändert und der Anstellwinkel vergrößert (Abb. 10). Der Fallschirm reagiert darauf im Prinzip wie ein starrer Tragflügel beim Ausfahren von Wölbklappen. Der Gesamtwiderstand erhöht sich, und die Fluggeschwindigkeit wird verringert.

An dieser Stelle wollen wir uns kurz den Verhältnissen zuwenden, die beim Fliegen einer Kurve auftreten. Richtungsänderungen werden durch einseitiges Herunterziehen der Steuerknebel eingeleitet. Dabei wird die betreffende Hinterkante einseitig verwölbt. Die Wölbung bewirkt, dass für diese Seite ca/cw sinkt, woraus die Drehung nach dieser Seite resultiert.
Doch zurück zu unserer Polare. Sie entsteht, indem man in ein rechtwinkliges Achsenkreuz den Auftriebsbeiwert ca längs der senkrechten und den Widerstandsbeiwert cw längs der waagerechten Achse für verschiedene Anstellwinkel aufträgt. Dabei benutzt man im allgemeinen für den Widerstandsbeiwert einen etwa fünfmal größeren Maßstab als für den Auftriebsbeiwert, da die cw-Werte wesentlich kleiner sind als die ca-Werte und deshalb bei der Verwendung gleicher Maßstäbe die Widerstandsbeiwerte schlecht ablesbar wären. Für jeden Anstellwinkel, für den ein Wertepaar ca und cw zur Verfügung, steht, erhält man somit einen Punkt. Nun werden die Punkte miteinander verbunden. Die Wertepaare für die Punkte gewinnt man vorwiegend durch Modellmessungen im Windkanal.
Wir unterscheiden Profil-, Flügel- und Flugzeugpolare in Abhängigkeit davon, welche Widerstandsbeiwerte in die Polare eingehen. So enthält die Flügelpolare neben dem Reibungs- und Formwiderstand auch den induzierten Widerstand. In die Gesamtpolare geht neben dem Flügelwiderstand auch der schädliche Widerstand mit ein, der jedoch beim Flügelschirm im Gegensatz zum Flugzeug nicht sehr groß ist. Er setzt sich lediglich aus dem Widerstand zusammen, der durch den Springer und die Fangleinen entsteht. Dieser Widerstand des Fallschirmspringers wurde bei all unseren bisherigen Überlegungen vernachlässigt. Beim vollen Gleiten wird der Springer durch den angreifenden Fahrtwind etwas zurückgedrückt, und das gesamte System

40

Fallschirm - Springer wird um einen bestimmten Winkel gedreht. Dieser mit der Wirkung eines Ruders zu vergleichende Einfluss des Springers dreht die gesamte Flugbahn um diesen Winkel nach unten, bewirkt also eine geringfügige Verschlechterung des Gleitvermögens. Bei leichten Brisen erhöht sich der Gesamtwiderstandsbeiwert cn zunächst so, dass seine beiden Komponenten ca und cw annähernd proportional wachsen. Da aber, bedingt durch die Vergrößerung von cn, die Bahngeschwindigkeit und somit auch der Vorschub der Kappe geringer sind, wird der Springer vom Fahrtwind nicht mehr so stark zurückgedrückt; die Flugbahn wird etwas flacher, und die Kappe erreicht hier ihr optimales Gleitvermögen (Bezugssystem Luft); sie wird insgesamt langsamer, d. h., Sinkgeschwindigkeit und Vortrieb im vollen Gleiten nehmen ab. Damit ist beim Fliegen mit der Windrichtung eine Vergrößerung der Flugstrecke, also der Reichweite, verbunden, denn das System Kappe-Springer befindet sich länger in der Luft und wird also längere Zeit vom Wind getrieben. Beim Fliegen gegen den Wind tritt schon bei geringen Windgeschwindigkeiten der gegenteilige Effekt ein. Hier hilft bei zu flachem Aufbau des Zielanfluges ein gefühlvolles Herunterziehen der vorderen Zwischengurte. Durch die damit verbundene Verringerung des Anstellwinkels der Kappe nimmt cn ab, die Bahngeschwindigkeit wird größer, und die Kappe läuft besser gegen den Wind. Aber Vorsicht! Zugleich erhöht sich auch die Sinkgeschwindigkeit.

Unmittelbar vor der Landung sind deshalb die vorderen Zwischengurte unbedingt wieder loszulassen, und die Kappe ist in gewohnter Weise zu steuern.
Bei wenig Wind oder Windstille führt dieses Verfahren allerdings nicht zum Erfolg. Hier hilft ein ganz leichtes Bremsen. Auch kann z. B. durch Anziehen der Beine der schädliche Widerstand verringert werden.

Diese Sachverhalte beruhen in ihrem Erscheinungsbild auf den spezifischen aerodynamischen Eigenschaften der Fallschirmkappe. Es gibt auch Gleitfallschirme, deren Leinen so eingestellt sind, dass in Verbindung mit dem Profil beim leichten Bremsen ca zunächst schneller wächst als cw, da der Quotient ca/cw größer wird. Nur wenn ca schneller wächst als cw, erhöht sich die Auftriebskraft K wirklich, da die Vektorsumme aus den beiden senkrecht zueinander stehenden Komponenten K‚ Auftriebskraft und L (Widerstandskraft) gleich dem Gesamtwiderstand K ist. Eine solche Kappe reagiert zunächst auch bei höheren Windgeschwindigkeiten auf ein leichtes Bremsen, z.B. beim Zielanflug, nicht mit einer Neigung, sondern mit einem Anheben der Flugbahn. Hierbei spielen auch dynamische Effekte eine Rolle. So zeigen z. B. alle Gleitfallschirme beim stetigen Durchziehen der Steuerleinen aus dem Gleiten heraus ein mehr oder weniger dynamisches Aufgleiten, was mit dem Abfangen eines Flugzeuges bei der Landung verglichen werden kann. Die plötzliche Anstellungserhöhung beim Bremsen führt zu einer Verlagerung des stärksten Teils des Unterdruckgebiets über dem Profil in den hinteren Bereich des Flügels. Es wird durch eine verstärkte Strömung von der Druckseite (Profilunterfläche) her vor allem über die Profilnase ausgeglichen.

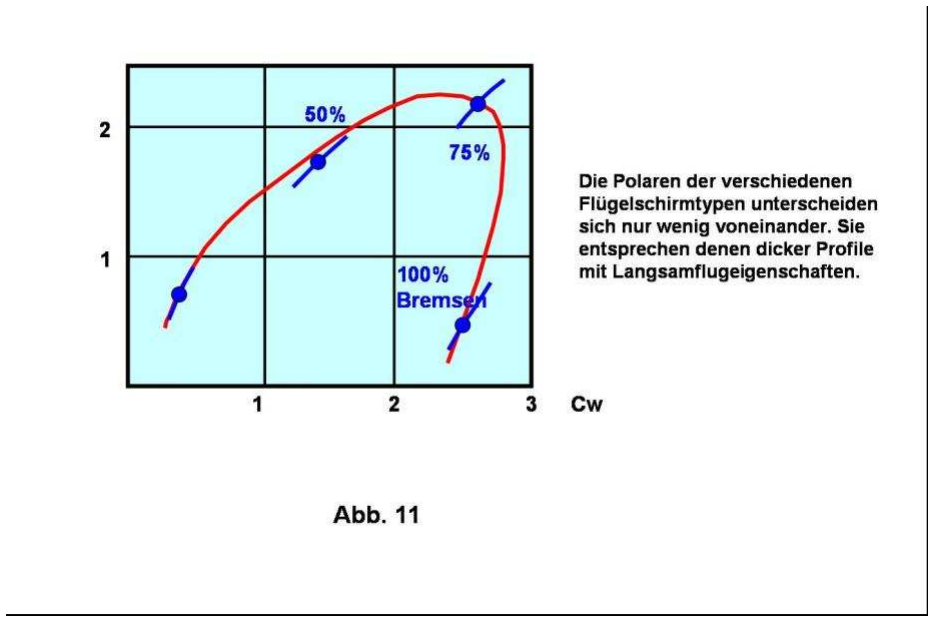
[picture p49: figure]

41

Die verstärkte Strömung und das Unterdruckgebiet selbst erzeugen kurzzeitig einen erhöhten Auftrieb, der zusammenbricht, wenn das Unterdruckgebiet ausgeglichen ist. Der Flügel ist dann überzogen und quittiert diesen Zustand mit erhöhtem Sinken. Die günstigste Höhe zur Ausnutzung dieses Aufgleiteffektes schwankt in Abhängigkeit davon, wie ausgeprägt die betreffende Kappe dieses Verhalten zeigt, zwischen etwa 1 und 4 m. Bei Kappen mit Vorflügel, wie ihn die RL-12-Serien besitzen, füllt sich das Unterdruckgebiet auch durch den Spalt in der Oberkappe. Deshalb zeigen sie dieses Überziehverhalten nicht so ausgeprägt. Daraus folgt aber, dass solche Kappen sehr direkt und sofort alle vom Springer eingeleiteten Steuermaßnahmen sehr präzise und ohne Verzögerung ausführen. Beim Bremsen mittels der Steuerleinen wird die Flugbahn sofort gedrückt und beim Nachlassen der Steuerleinen angehoben. Allerdings ist auch diese positive Eigenschaft wieder mit einem Kompromiss verbunden: Eine Kappe, die auf kleinste Steuerreaktionen sofort anspricht, ist auch anfälliger gegenüber thermischen Einflüssen und anderen Störungen, da diese, ebenso wie die Beeinflussung der Kappe durch die Steuerleinen, eine Kappendeformation hervorrufen. Bei exakt arbeitender Steuerung kann das ein erfahrener Springer jedoch sofort kompensieren.
Aber kehren wir wieder zu der Polare zurück. Wir wollten ja wissen, welche Informationen sie für uns enthält. Mit größer werdendem Anstellwinkel, das zeigt die Kurve (Abb. 11), steigen zunächst Auftriebs- und Widerstandsbeiwert kontinuierlich an. Bei einem bestimmten Anstellwinkel nimmt ca aber wieder ab. Das heißt, der Auftrieb bricht zusammen, da sich jetzt die Grenzschicht der Strömung über die

42

winkel erreicht hat (wir nennen ihn kritischen Anstellwinkel), ist er nicht mehr tragfähig. Je nach Schirmtyp kann es dabei - wie im vorigen Abschnitt festgestellt - zu einem seitlichen Wegrutschen oder zu einem Abkippen nach hinten kommen. Dieser überzogene Flugzustand ist in großen - Höhen völlig ungefährlich, und ein Nachlassen der Steuerknebel schafft sofort Abhilfe. Allerdings kann es beim plötzlichen Durchziehen oder Nachlassen der Steuerleinen auf Grund der Masseträgheit zu beträchtlichen Pendelausschlägen kommen. In Bodennähe ist dieser Vorgang deshalb durchaus gefährlich; er könnte wegen der damit verbundenen Erhöhung der Sinkgeschwindigkeit zu ernsthaften Verletzungen des Springers fuhren. Plötzliche Änderungen von Windgeschwindigkeit und -richtung können ebenfalls einen aerodynamisch überzogenen Zustand der Kappe hervorrufen, wenn längere Zeit mit stark abgebremstem Vorschub geflogen wird. Wenn wir am Schluss dieses Beitrages noch einmal auf die Gefahren eingingen, die mit dem Fliegen im Bereich des kritischen Anstellwinkels auftreten können, dann nicht, um irgendjemand Angst vor diesem Sportfallschirmtyp zu machen. Der Flügelschirm ist ein wunderbares, attraktives und leistungsfähiges Luftfahrtgerät. Sein Profil trägt zu hervorragenden Zielsprungergebnissen ebenso wie zu einer hohen Sicherheit bei, denn der große Anstellwinkelbereich verleiht dem Flügel eine Gutmütigkeit, die vergleichbar ist mit der von Flugzeugen mit Kurzstart- und -landeeigenschaften. Der Springer muss sich jedoch stets bewusst sein, dass er unter einem aerodynamischen Flügel hängt und die Entfernung zwischen Öffnungshöhe und Landeplatz nicht fallend, sondern fliegend überwindet!

# Der Springer im „freien Fall“

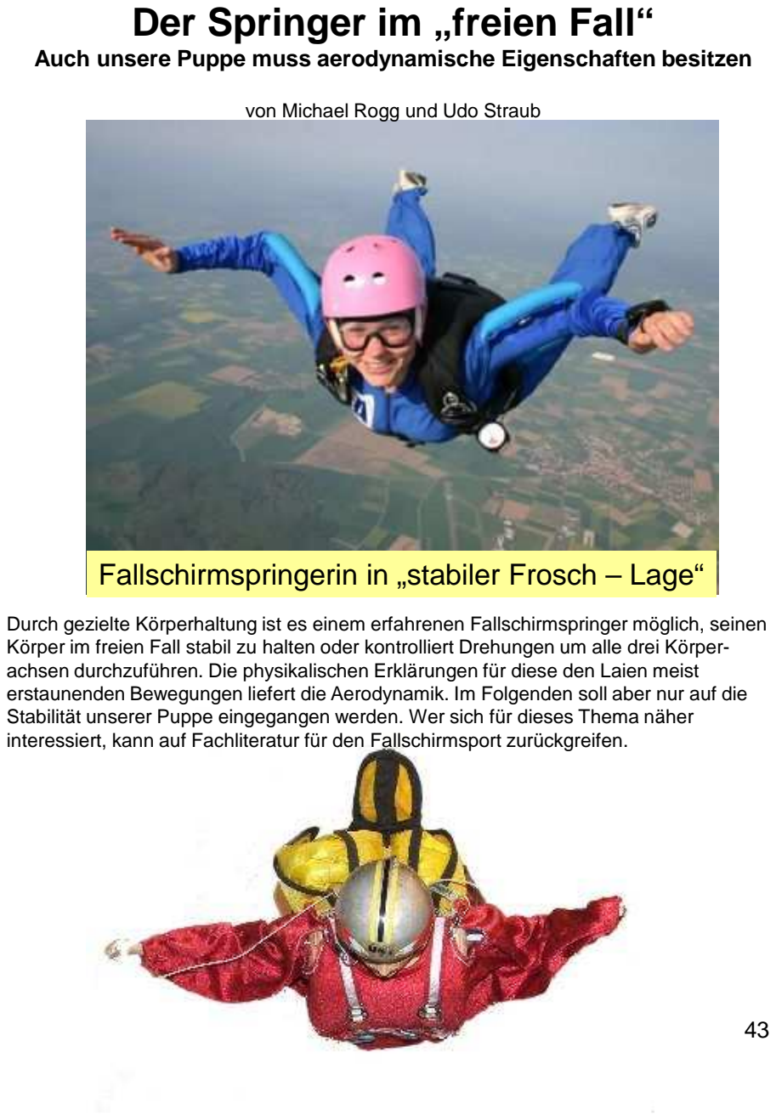
[picture p50: page 43]

Auch unsere Puppe muss aerodynamische Eigenschaften besitzen

von Michael Rogg und Udo Straub

43

## Fallschirmspringerin in „stabiler Frosch – Lage“

Durch gezielte Körperhaltung ist es einem erfahrenen Fallschirmspringer möglich, seinen Körper im freien Fall stabil zu halten oder kontrolliert Drehungen um alle drei Körperachsen durchzuführen. Die physikalischen Erklärungen für diese den Laien meist erstaunenden Bewegungen liefert die Aerodynamik. Im Folgenden soll aber nur auf die Stabilität unserer Puppe eingegangen werden. Wer sich für dieses Thema näher interessiert, kann auf Fachliteratur für den Fallschirmsport zurückgreifen.

Chaos im freien Fall?

Lässt man einen neuen Springer länger im freien Fall, wird er – leider – oft zwei Unarten zeigen. Er wird entweder schaukeln oder sich drehen – oder beides zugleich. Sowohl heftiges Schaukeln als auch Drehen kann Fehlöffnungen verursachen.
Die Puppe im freien Fall

Unsere Puppe kann nur die Arme und eingeschränkt die Beine bewegen. Damit diese aber stabil fällt muss bei der Konstruktion einiges beachtet werden. Als stabile Lage für einen Fallschirmspringer kenne wir die „Große X-Lage“ und die „Froschlage“. Die Übergänge zu beiden Lagen sind für einen Fallschirmspringer fliesend.

Unser Ziel soll es sein, die Puppe so im freien Fall haben, das der Körper wagrecht und ohne Drehungen fällt. Denn nur so ist eine fehlerfreie Schirmöffnung möglich. Fällt der Springer mit dem Kopf zuerst, könnte sich der Schirm in den Füßen verfangen. Dreht sich der Körper, wird unser Schirm Verdrehungen haben, die dann das Stern nicht mehr ermöglichen.

44

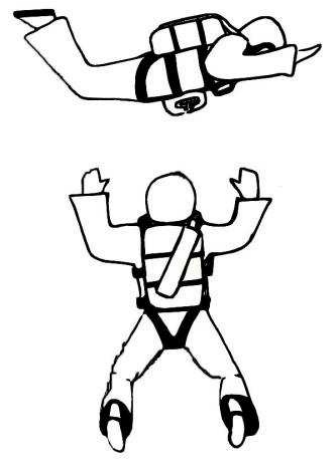
[picture p51: figure]
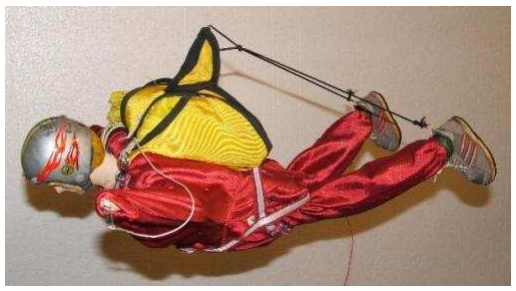
[picture p52: figure]

Für unsere Puppen hat sich die „Froschlage“ als die effektivste erwiesen. Dabei wird durch die Anordnung der Arme und Beine im freien Fall ein Hohlkreuz erzeugt. Wenn dann der Akku im Bauch nach vorne platziert wird, fällt der Springer schon mal mit dem Bauch zuerst.
Sind die Arme und Beine symmetrisch geformt und gleich schwer, wird der Springer sich auch nicht drehen.

Beruhigungsmittel freier Fall

Behandeln wir zuerst das Schaukeln. Damit ist ein unruhiges Flugverhalten entlang der Längsachse gemeint. Es ist von Modellflugzeugen auch als „Pumpen“ bekannt. Das Schaukeln oder Pumpen ist ein untrügliches Zeichen dafür, dass der Schwerpunkt nicht sauber im schon wiederholt zitierten Bierbauch liegt. Für gewöhnlich beginnt die Schaukelbewegung des Springers damit, dass die Arme etwas abtauchen. Dann muss Blei in die Füße. Manchmal kann eine Schaukelbewegung auch mit der Jahrzehnte alten Mantatechnik behoben werden: tiefer legen - und zwar den Bierbauch. Man gestaltet den Winkel zwischen Körper und Beinen spitzer, indem man die Kante der Oberschenkel etwas nachschleift. Bitte machen Sie einige Testsprünge noch ehe die Schleiflatte an den Kniekehlen kratzt und Ihr Springer tatsächlich mit der Silhouette eines Federballs vom Himmel stürzt.

45

Drehen

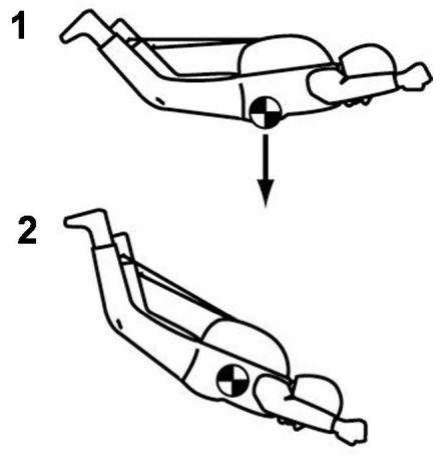
[picture p53: figure]

Nun zum Drehen. Die RC-Puppe dreht sich dabei um ihren Bauchnabel. Es sieht aus wie eine Art Flachtrudeln. Kommt das Drehen eher selten vor, ist es langsam und einmal nach der einen, dann wieder nach der anderen Seite gerichtet, dürfen Sie Glückwünsche entgegen nehmen. Besser kann man nicht bauen. Gelegentliches, nicht zu schnelles Drehen kann man beenden, indem man mit den Armen gegensteuert. Dreht die Puppe nach links, fährt man den rechten Arm etwas aus usw. Dazu sei eine kleine Denkübung erlaubt. Da wir den Springer von unten beobachten und er auf uns zufliegt, bedeutet eine Drehung entgegen dem Uhrzeigersinn eine… Rechts-Drehung. Der Knüppel am Sender muss nach… links, damit der… linke Arm ausschlägt.
Vergessen Sie auf keinen Fall, den entsprechenden Arm für den Öffnungsvorgang wieder in die obere Endposition zu fahren. Das Servogetriebe wird es Ihnen danken.
Dreht sich der Springer jedoch schnell und stets zur gleichen Seite, ist der Hobbychirurg gefragt. Man öffnet den Körper und klebt mit etwas Silikon Blei an die Innenseite einer Rumpfwand. Auch hier gilt: Im Falle einer Rechtsdrehung muss das Blei nach links etc.

# Impressum

## Beiträge von:

Udo Straub, Hangweg 19, 97616 Bad Neustadt/ S.

## Tel.: 09771 – 3329, Mail: strudo@t-onine.de

## Michael Rogg, Hausen 22, 86807 Buchloe Tel: 08246 – 1422, Mail: rgkestrel@aol.com

## Quellennachweis:

## Zeitschrift FLIEGER – REVUE , Ausgabe 6 u. 7/1984

46

## Möller Buch und Zeitschriften Verlag GmbH Oraniendamm 48, D-13469 Berlin

## www.fliegerrevue.de

## Inhalt zusammengestellt von Udo Straub – 2007

Stand Februar 2010

Deutscher Modellflieger Verband e.V.

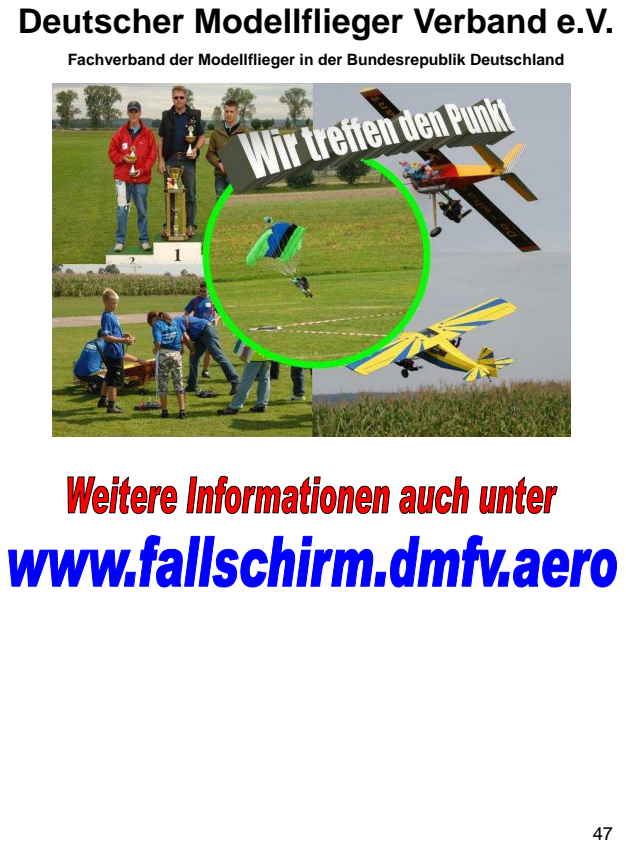
[picture p54: page 47]

Fachverband der Modellflieger in der Bundesrepublik Deutschland
