YohanHadji/R2Home/Parachute Design Ressources/Plans/Simple/DEST2266.pdf

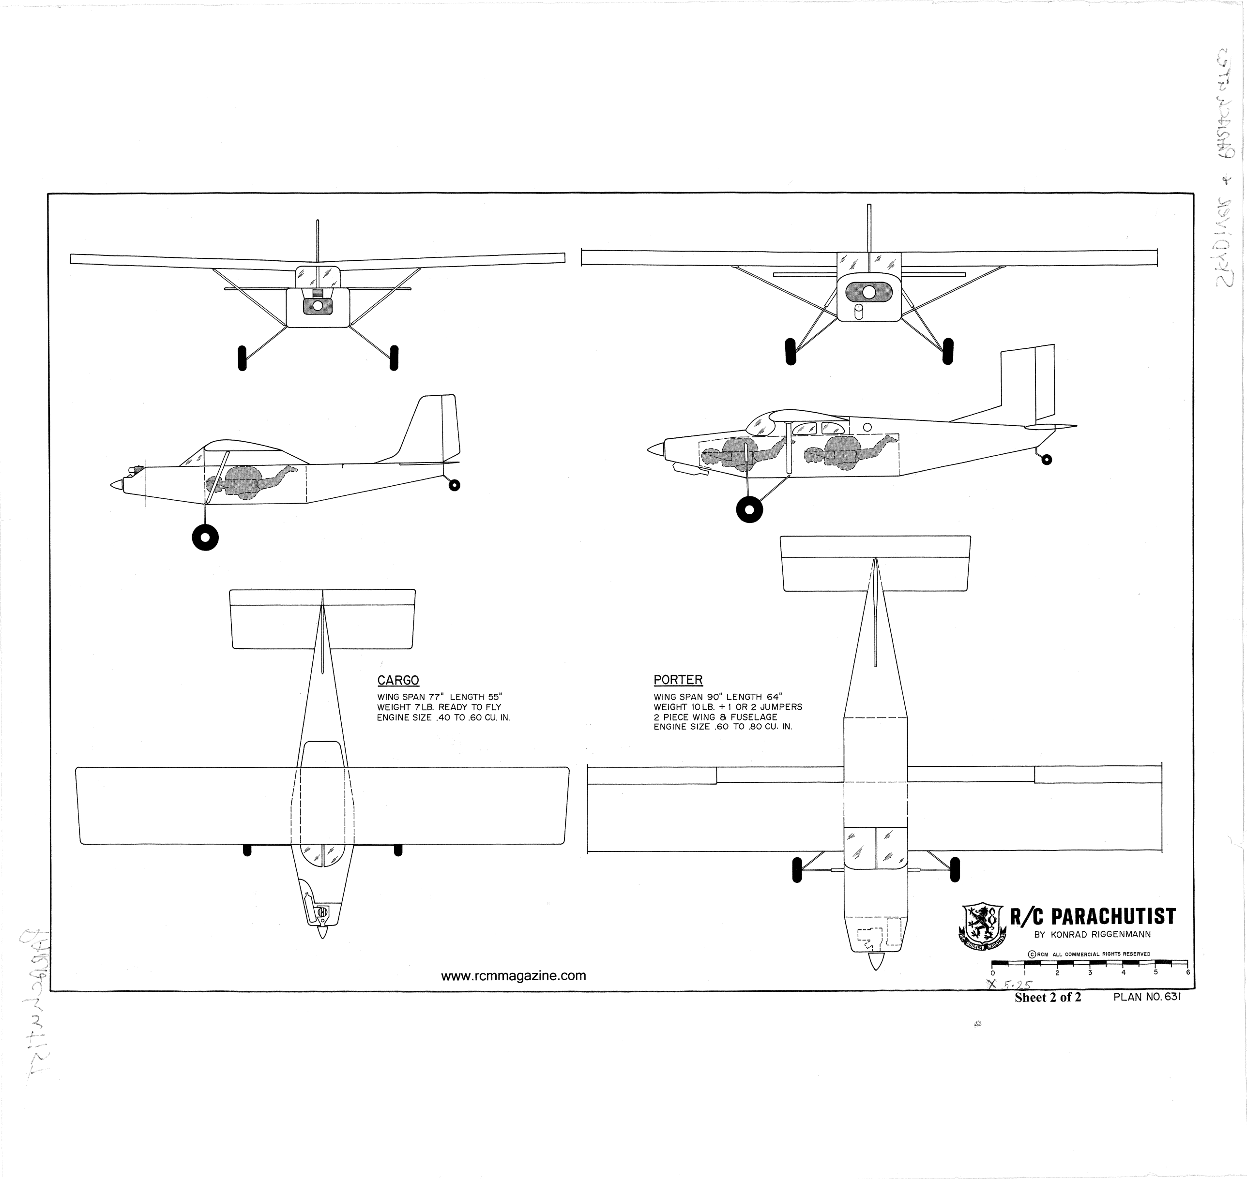
[picture p55: page 1]
