YohanHadji/R2Home/Parachute Design Ressources/Plans/Simple/DEST2267.pdf

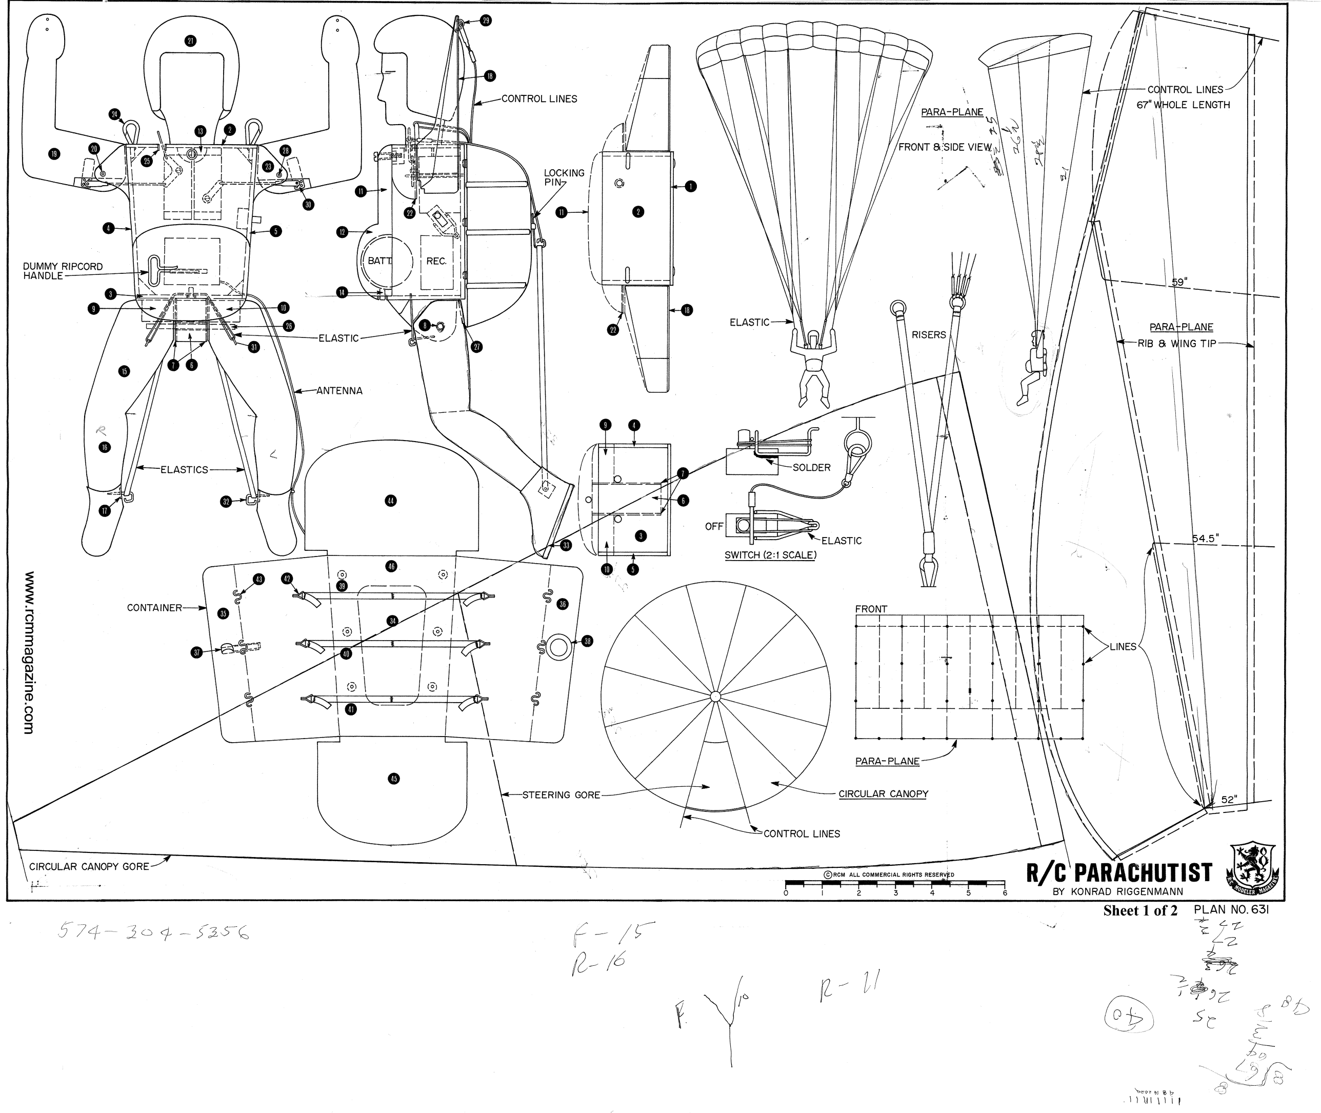
[picture p56: page 1]
