YohanHadji/R2Home/Parachute Design Ressources/Plans/Simple/RC_Parachutist_oz6168.pdf

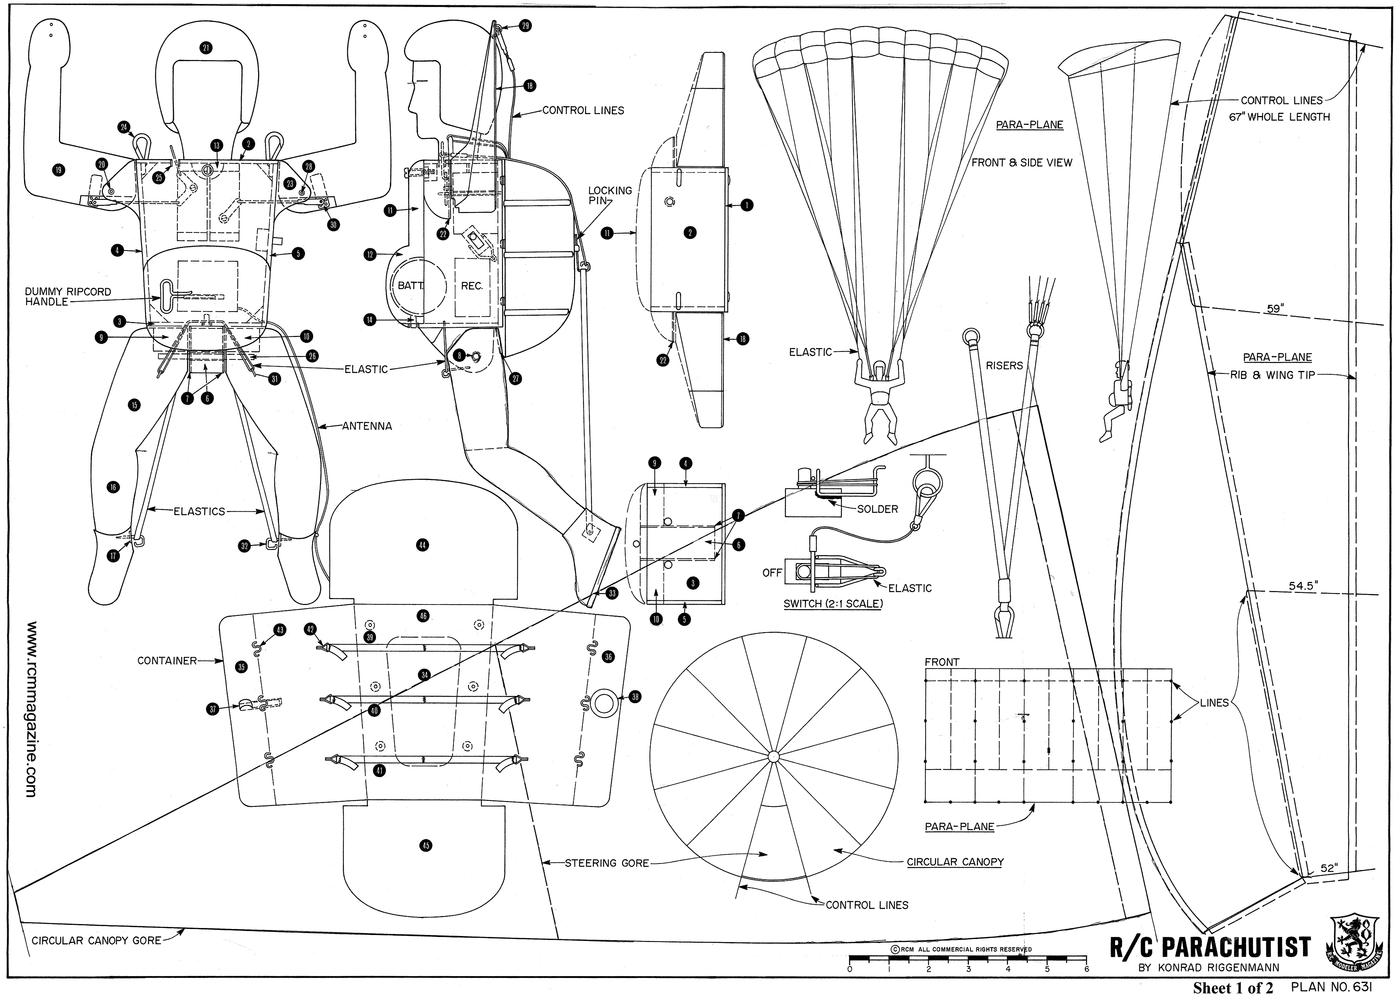
[picture p57: page 1]
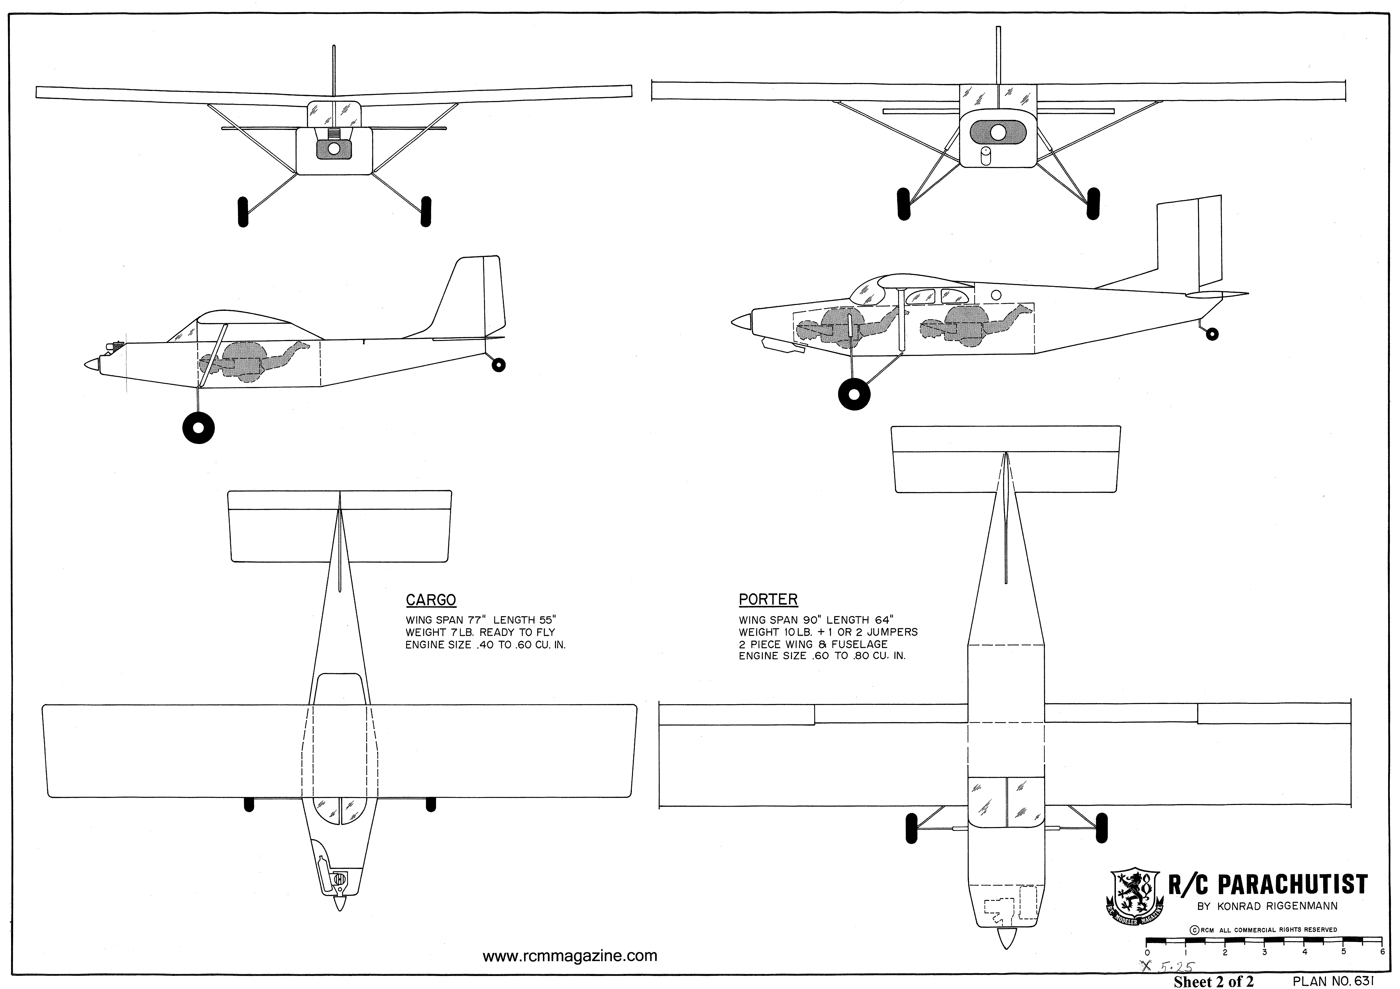
[picture p58: page 2]
