YohanHadji/R2Home/Image/Autopilot_flight_data.png

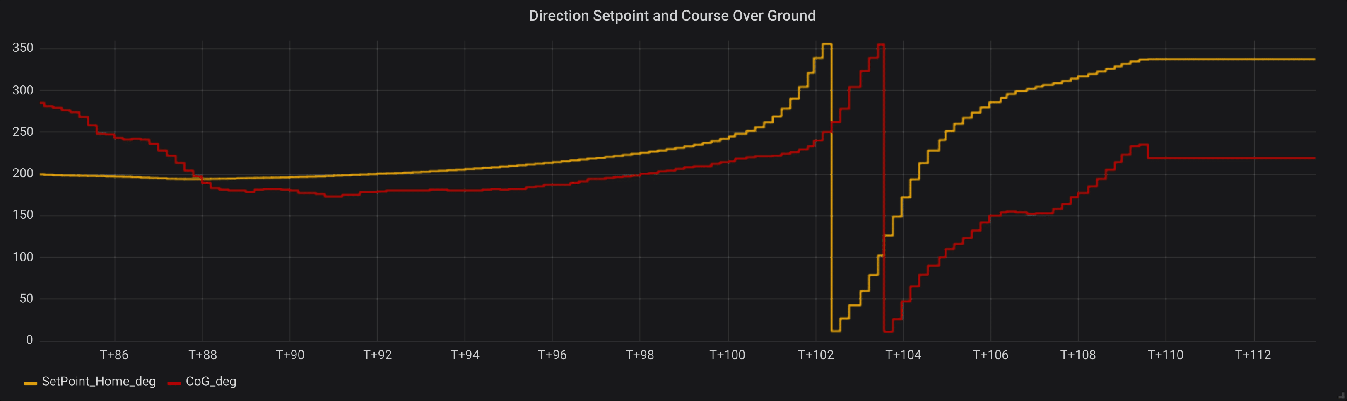
Image/Autopilot_flight_data.png
