YohanHadji/R2Home/Image/Autopilot_trace_B.png

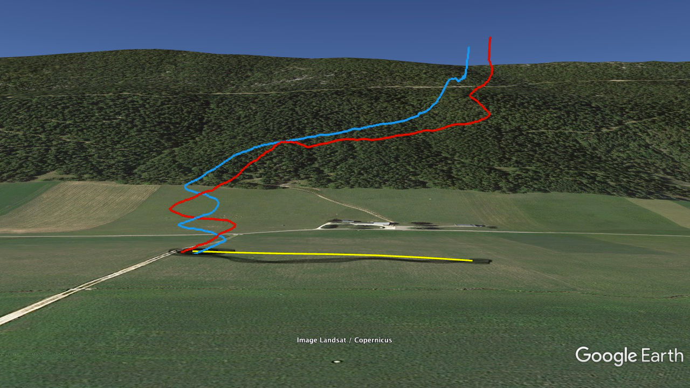
Image/Autopilot_trace_B.png
