YohanHadji/R2Home/Image/Banana_for_scale.jpg

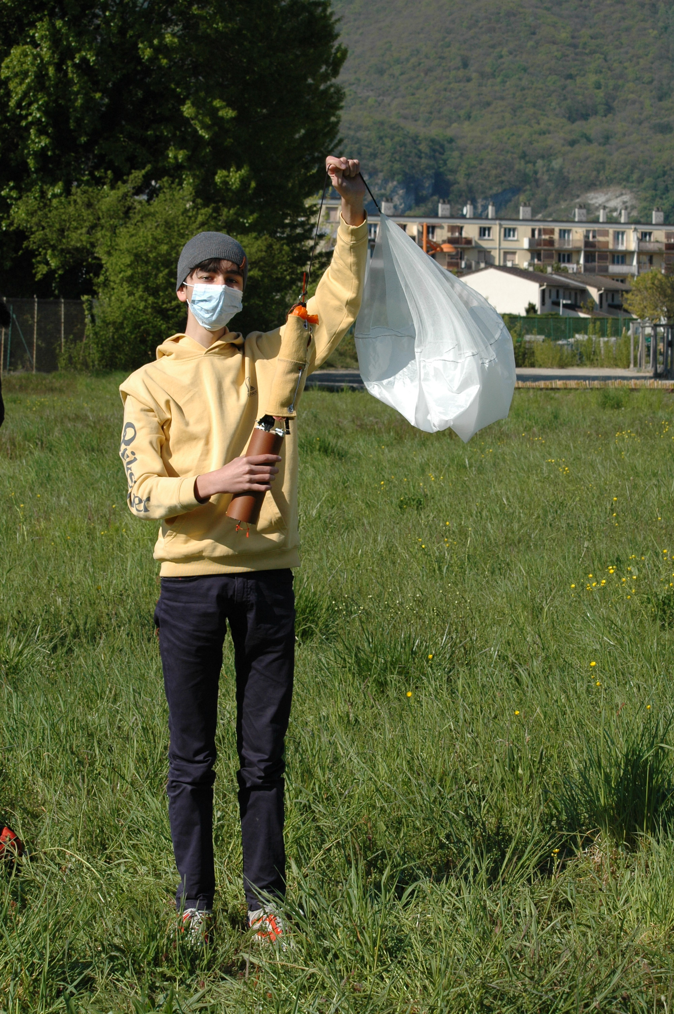
Image/Banana_for_scale.jpg
