YohanHadji/R2Home/Image/bottom_closure.jpg

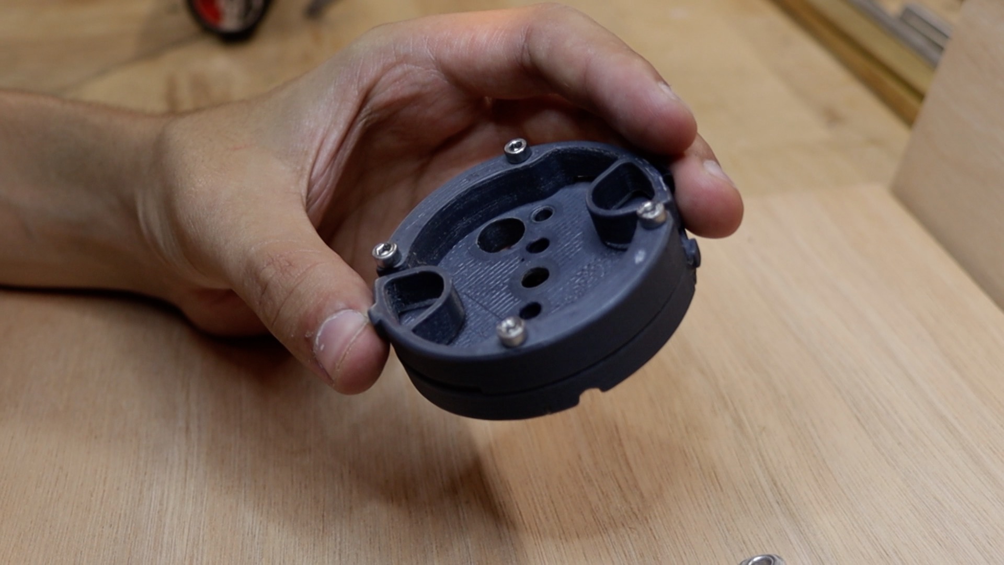
Image/bottom_closure.jpg
