YohanHadji/R2Home/Image/Computer.jpg

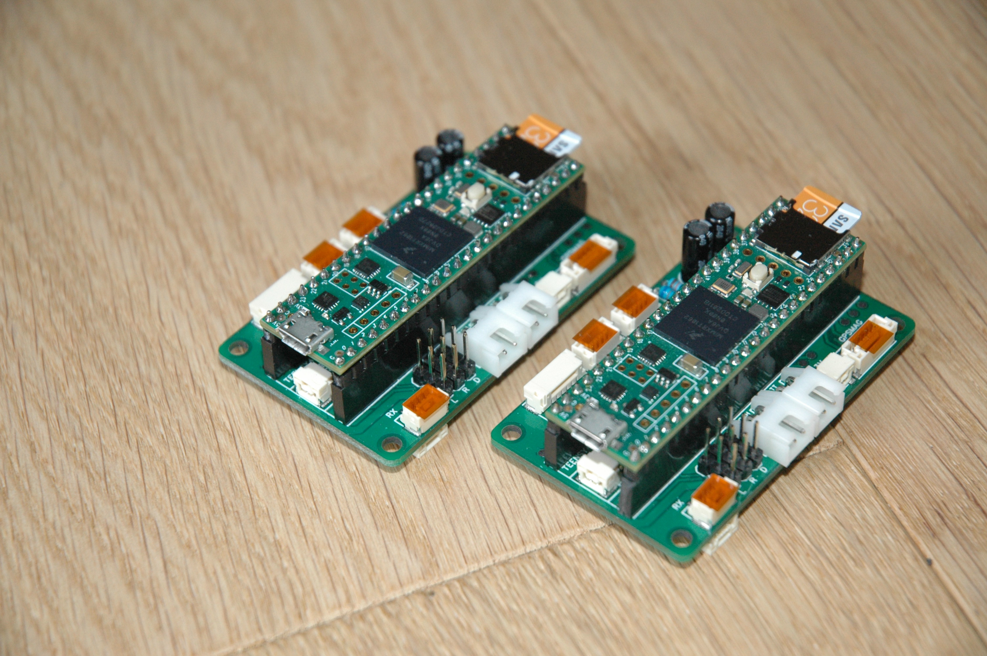
Image/Computer.jpg
