YohanHadji/R2Home/Image/Computer_2.jpg

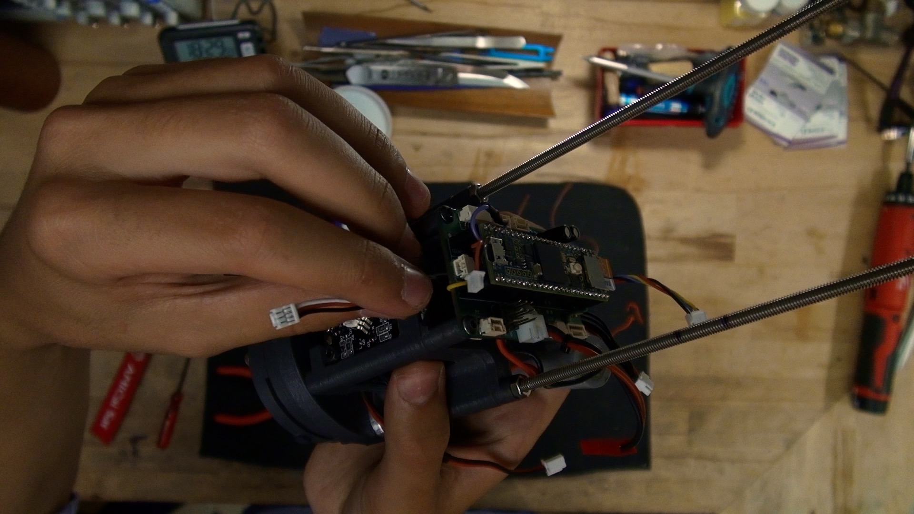
Image/Computer_2.jpg
