YohanHadji/R2Home/Image/Deployment.png

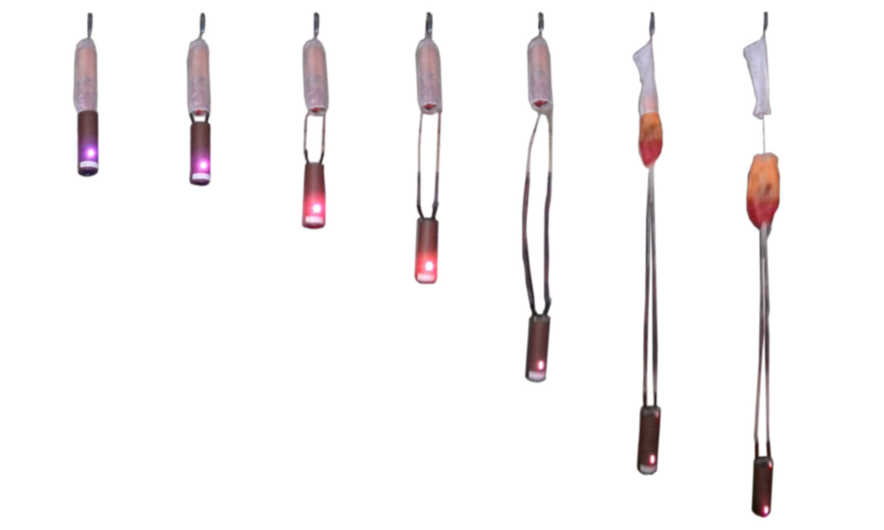
Image/Deployment.png
