YohanHadji/R2Home/Image/Details_Dbag_A.jpg

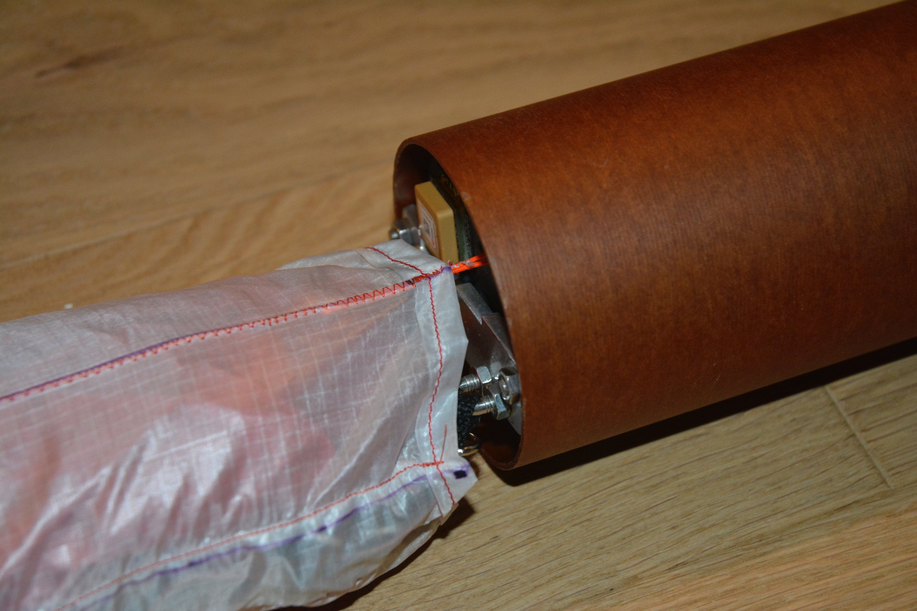
Image/Details_Dbag_A.jpg
