YohanHadji/R2Home/Image/Details_Dbag_B.jpg

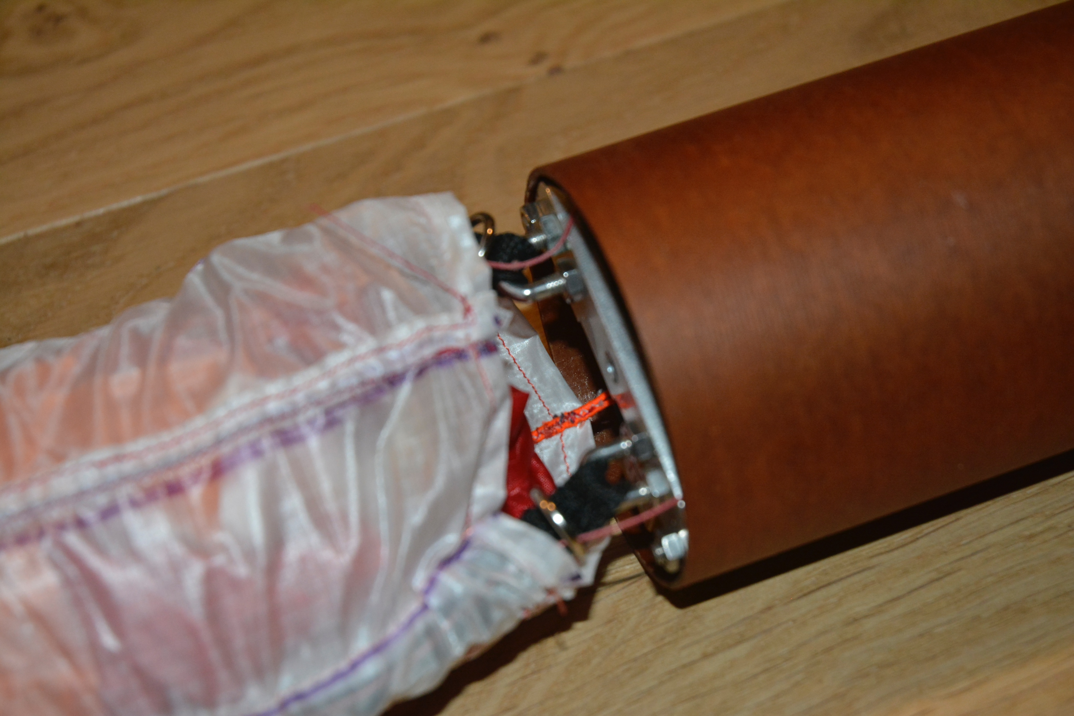
Image/Details_Dbag_B.jpg
