YohanHadji/R2Home/Image/Drogchute_After.jpg

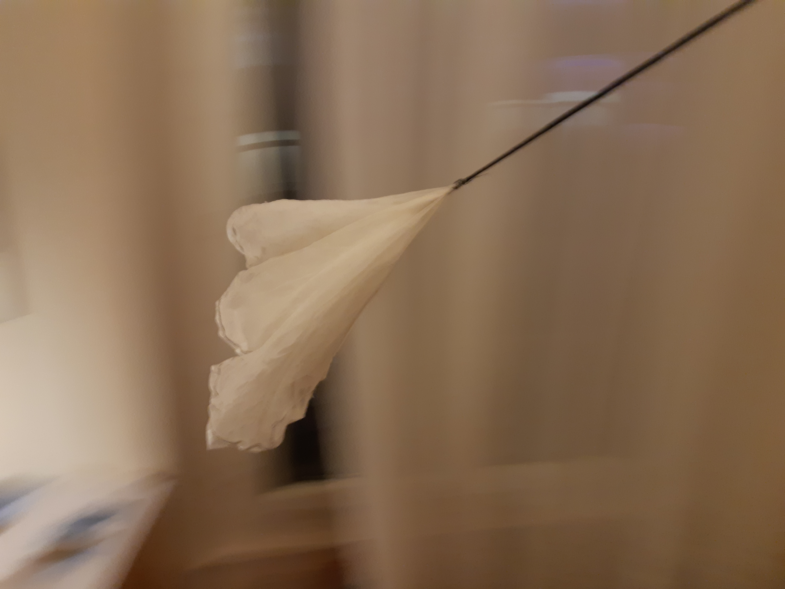
Image/Drogchute_After.jpg
