YohanHadji/R2Home/Image/drogchute_dbag.png

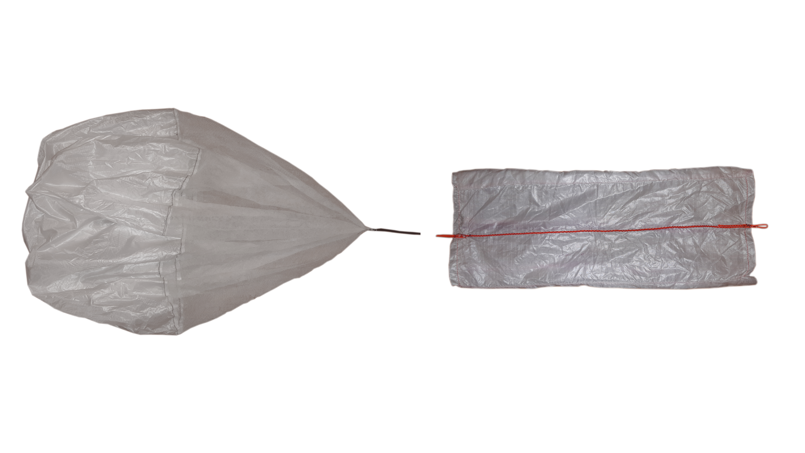
Image/drogchute_dbag.png
