YohanHadji/R2Home/Image/Drone_B.jpg

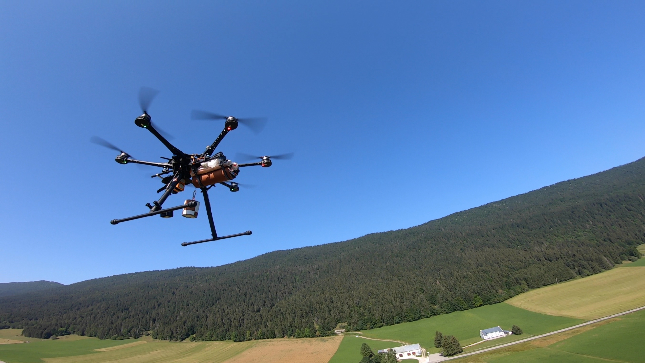
Image/Drone_B.jpg
