YohanHadji/R2Home/Image/Drone_D.jpg

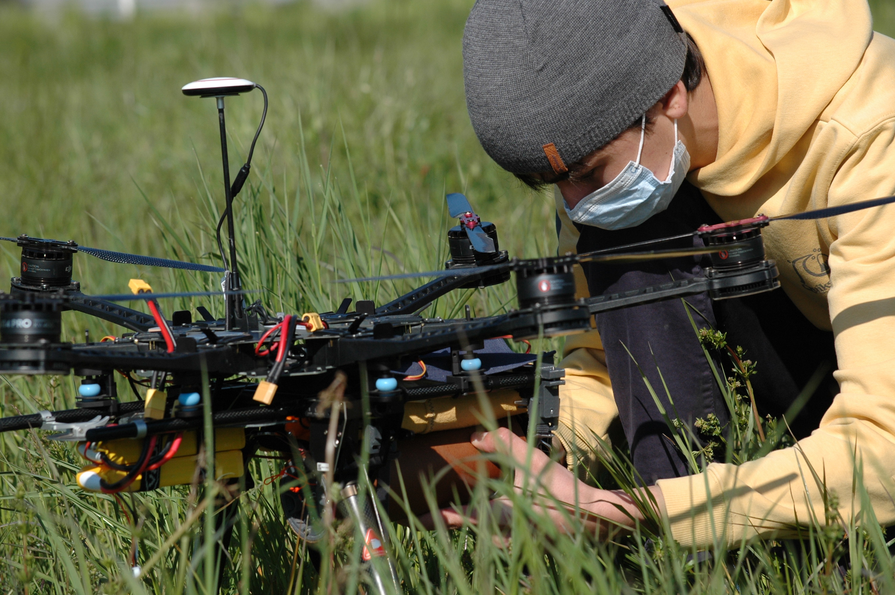
Image/Drone_D.jpg
