YohanHadji/R2Home/Image/folding.png

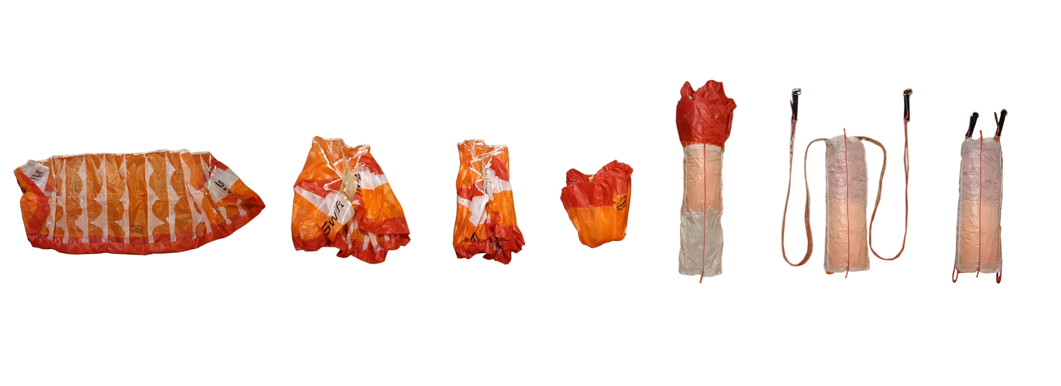
Image/folding.png
