YohanHadji/R2Home/Image/in_left_turn.jpg

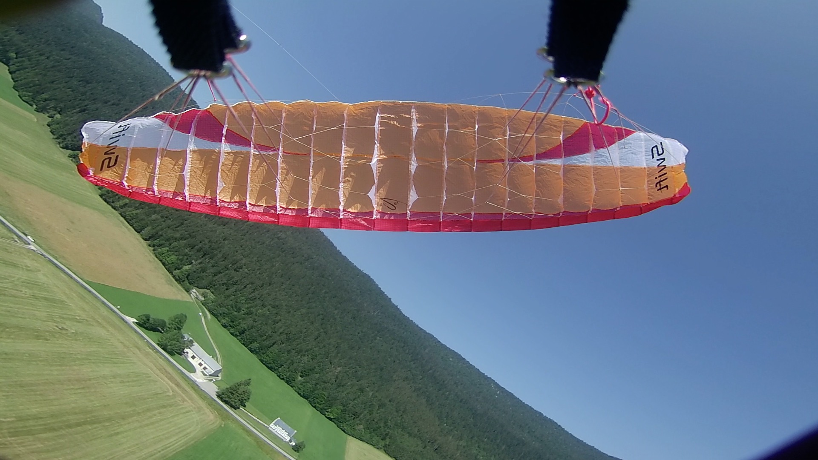
Image/in_left_turn.jpg
