YohanHadji/R2Home/Image/in_right_turn.jpg

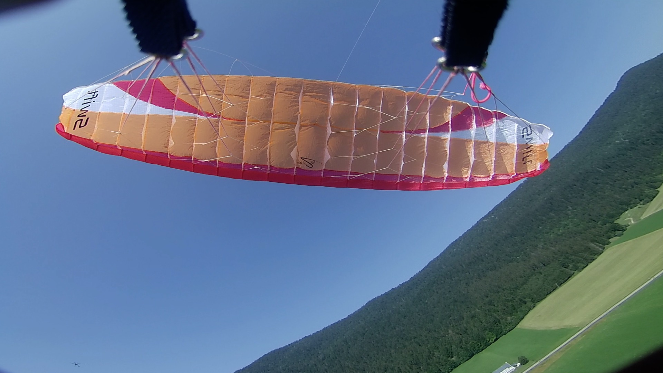
Image/in_right_turn.jpg
