YohanHadji/R2Home/Image/Landing_Pano_B.png

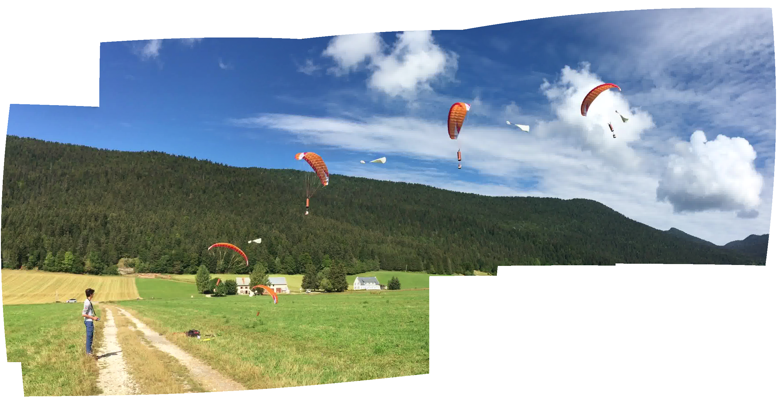
Image/Landing_Pano_B.png
