YohanHadji/R2Home/Image/Landing_Pano_C.png

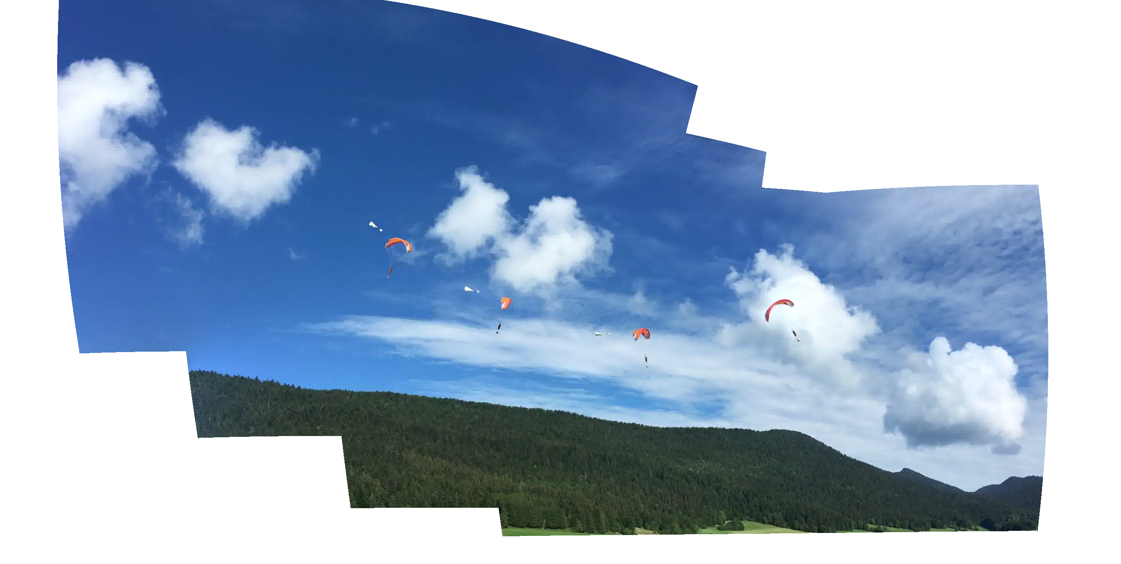
Image/Landing_Pano_C.png
