YohanHadji/R2Home/Image/Motorised_A.jpg

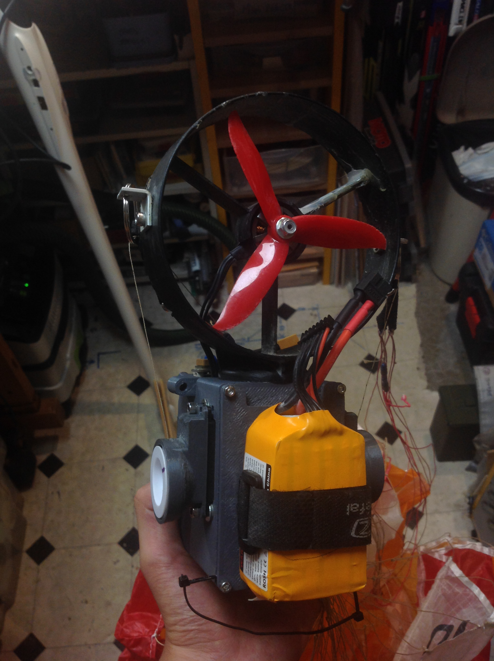
Image/Motorised_A.jpg
