YohanHadji/R2Home/Image/Motorised_B.jpg

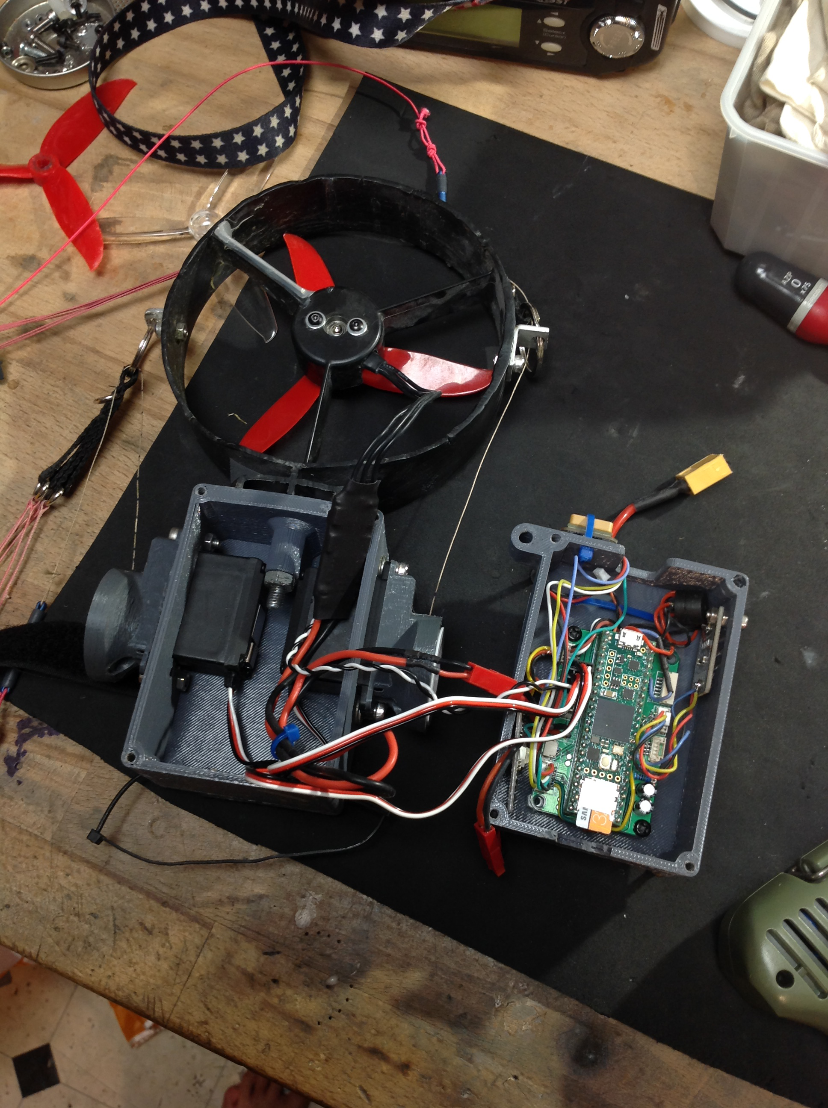
Image/Motorised_B.jpg
