YohanHadji/R2Home/Image/Project_Picture.jpg

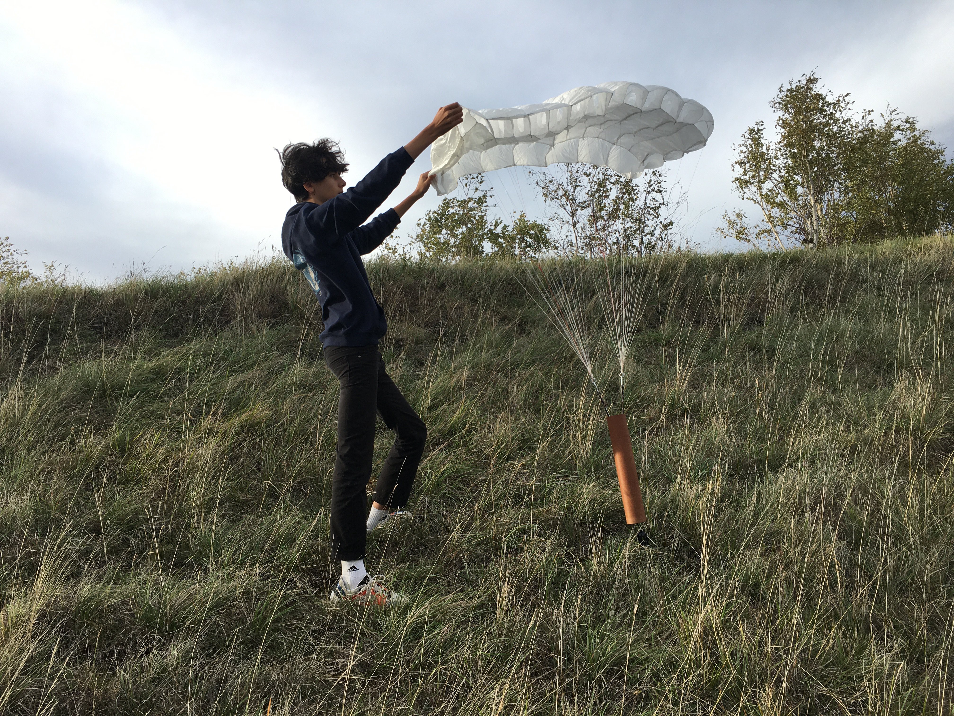
Image/Project_Picture.jpg
