YohanHadji/R2Home/Image/Prototype_A.jpg

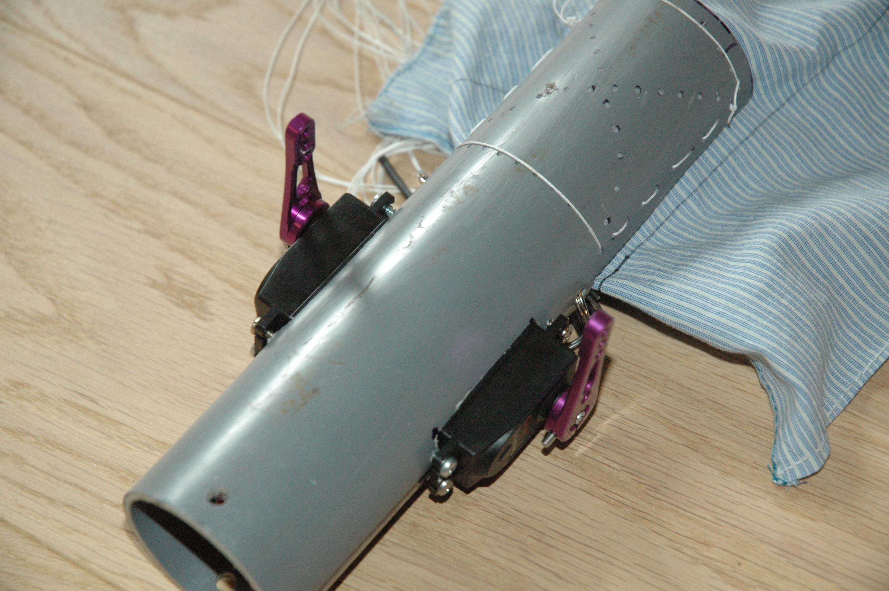
Image/Prototype_A.jpg
