YohanHadji/R2Home/Image/Prototype_B.jpg

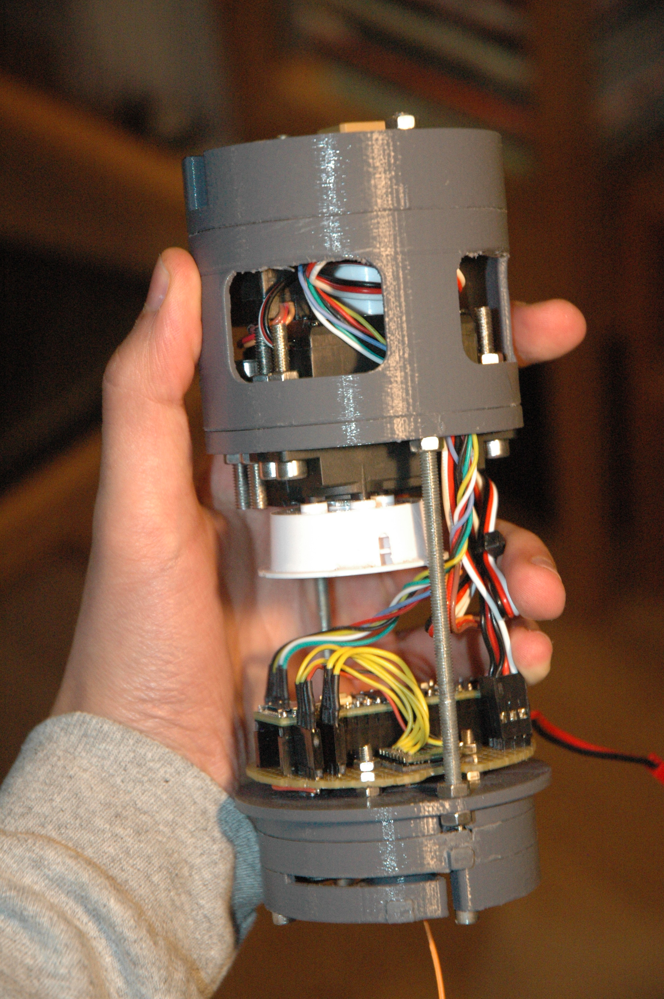
Image/Prototype_B.jpg
