YohanHadji/R2Home/Image/Prototype_C_1.jpg

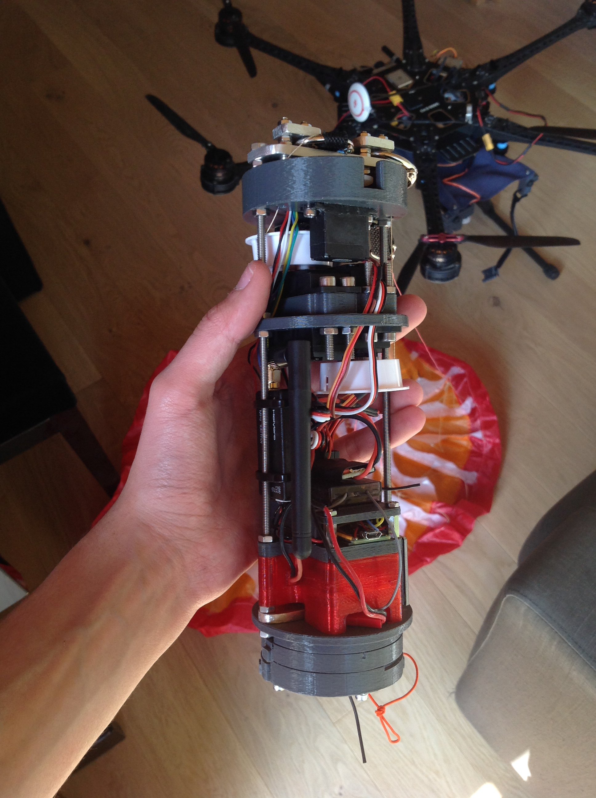
Image/Prototype_C_1.jpg
