YohanHadji/R2Home/Image/Prototype_C_2.jpg

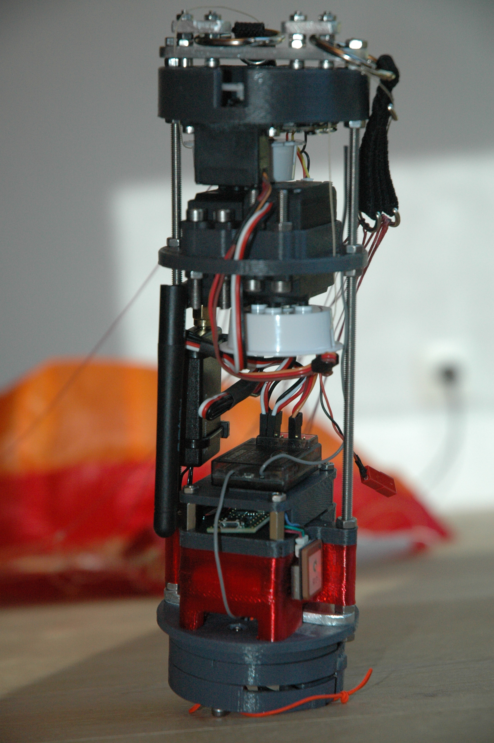
Image/Prototype_C_2.jpg
