YohanHadji/R2Home/Image/Prototype_D.png

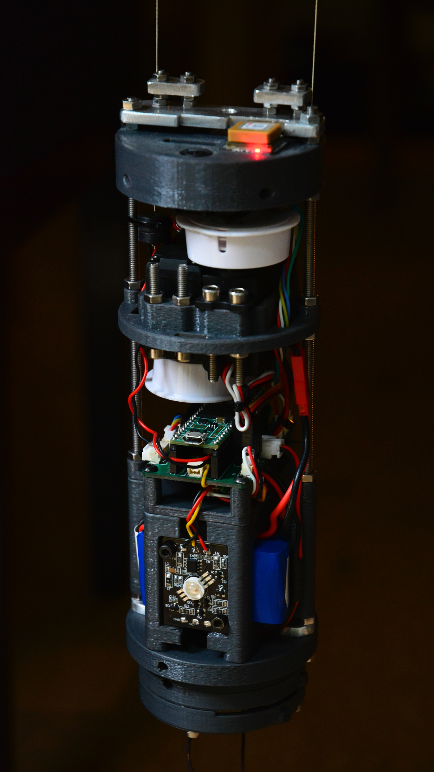
Image/Prototype_D.png
