YohanHadji/R2Home/Image/R2Home_Before_After.jpg

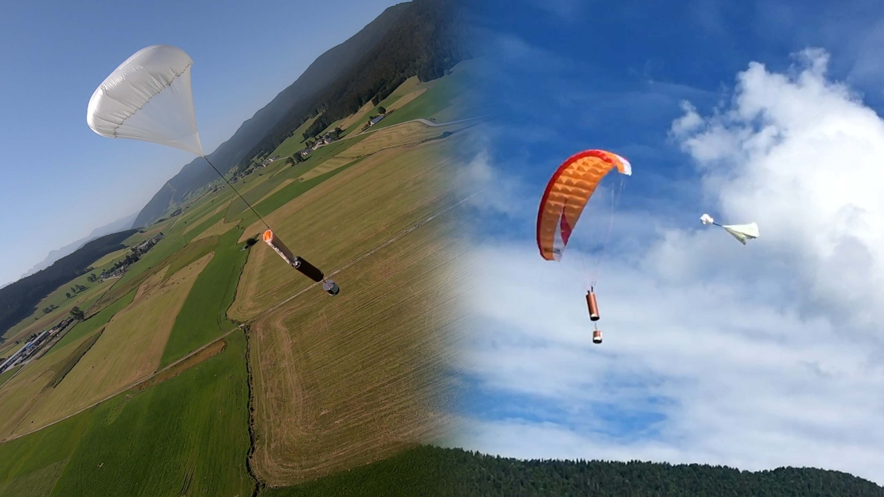
Image/R2Home_Before_After.jpg
