YohanHadji/R2Home/Image/R2Home_Before_Deployment.jpg

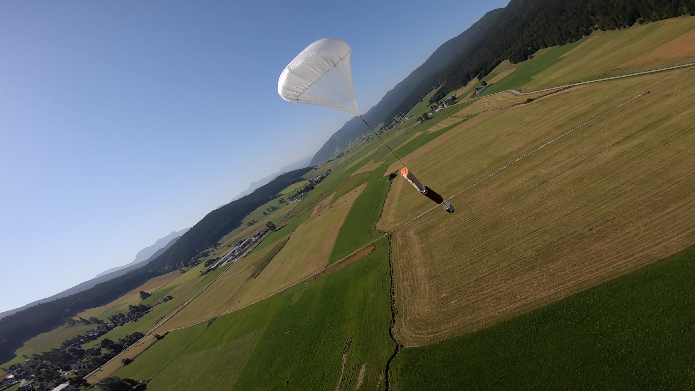
Image/R2Home_Before_Deployment.jpg
