YohanHadji/R2Home/Image/R2Home_Ram_Air.jpg

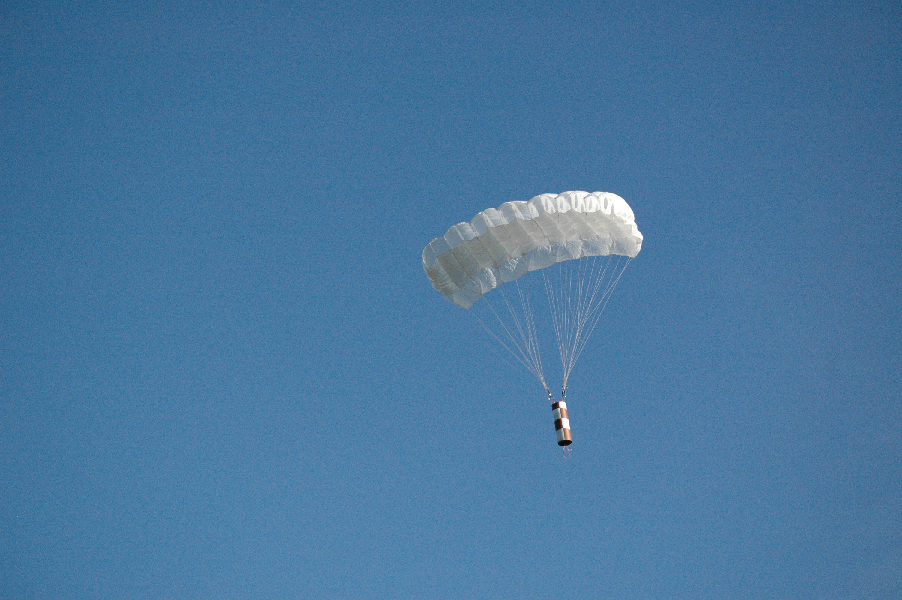
Image/R2Home_Ram_Air.jpg
