YohanHadji/R2Home/Image/R2Home_Single_Skin.jpg

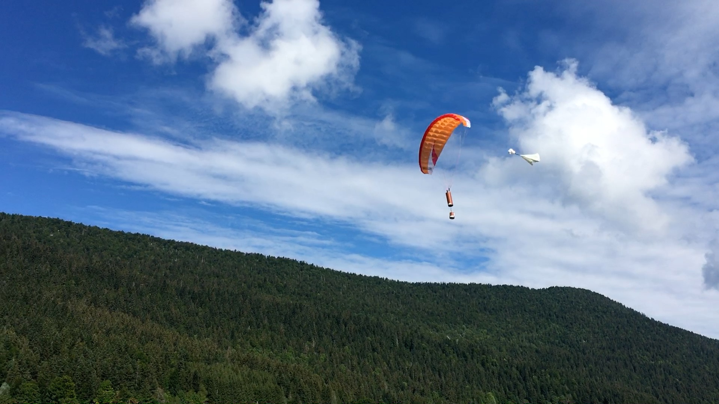
Image/R2Home_Single_Skin.jpg
