YohanHadji/R2Home/Image/R2Home_Single_Skin_B.jpg

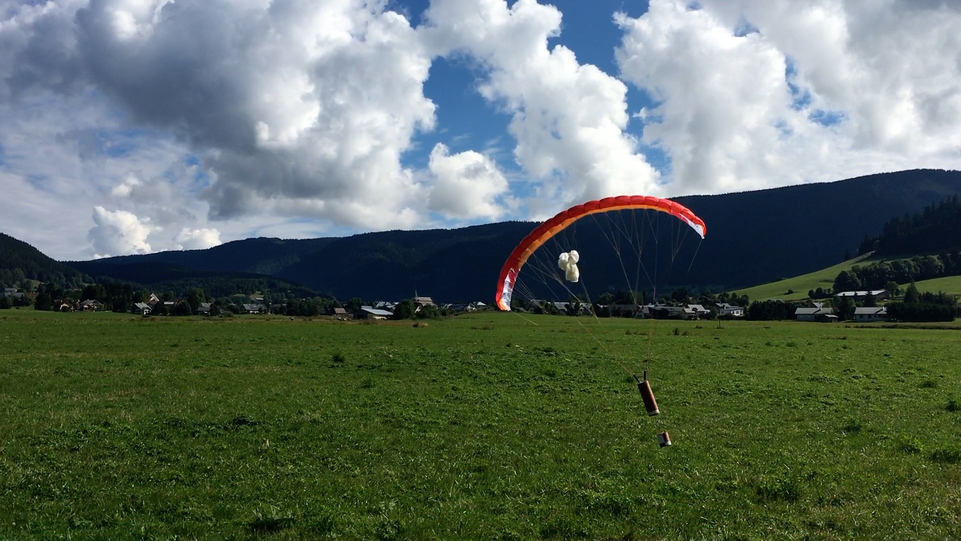
Image/R2Home_Single_Skin_B.jpg
