YohanHadji/R2Home/Image/R2Home_Single_Skin_C.jpg

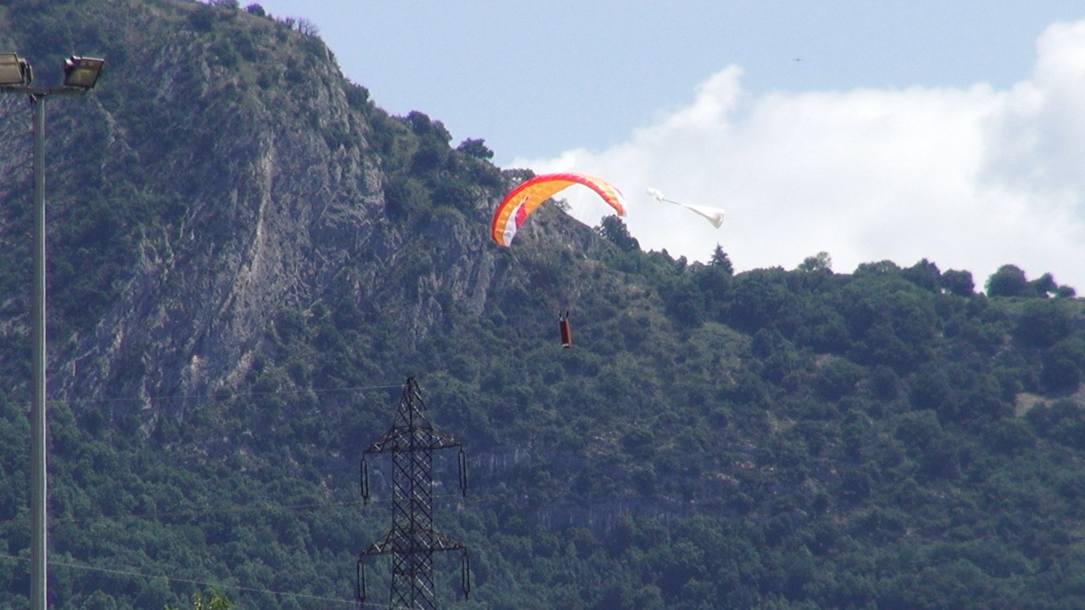
Image/R2Home_Single_Skin_C.jpg
