YohanHadji/R2Home/Image/servo_3.jpg

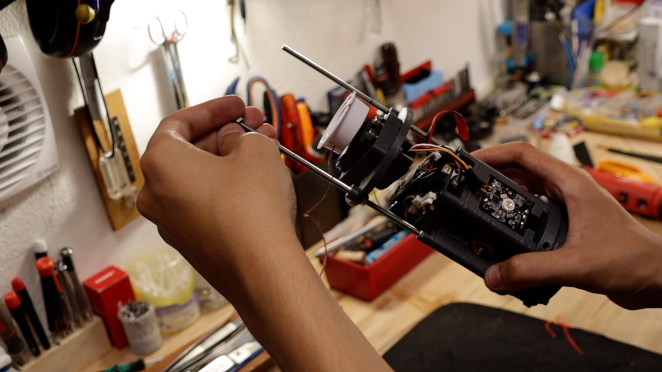
Image/servo_3.jpg
