YohanHadji/R2Home/Image/the_concept.png

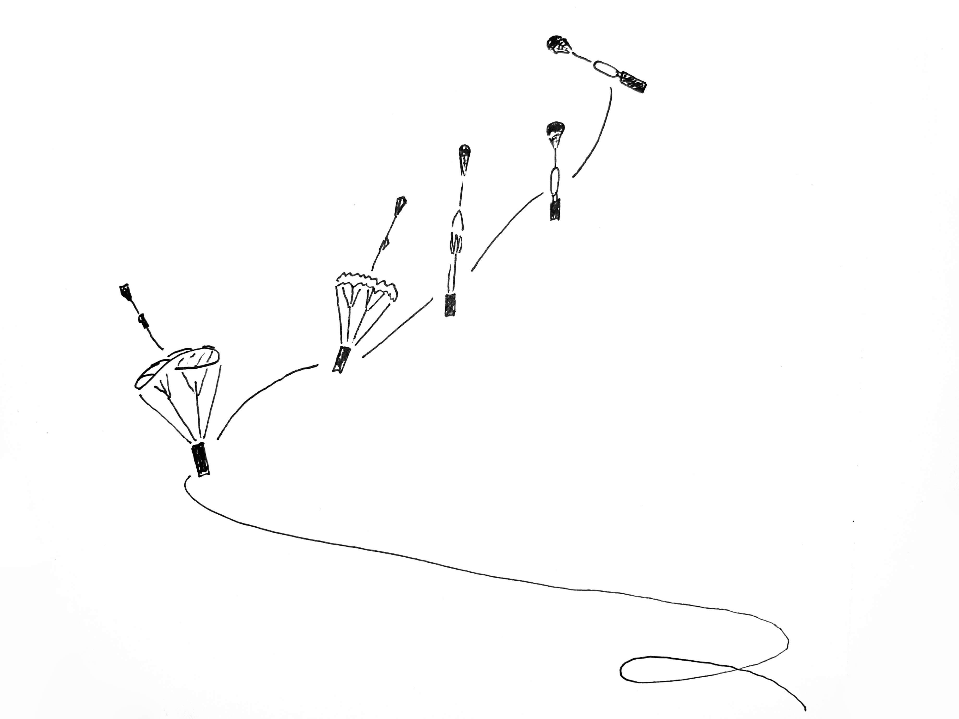
Image/the_concept.png
