YohanHadji/R2Home/Parachute Design Ressources/Inspiration pictures/13119071_870307399747601_7484525148636431048_n.jpg

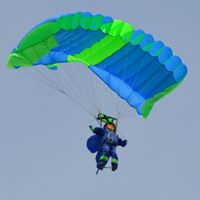
Parachute Design Ressources/Inspiration pictures/13119071_870307399747601_7484525148636431048_n.jpg
