YohanHadji/R2Home/Parachute Design Ressources/Inspiration pictures/17630055_1150035491774789_3575807203501655928_n.jpg

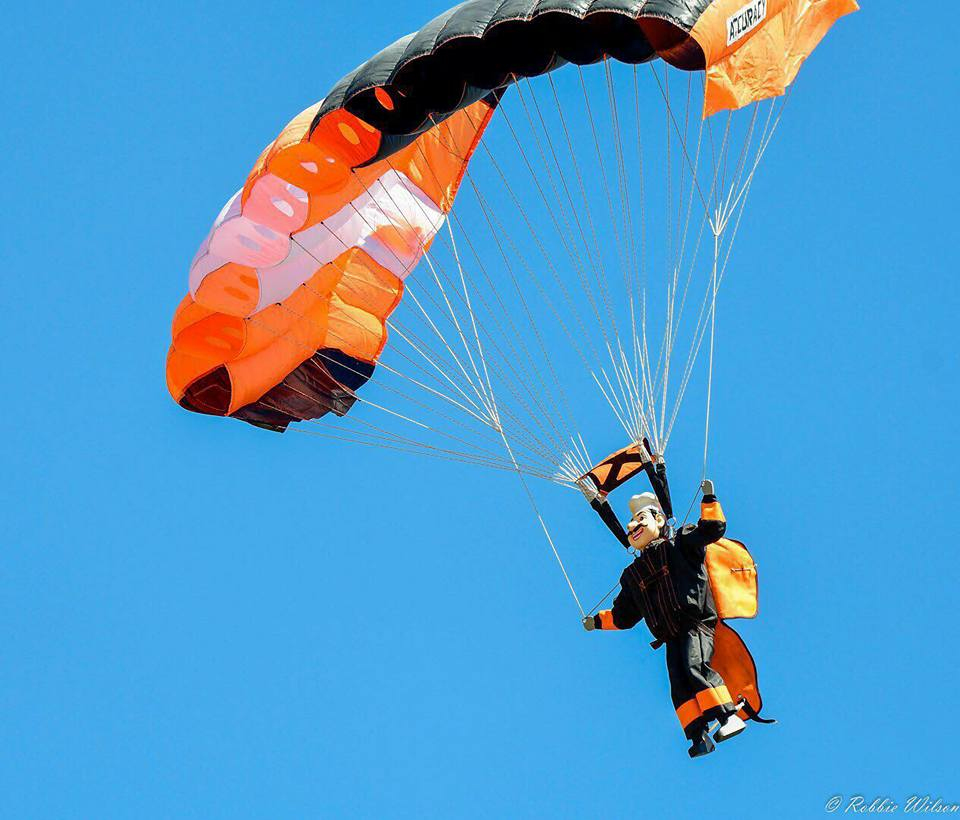
Parachute Design Ressources/Inspiration pictures/17630055_1150035491774789_3575807203501655928_n.jpg
