YohanHadji/R2Home/Parachute Design Ressources/Inspiration pictures/Capture d’écran 2020-04-19 à 17.44.50.png

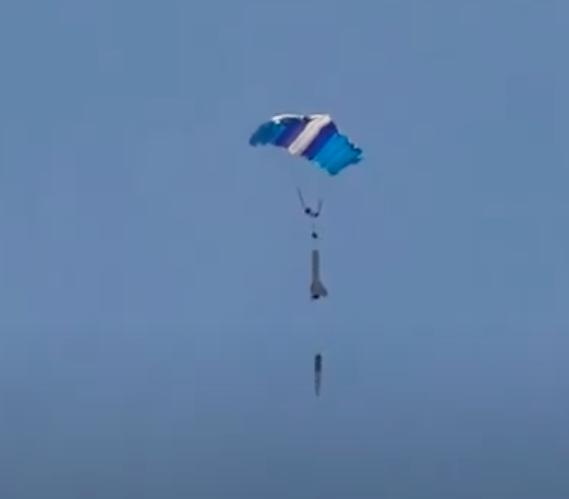
Parachute Design Ressources/Inspiration pictures/Capture d’écran 2020-04-19 à 17.44.50.png
