YohanHadji/R2Home/Parachute Design Ressources/Inspiration pictures/Capture d’écran 2020-04-22 à 10.36.27.png

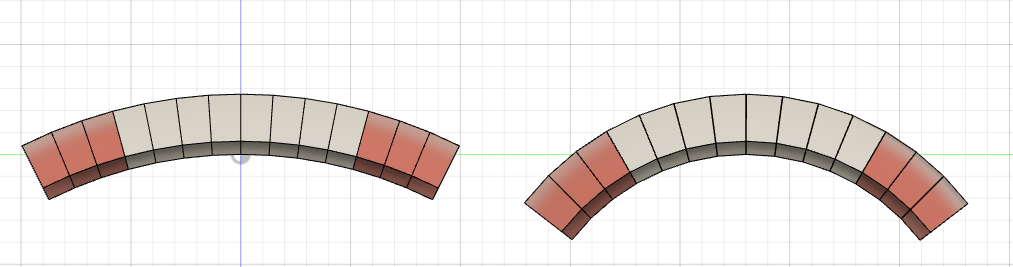
Parachute Design Ressources/Inspiration pictures/Capture d’écran 2020-04-22 à 10.36.27.png
