YohanHadji/R2Home/Parachute Design Ressources/Inspiration pictures/Capture d’écran 2020-04-22 à 14.06.21.png

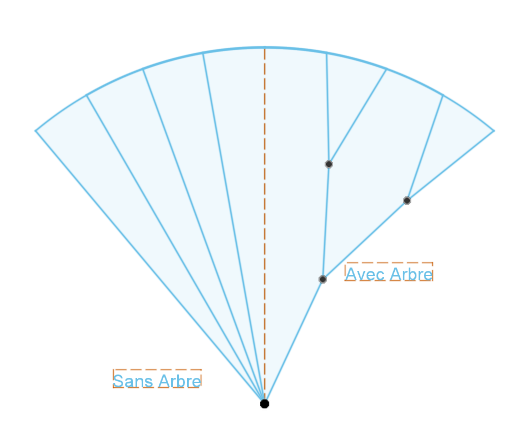
Parachute Design Ressources/Inspiration pictures/Capture d’écran 2020-04-22 à 14.06.21.png
