YohanHadji/R2Home/Parachute Design Ressources/Inspiration pictures/DM_v01iWAAUJClk.jpg-large.jpeg

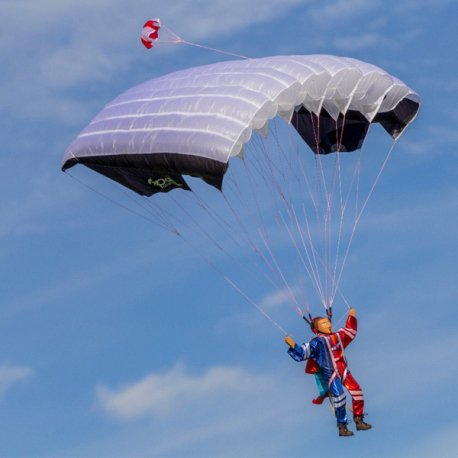
Parachute Design Ressources/Inspiration pictures/DM_v01iWAAUJClk.jpg-large.jpeg
