YohanHadji/R2Home/Parachute Design Ressources/Inspiration pictures/maxresdefault-2.jpg

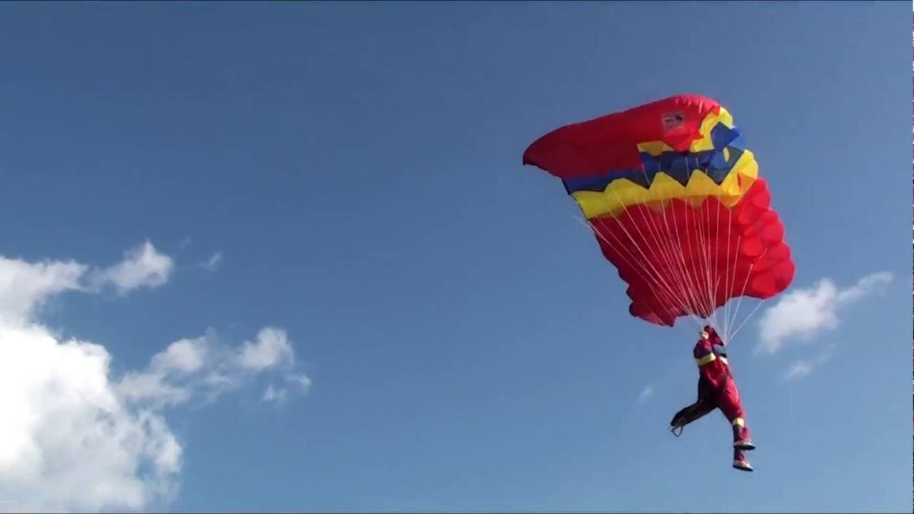
Parachute Design Ressources/Inspiration pictures/maxresdefault-2.jpg
