YohanHadji/R2Home/Parachute Design Ressources/Inspiration pictures/rc-skydiver-kit-artf-steven-orange-2.jpg

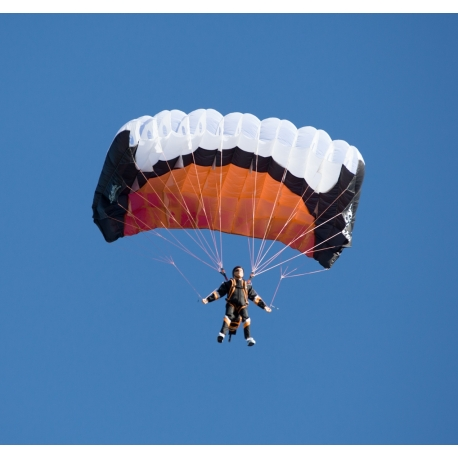
Parachute Design Ressources/Inspiration pictures/rc-skydiver-kit-artf-steven-orange-2.jpg
