YohanHadji/R2Home/Parachute Design Ressources/Inspiration pictures/unnamed-7.jpg

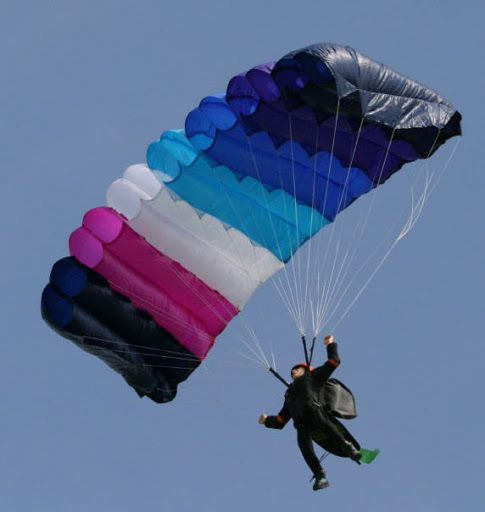
Parachute Design Ressources/Inspiration pictures/unnamed-7.jpg
