YohanHadji/R2Home/Parachute Design Ressources/Plans/Hugo/6629893367_eafc418189_o.jpg

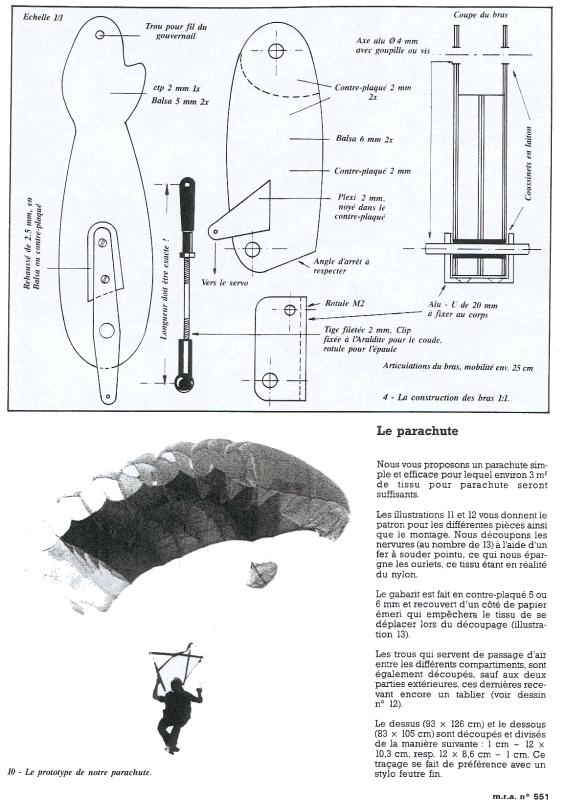
Parachute Design Ressources/Plans/Hugo/6629893367_eafc418189_o.jpg
