YohanHadji/R2Home/Parachute Design Ressources/Plans/Hugo/6629894277_428893cf94_o.jpg

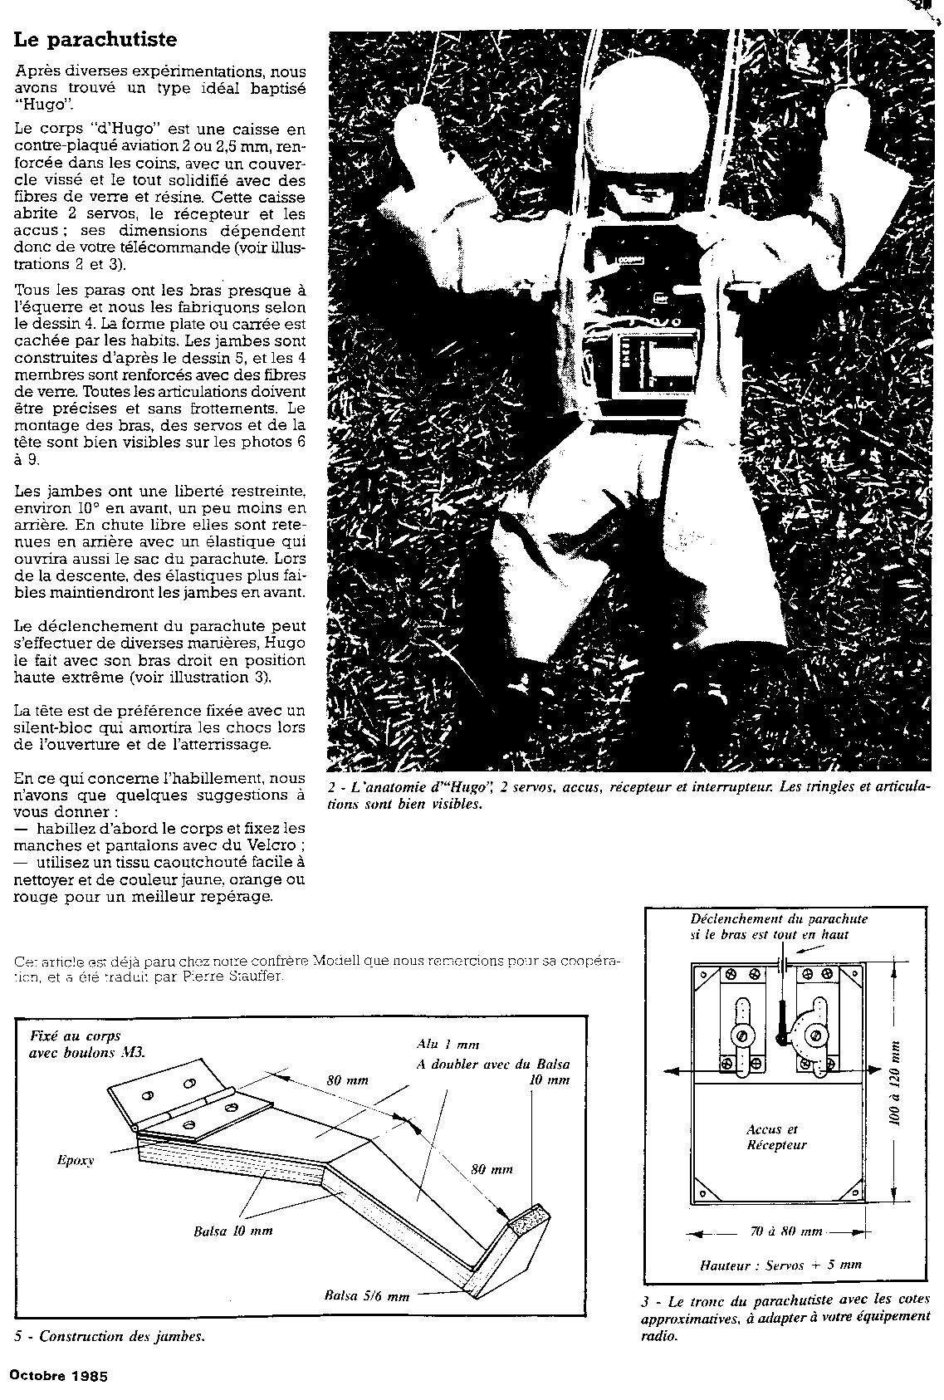
Parachute Design Ressources/Plans/Hugo/6629894277_428893cf94_o.jpg
