YohanHadji/R2Home/Parachute Design Ressources/Plans/Hugo/6629894885_9cc9aa43e9_o.jpg

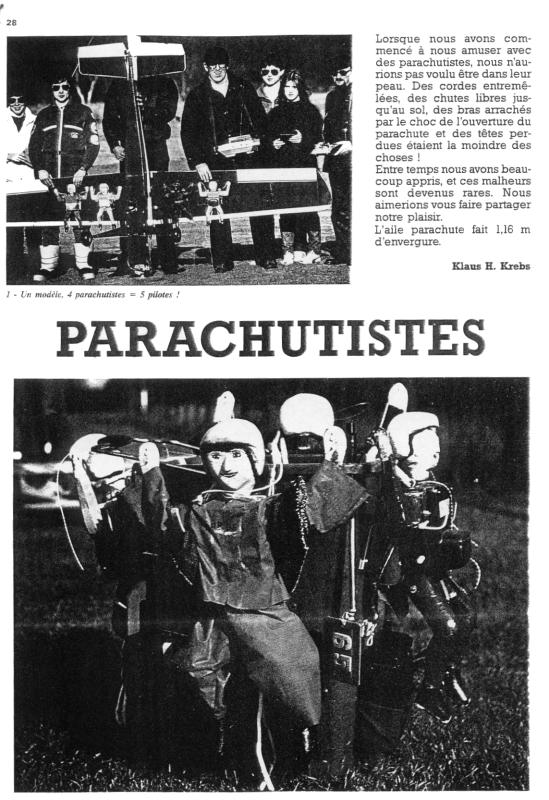
Parachute Design Ressources/Plans/Hugo/6629894885_9cc9aa43e9_o.jpg
