YohanHadji/R2Home/Parachute Design Ressources/Plans/Hugo/6629895053_39d0478401_o.jpg

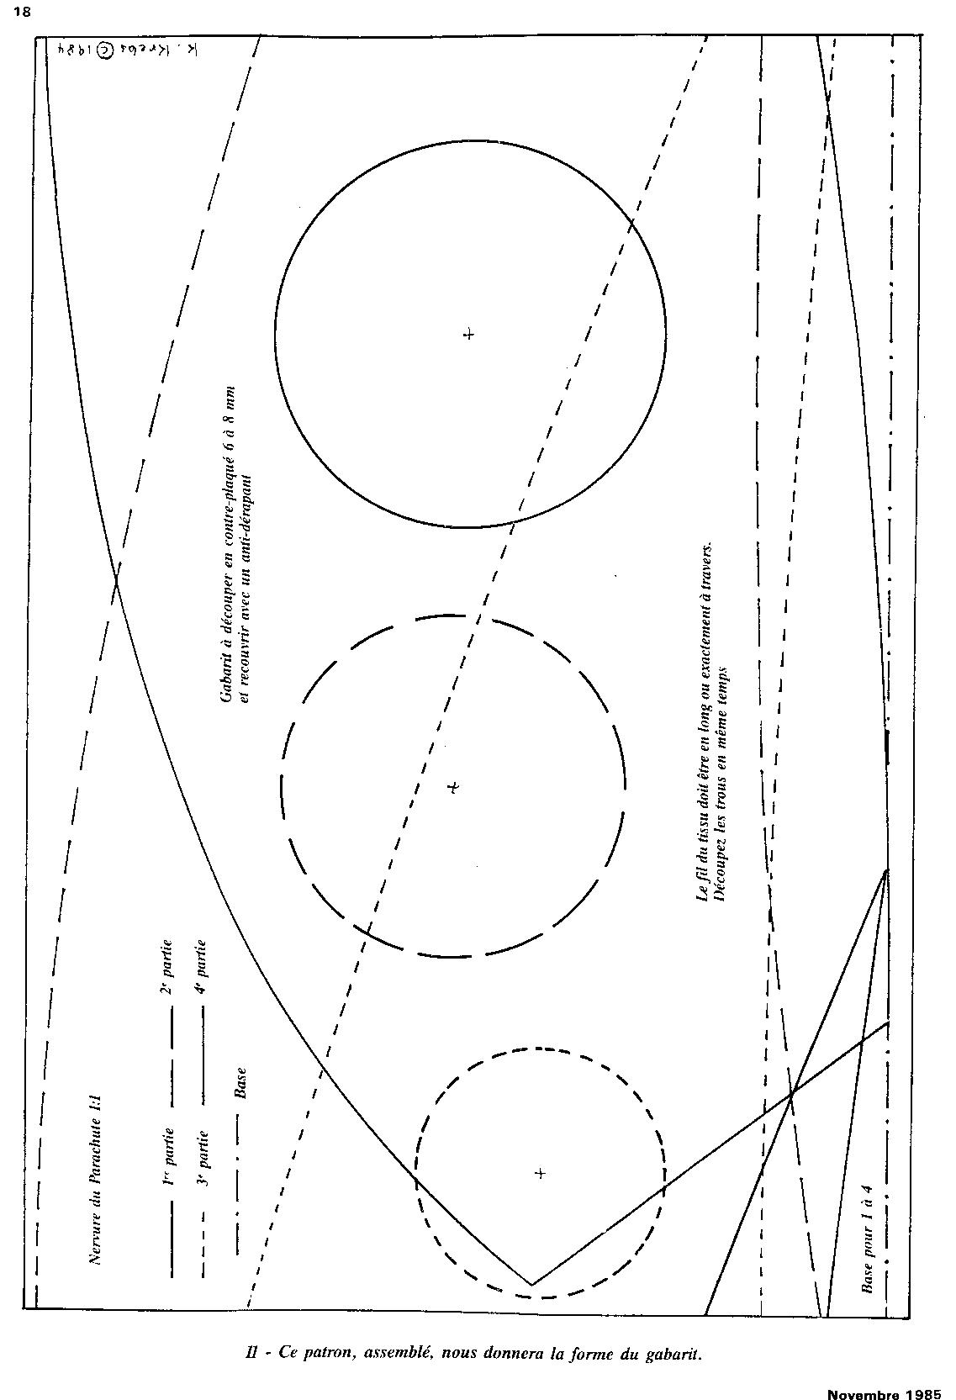
Parachute Design Ressources/Plans/Hugo/6629895053_39d0478401_o.jpg
