YohanHadji/R2Home/Parachute Design Ressources/Plans/Hugo/6629895781_c1e1ed4008_o.jpg

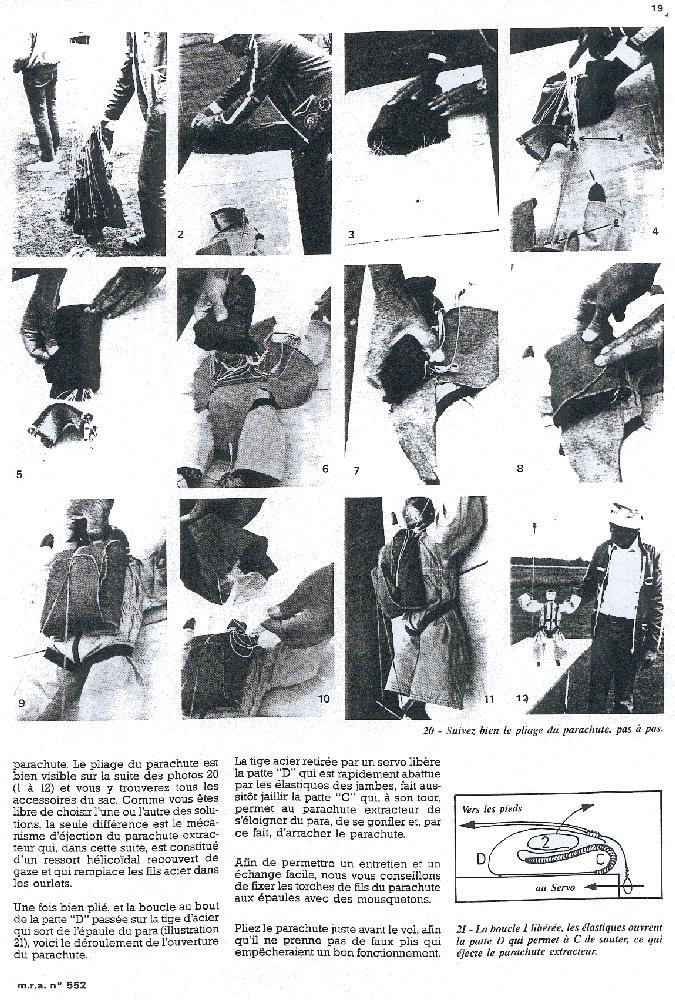
Parachute Design Ressources/Plans/Hugo/6629895781_c1e1ed4008_o.jpg
