YohanHadji/R2Home/Parachute Design Ressources/Plans/Hugo/6629896419_5b7948d273_o.jpg

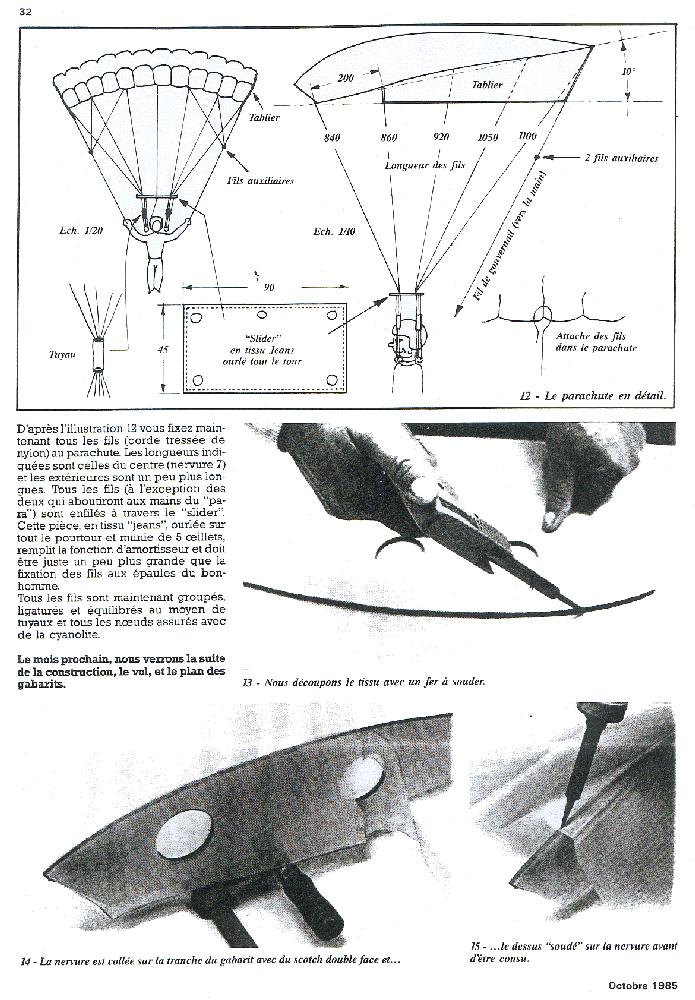
Parachute Design Ressources/Plans/Hugo/6629896419_5b7948d273_o.jpg
