YohanHadji/R2Home/Parachute Design Ressources/Plans/Hugo/6629897105_c1eef08e7c_o.jpg

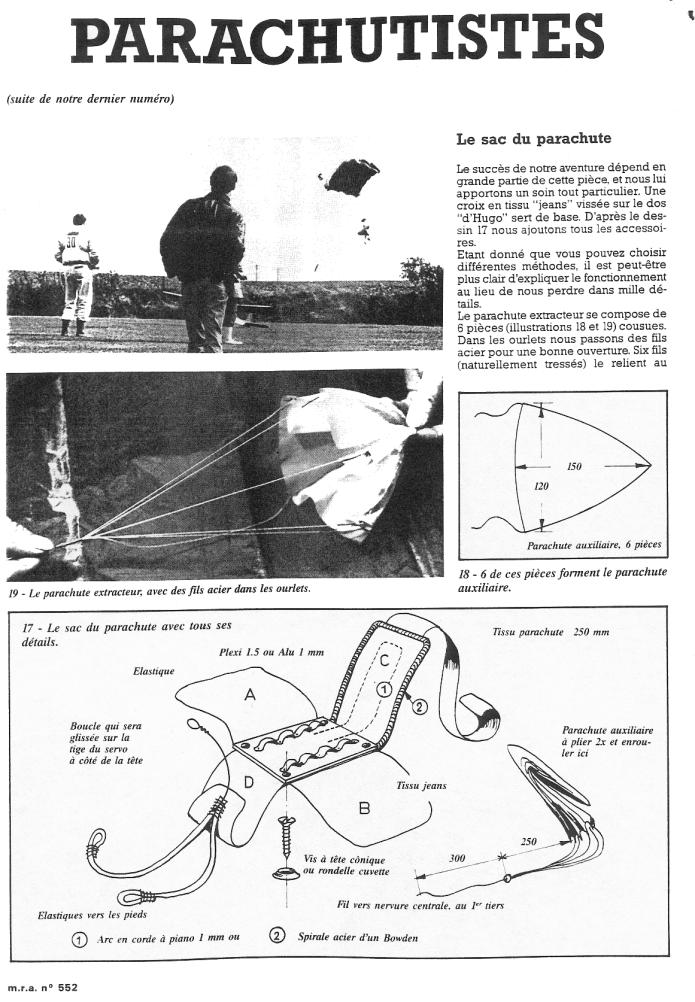
Parachute Design Ressources/Plans/Hugo/6629897105_c1eef08e7c_o.jpg
