YohanHadji/R2Home/Parachute Design Ressources/Plans/Hugo/6629898395_29bd73ea46_o.jpg

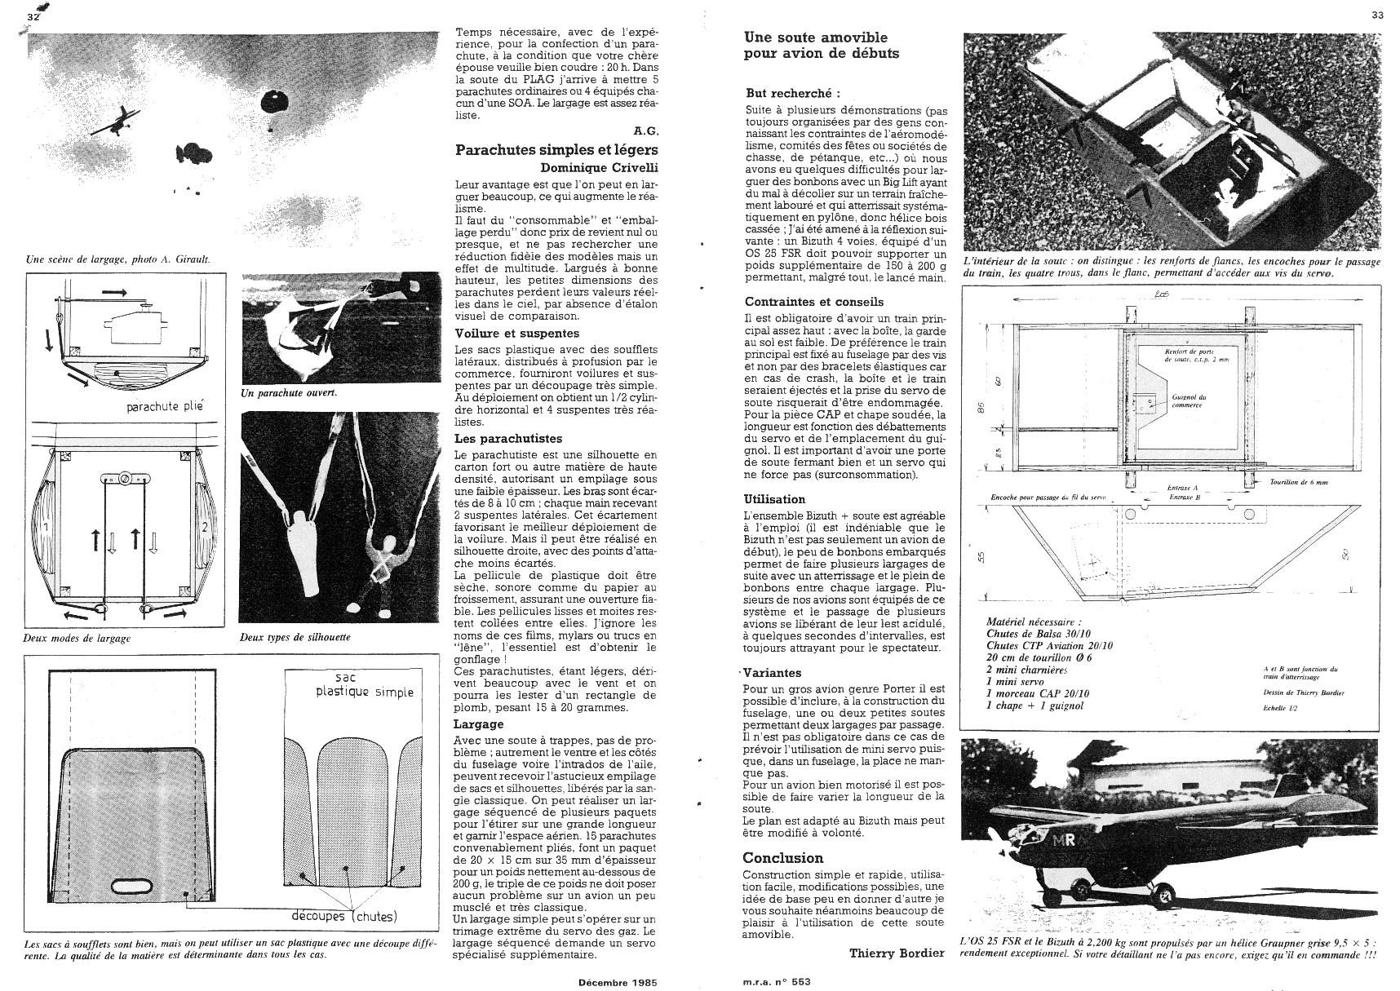
Parachute Design Ressources/Plans/Hugo/6629898395_29bd73ea46_o.jpg
