YohanHadji/R2Home/Parachute Design Ressources/Plans/Hugo/6629898855_13b9979abc_o.jpg

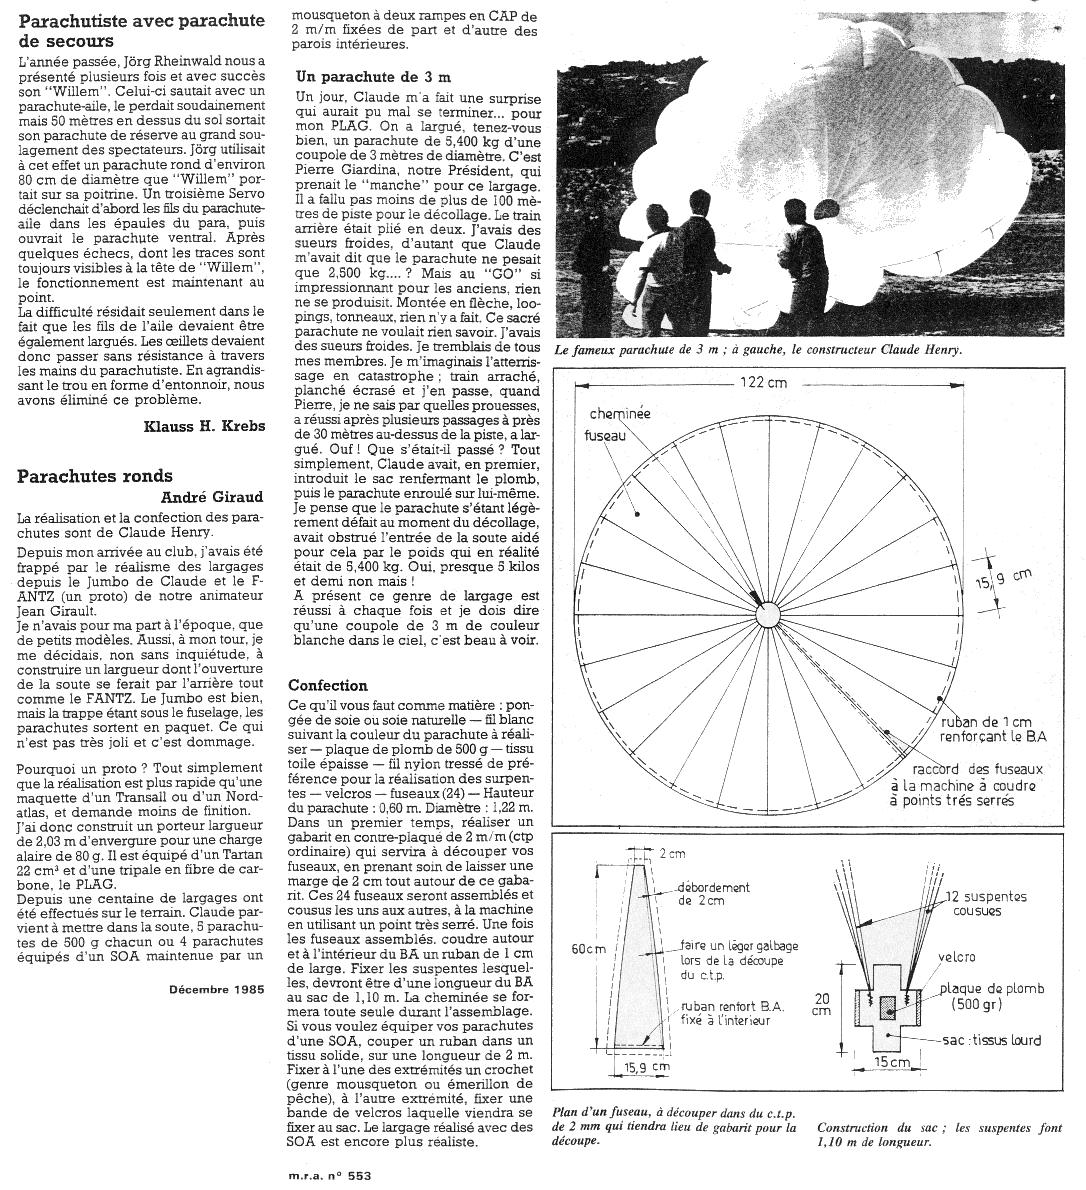
Parachute Design Ressources/Plans/Hugo/6629898855_13b9979abc_o.jpg
