YohanHadji/R2Home/Parachute Design Ressources/Plans/Huguette/Huguette Boris/img001.jpeg

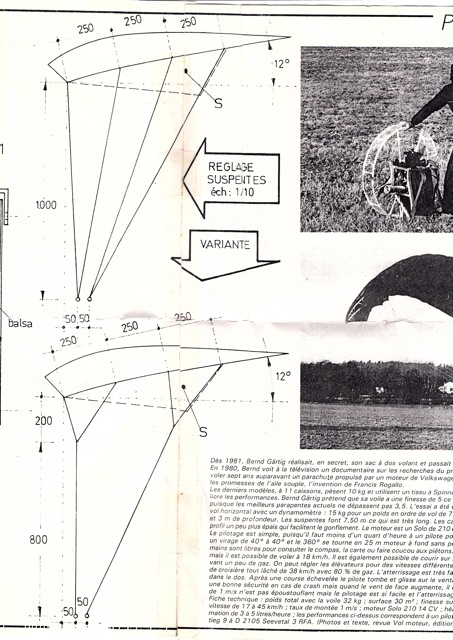
Parachute Design Ressources/Plans/Huguette/Huguette Boris/img001.jpeg
