YohanHadji/R2Home/Parachute Design Ressources/Plans/Huguette/Huguette Boris/img002.jpeg

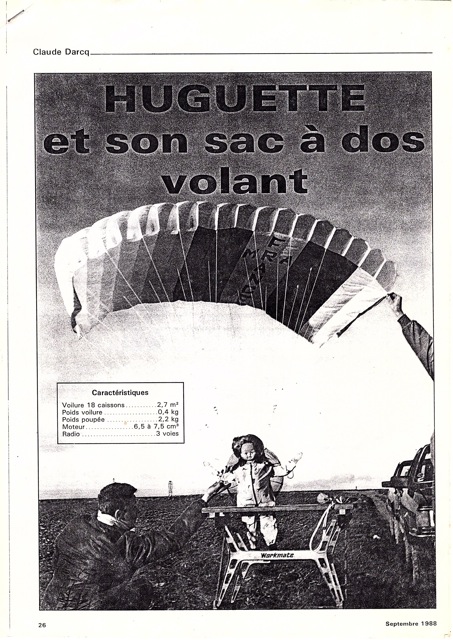
Parachute Design Ressources/Plans/Huguette/Huguette Boris/img002.jpeg
