YohanHadji/R2Home/Parachute Design Ressources/Plans/Huguette/Huguette Boris/img004.jpeg

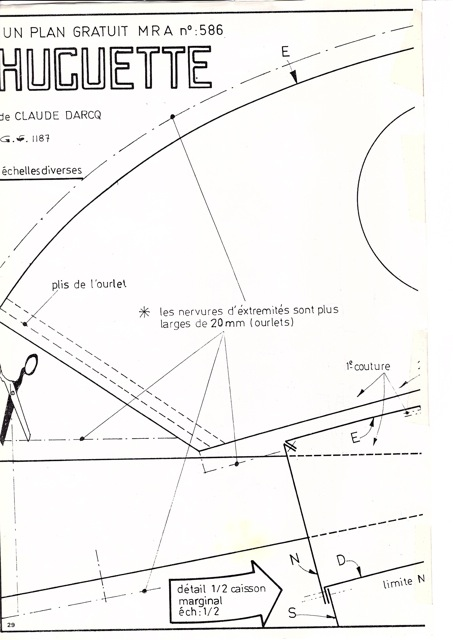
Parachute Design Ressources/Plans/Huguette/Huguette Boris/img004.jpeg
