YohanHadji/R2Home/Parachute Design Ressources/Plans/Huguette/Huguette Boris/img005.jpeg

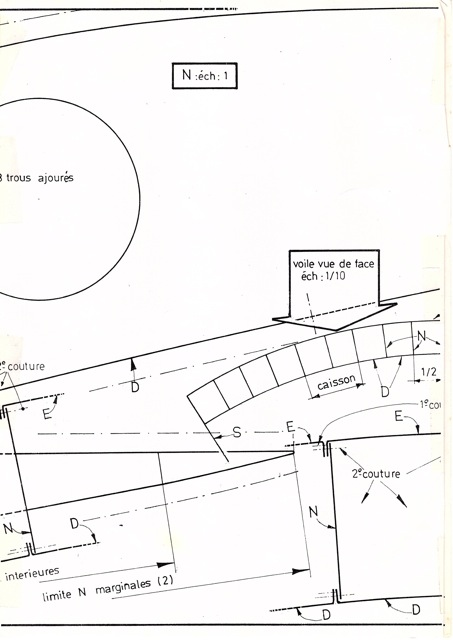
Parachute Design Ressources/Plans/Huguette/Huguette Boris/img005.jpeg
