YohanHadji/R2Home/Parachute Design Ressources/Plans/Huguette/Huguette Boris/img006.jpeg

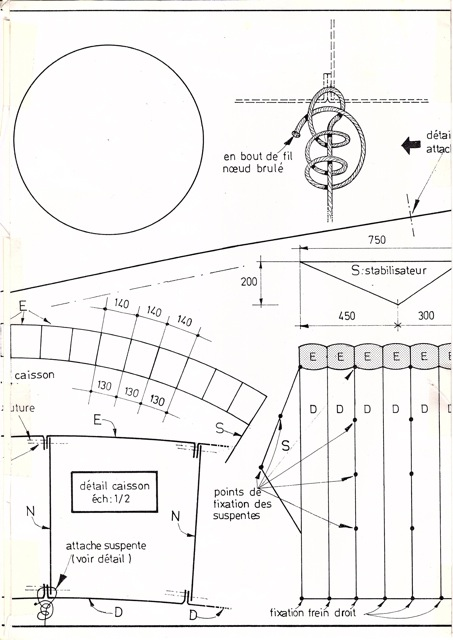
Parachute Design Ressources/Plans/Huguette/Huguette Boris/img006.jpeg
