YohanHadji/R2Home/Parachute Design Ressources/Plans/Huguette/Huguette Boris/img007.jpeg

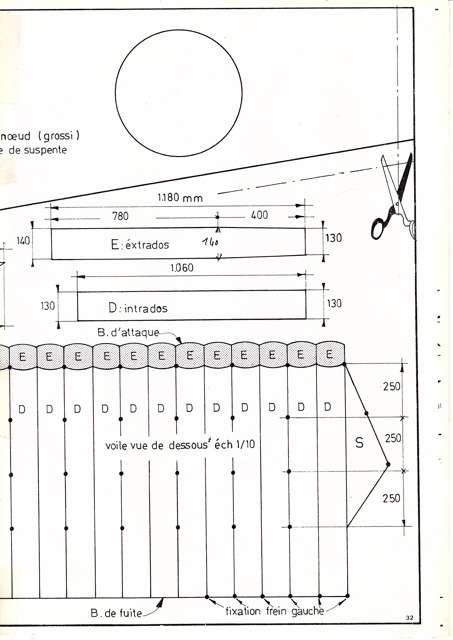
Parachute Design Ressources/Plans/Huguette/Huguette Boris/img007.jpeg
