YohanHadji/R2Home/Parachute Design Ressources/Plans/Huguette/Huguette HD/6629602463_01d02e469f_o.jpg

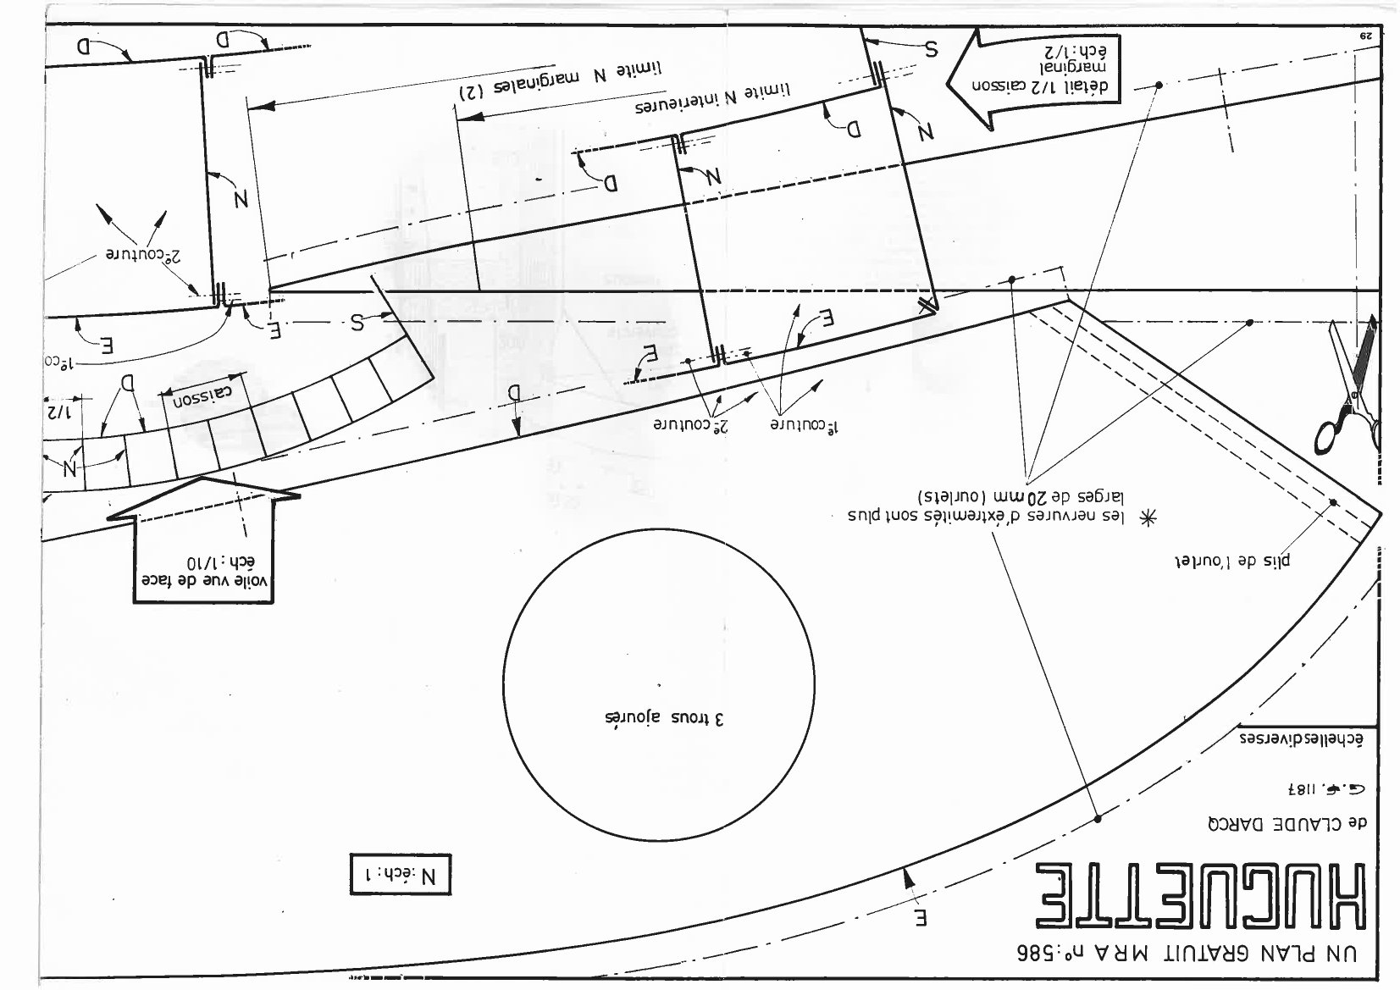
Parachute Design Ressources/Plans/Huguette/Huguette HD/6629602463_01d02e469f_o.jpg
