YohanHadji/R2Home/Parachute Design Ressources/Plans/Huguette/Huguette HD/6629603105_362d85be44_o.jpg

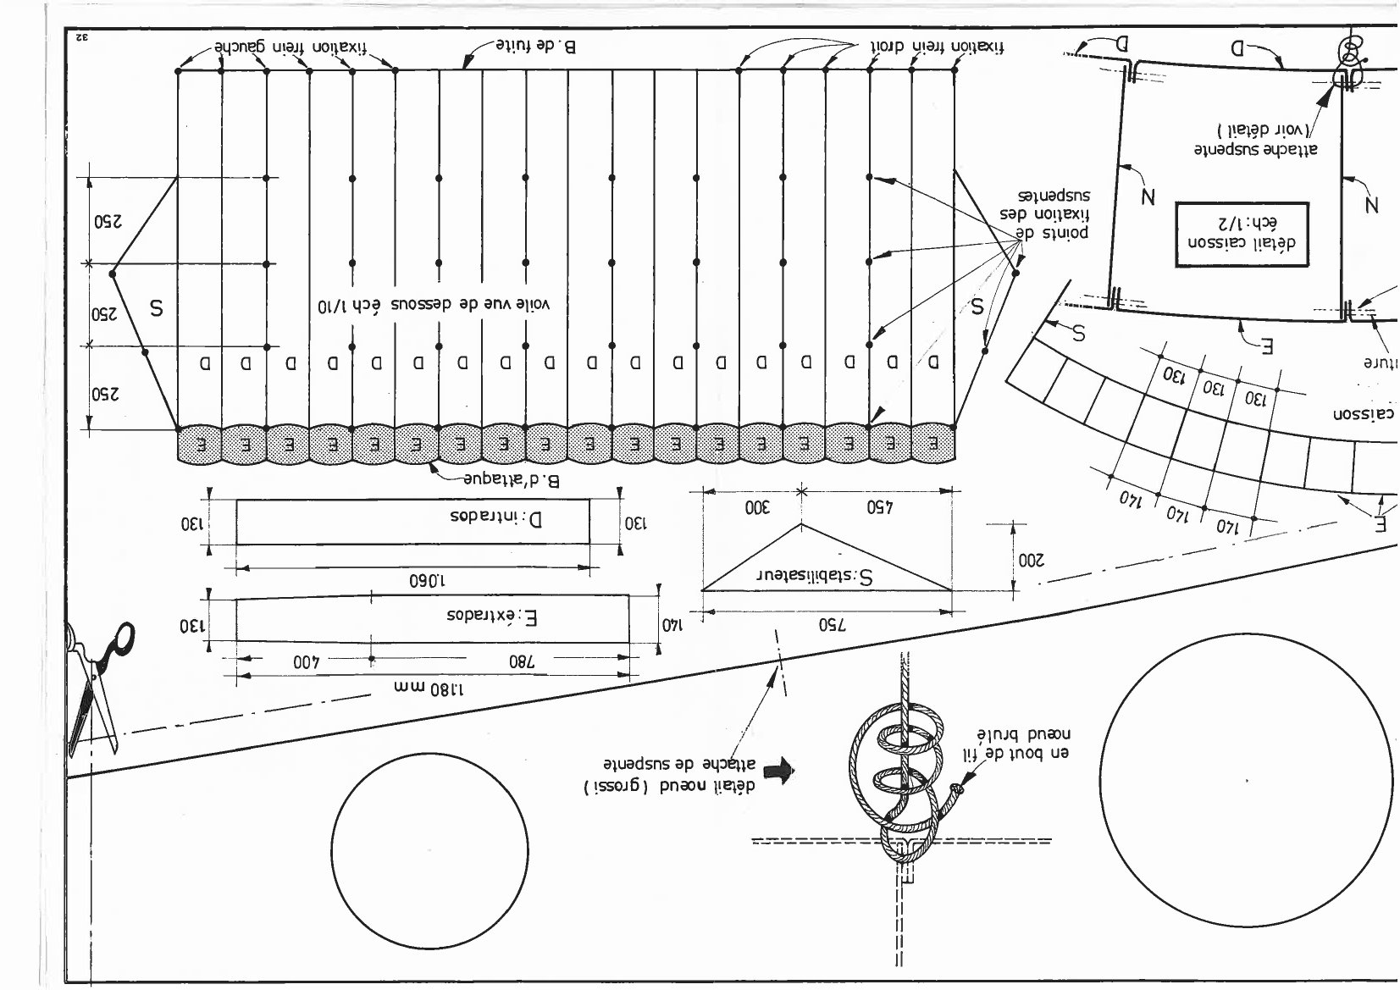
Parachute Design Ressources/Plans/Huguette/Huguette HD/6629603105_362d85be44_o.jpg
