YohanHadji/R2Home/Parachute Design Ressources/Plans/Huguette/Huguette HD/6629604171_aaa797bbed_o.jpg

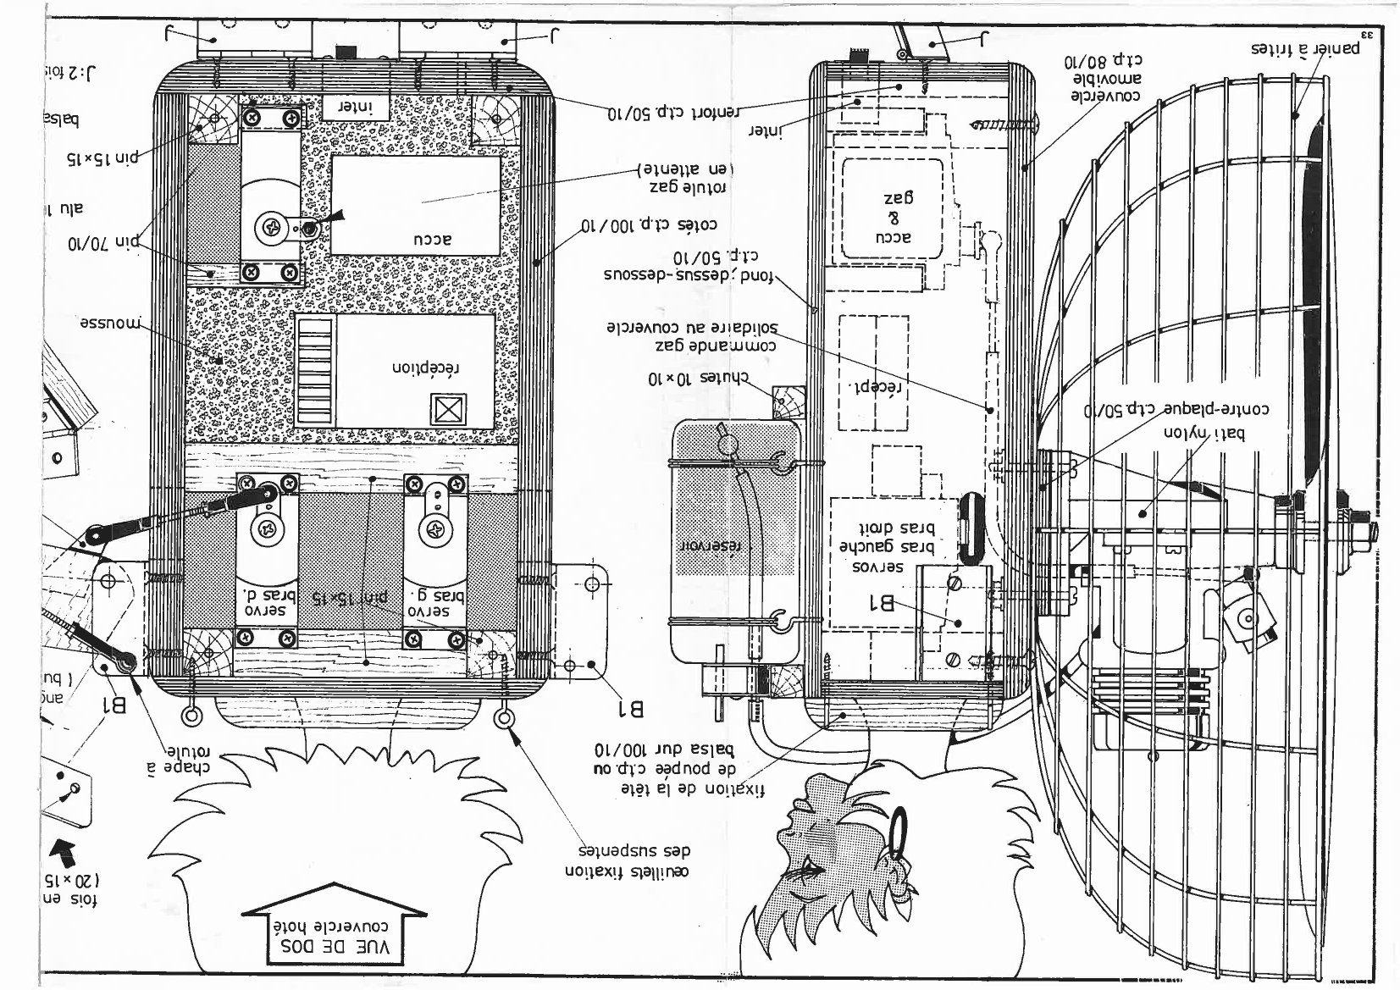
Parachute Design Ressources/Plans/Huguette/Huguette HD/6629604171_aaa797bbed_o.jpg
