YohanHadji/R2Home/Parachute Design Ressources/Plans/Huguette/Huguette HD/6629605059_5c2b4afe82_o.jpg

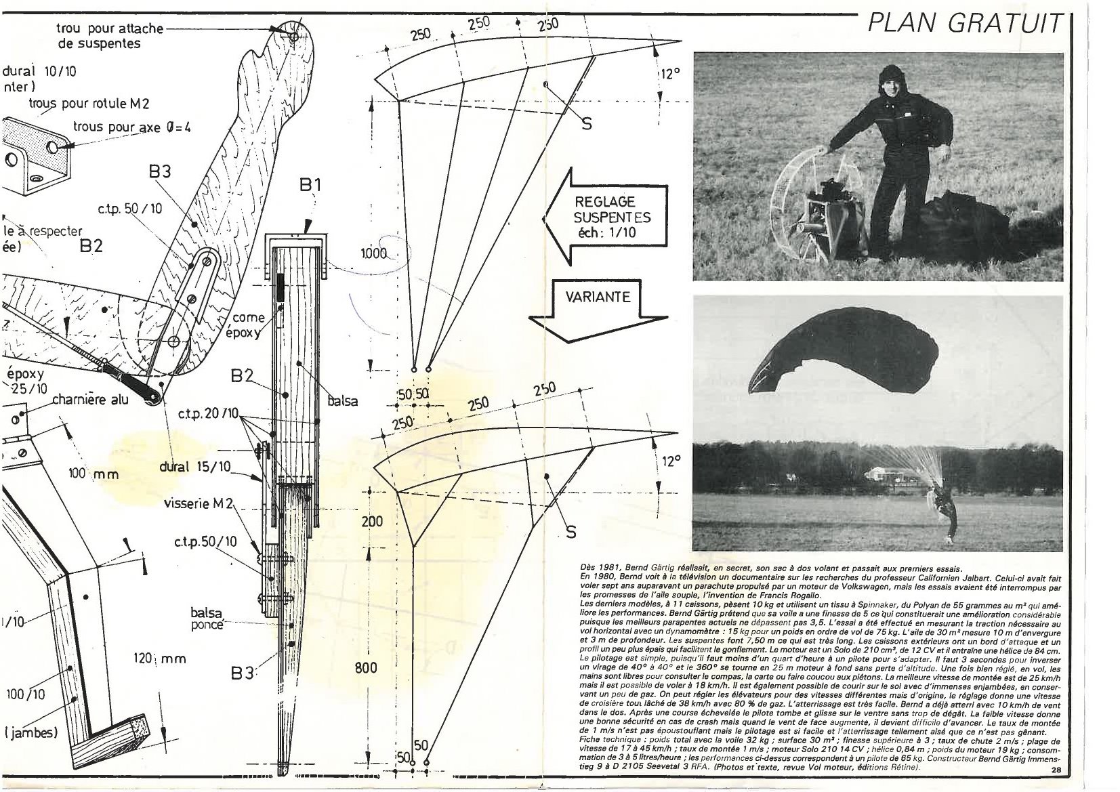
Parachute Design Ressources/Plans/Huguette/Huguette HD/6629605059_5c2b4afe82_o.jpg
