YohanHadji/R2Home/Image/all_parts_white.png

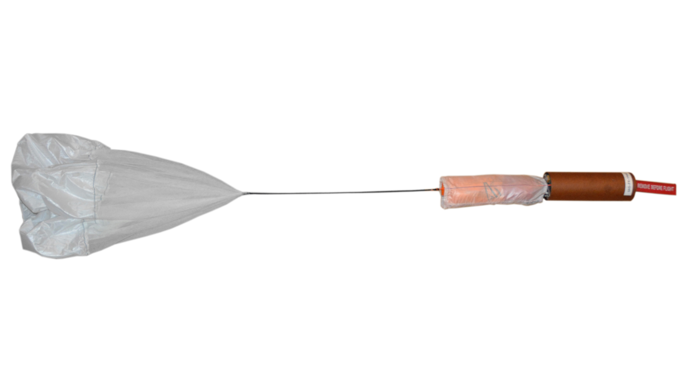
Image/all_parts_white.png
