YohanHadji/R2Home/RLS_V1.0/R2Home _3DPRINT_V1.0/Bottom_bulkhead.stl

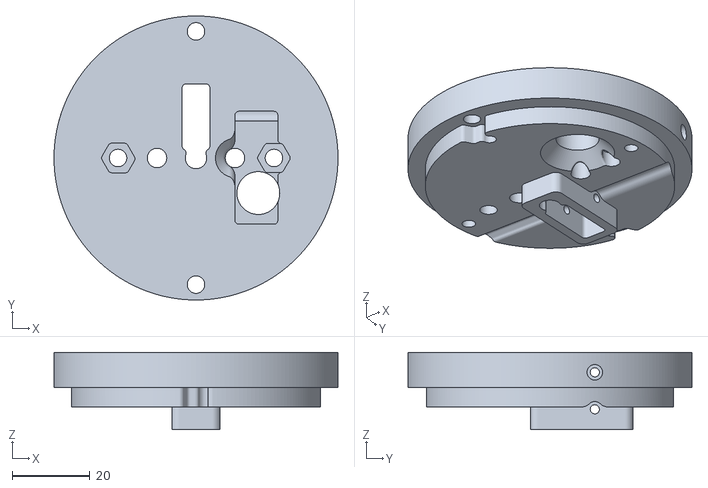
[picture p130: CAD file, 2022-02-09]
RLS_V1.0/R2Home _3DPRINT_V1.0/Bottom_bulkhead.stl
72.9 x 72.9 x 19.8
