YohanHadji/R2Home/RLS_V1.0/R2Home _3DPRINT_V1.0/Bottom_strong_attach.stl

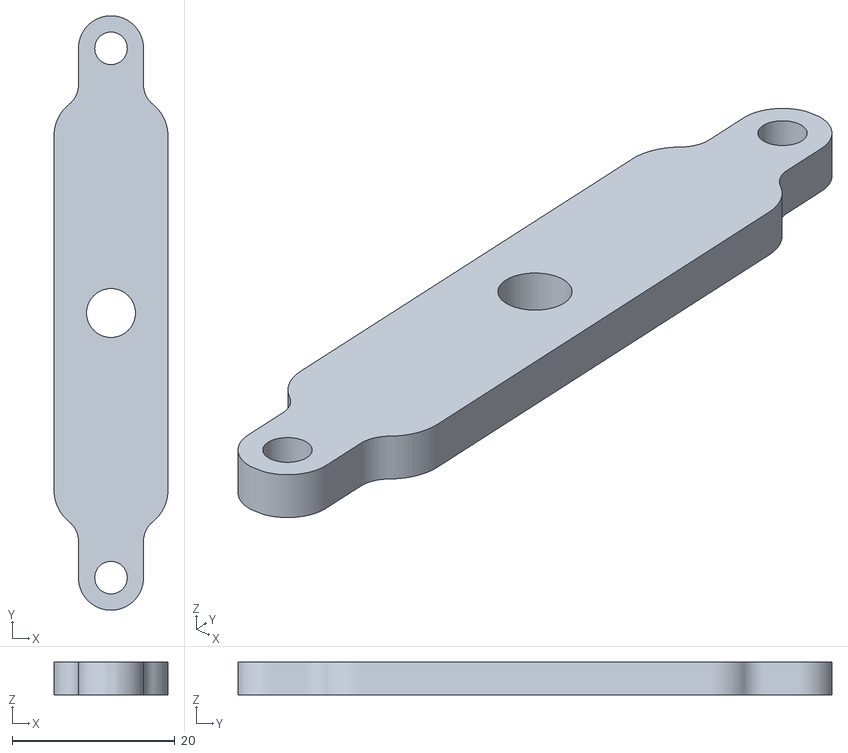
[picture p131: CAD file, 2022-02-09]
RLS_V1.0/R2Home _3DPRINT_V1.0/Bottom_strong_attach.stl
14.0 x 72.9 x 4.00
