YohanHadji/R2Home/RLS_V1.0/R2Home _3DPRINT_V1.0/Strongtop.stl

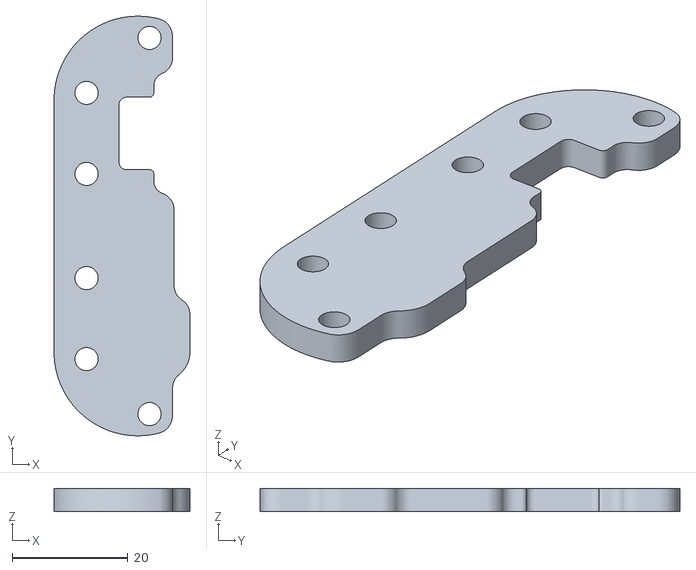
[picture p132: CAD file, 2022-02-09]
RLS_V1.0/R2Home _3DPRINT_V1.0/Strongtop.stl
23.5 x 72.5 x 4.00
