YohanHadji/R2Home/RLS_V1.0/R2Home _3DPRINT_V1.0/Battery_mount.stl

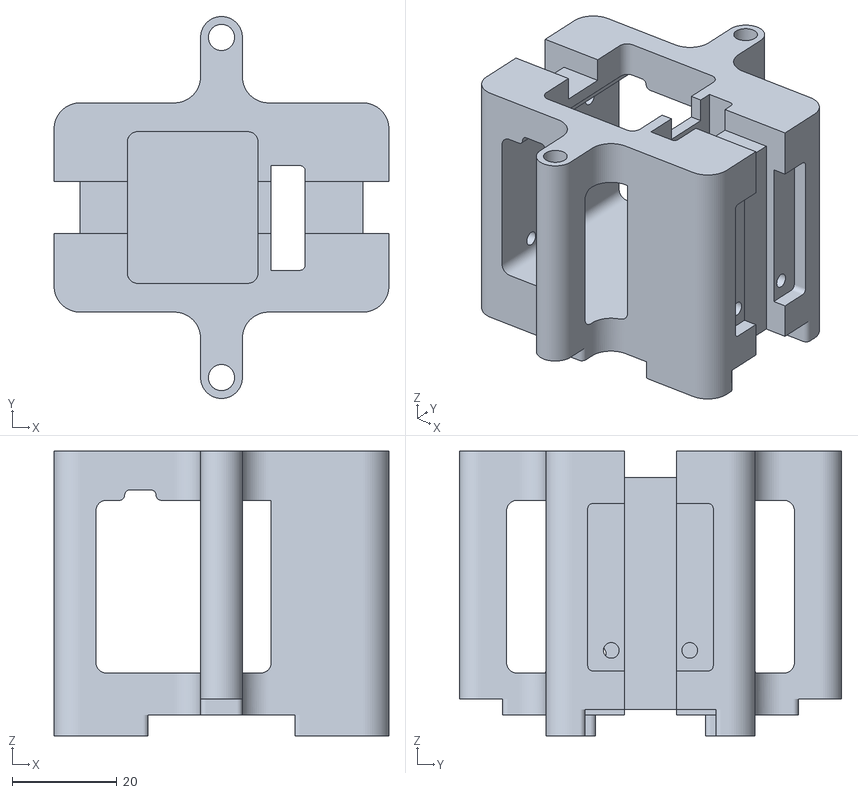
[picture p133: CAD file, 2021-12-27]
RLS_V1.0/R2Home _3DPRINT_V1.0/Battery_mount.stl
64.0 x 73.0 x 54.4
