YohanHadji/R2Home/RLS_V1.0/R2Home _3DPRINT_V1.0/Servo_drum.stl

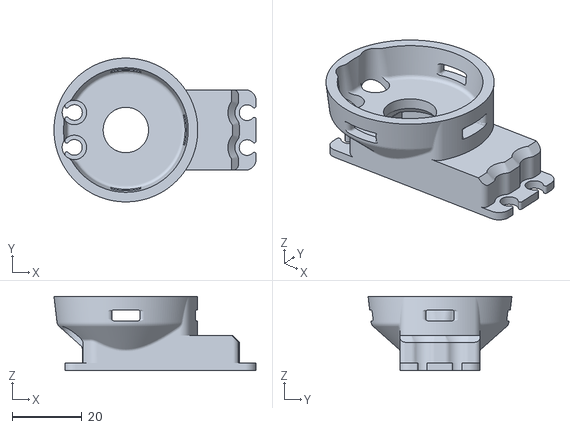
[picture p134: CAD file, 2021-11-23]
RLS_V1.0/R2Home _3DPRINT_V1.0/Servo_drum.stl
57.9 x 41.2 x 21.2
