YohanHadji/R2Home/RLS_V1.0/R2Home _3DPRINT_V1.0/Top_cap.stl

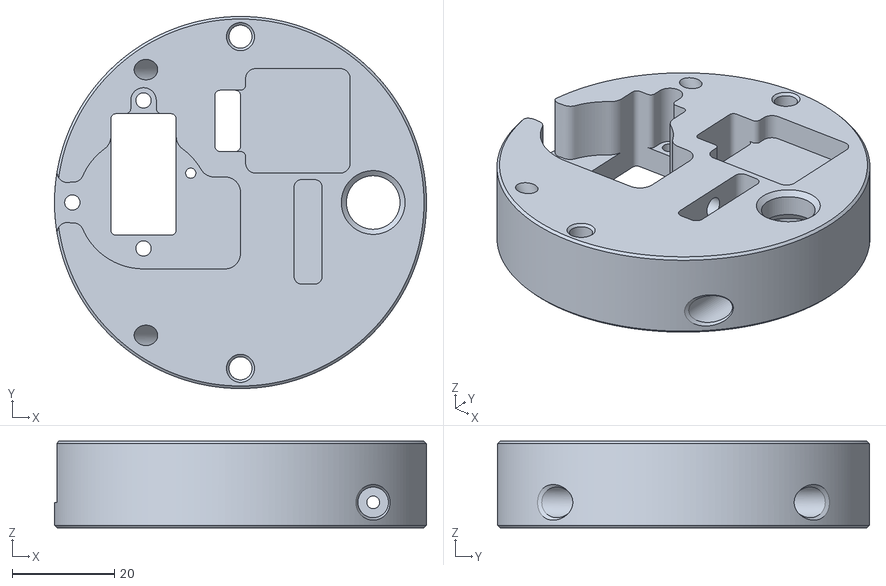
[picture p135: CAD file, 2021-11-23]
RLS_V1.0/R2Home _3DPRINT_V1.0/Top_cap.stl
72.9 x 72.9 x 17.0
