YohanHadji/R2Home/RLS_V1.0/R2Home _3DPRINT_V1.0/External.stl

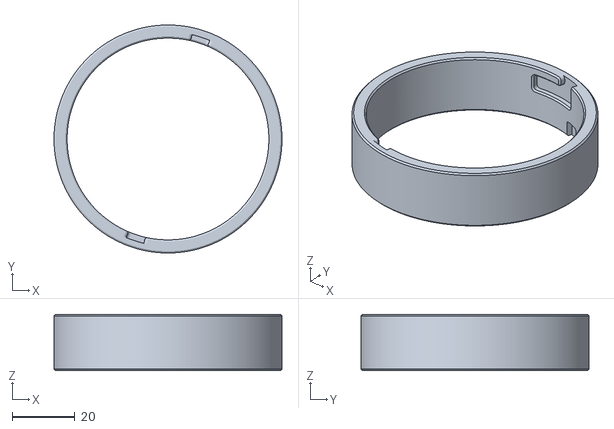
[picture p136: CAD file, 2021-11-23]
RLS_V1.0/R2Home _3DPRINT_V1.0/External.stl
72.9 x 72.9 x 18.0
