YohanHadji/R2Home/RLS_V1.0/R2Home _3DPRINT_V1.0/Pin1.stl

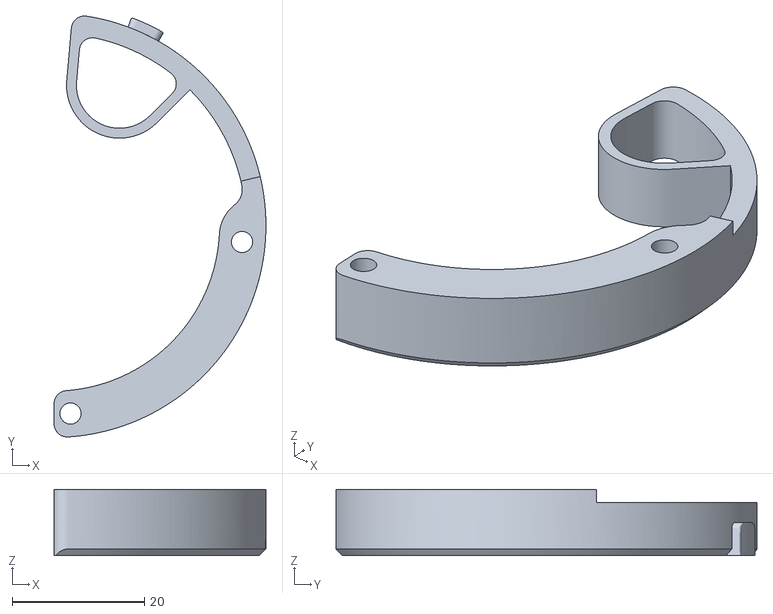
[picture p137: CAD file, 2021-11-23]
RLS_V1.0/R2Home _3DPRINT_V1.0/Pin1.stl
32.0 x 63.6 x 10.0
