YohanHadji/R2Home/RLS_V1.0/R2Home _3DPRINT_V1.0/Internal.stl

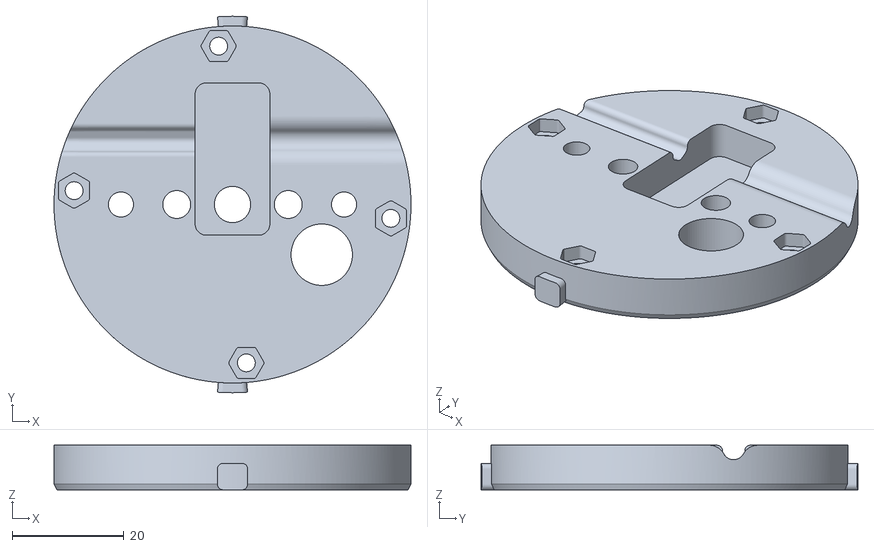
[picture p138: CAD file, 2021-11-23]
RLS_V1.0/R2Home _3DPRINT_V1.0/Internal.stl
64.0 x 67.5 x 8.00
