YohanHadji/R2Home/RLS_V1.0/R2Home _3DPRINT_V1.0/PCB_mount.stl

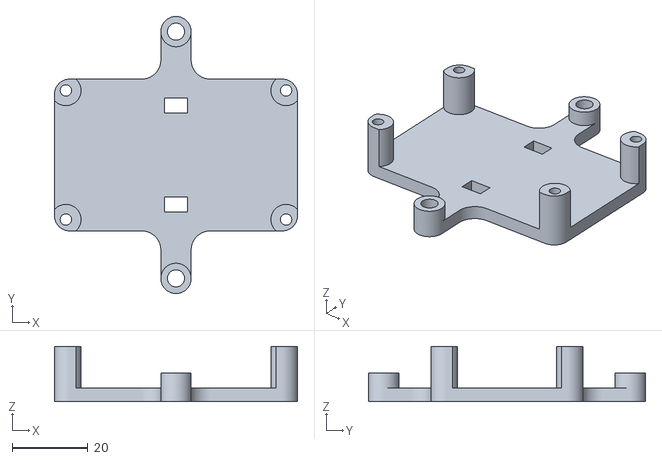
[picture p139: CAD file, 2021-11-23]
RLS_V1.0/R2Home _3DPRINT_V1.0/PCB_mount.stl
64.0 x 73.0 x 14.6
