YohanHadji/R2Home/RLS_V1.0/R2Home _3DPRINT_V1.0/Servo_mount.stl

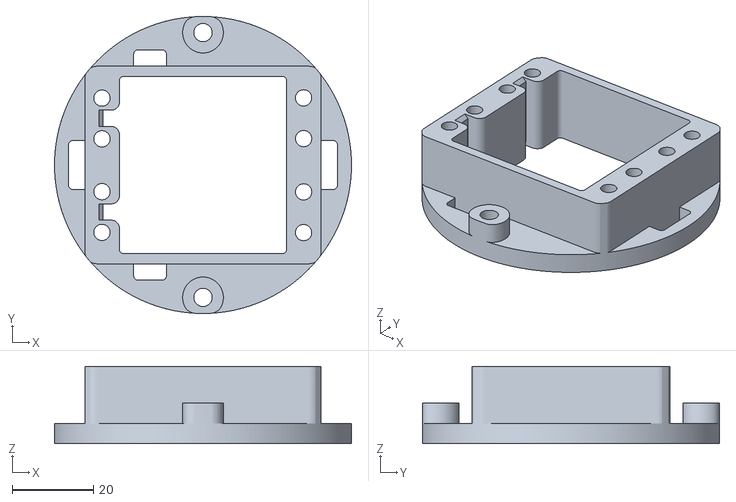
[picture p140: CAD file, 2021-11-23]
RLS_V1.0/R2Home _3DPRINT_V1.0/Servo_mount.stl
72.9 x 72.9 x 19.0
