YohanHadji/R2Home/(list of files, cad)

Other CAD files:
RLS_V1.0/R2Home _3DPRINT_V1.0/Pin2.stl
Old_dev_versions/V0.01/R2HomeV0.01.f3d
Old_dev_versions/V0.1/R2HomeV0.1.f3d
