YohanHadji/R2Home/Parachute Design Ressources/Building advices/img003.jpeg

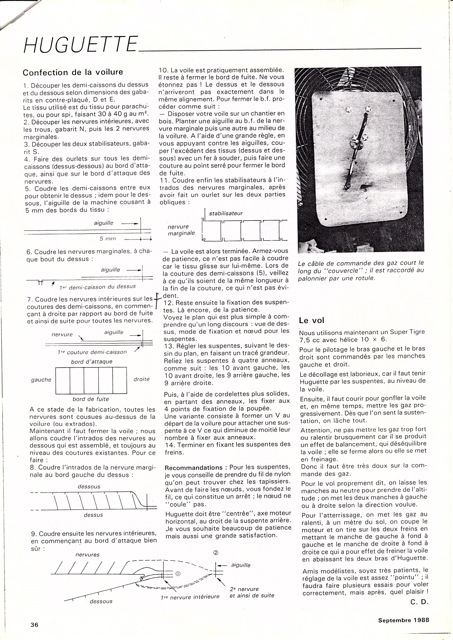
Parachute Design Ressources/Building advices/img003.jpeg
