YohanHadji/R2Home/RLS_V1.0/R2Home_HARDWARE_V0.1/R2Home's_PCB/V3/Schematic_R2HomeV3.pdf

A | A

1

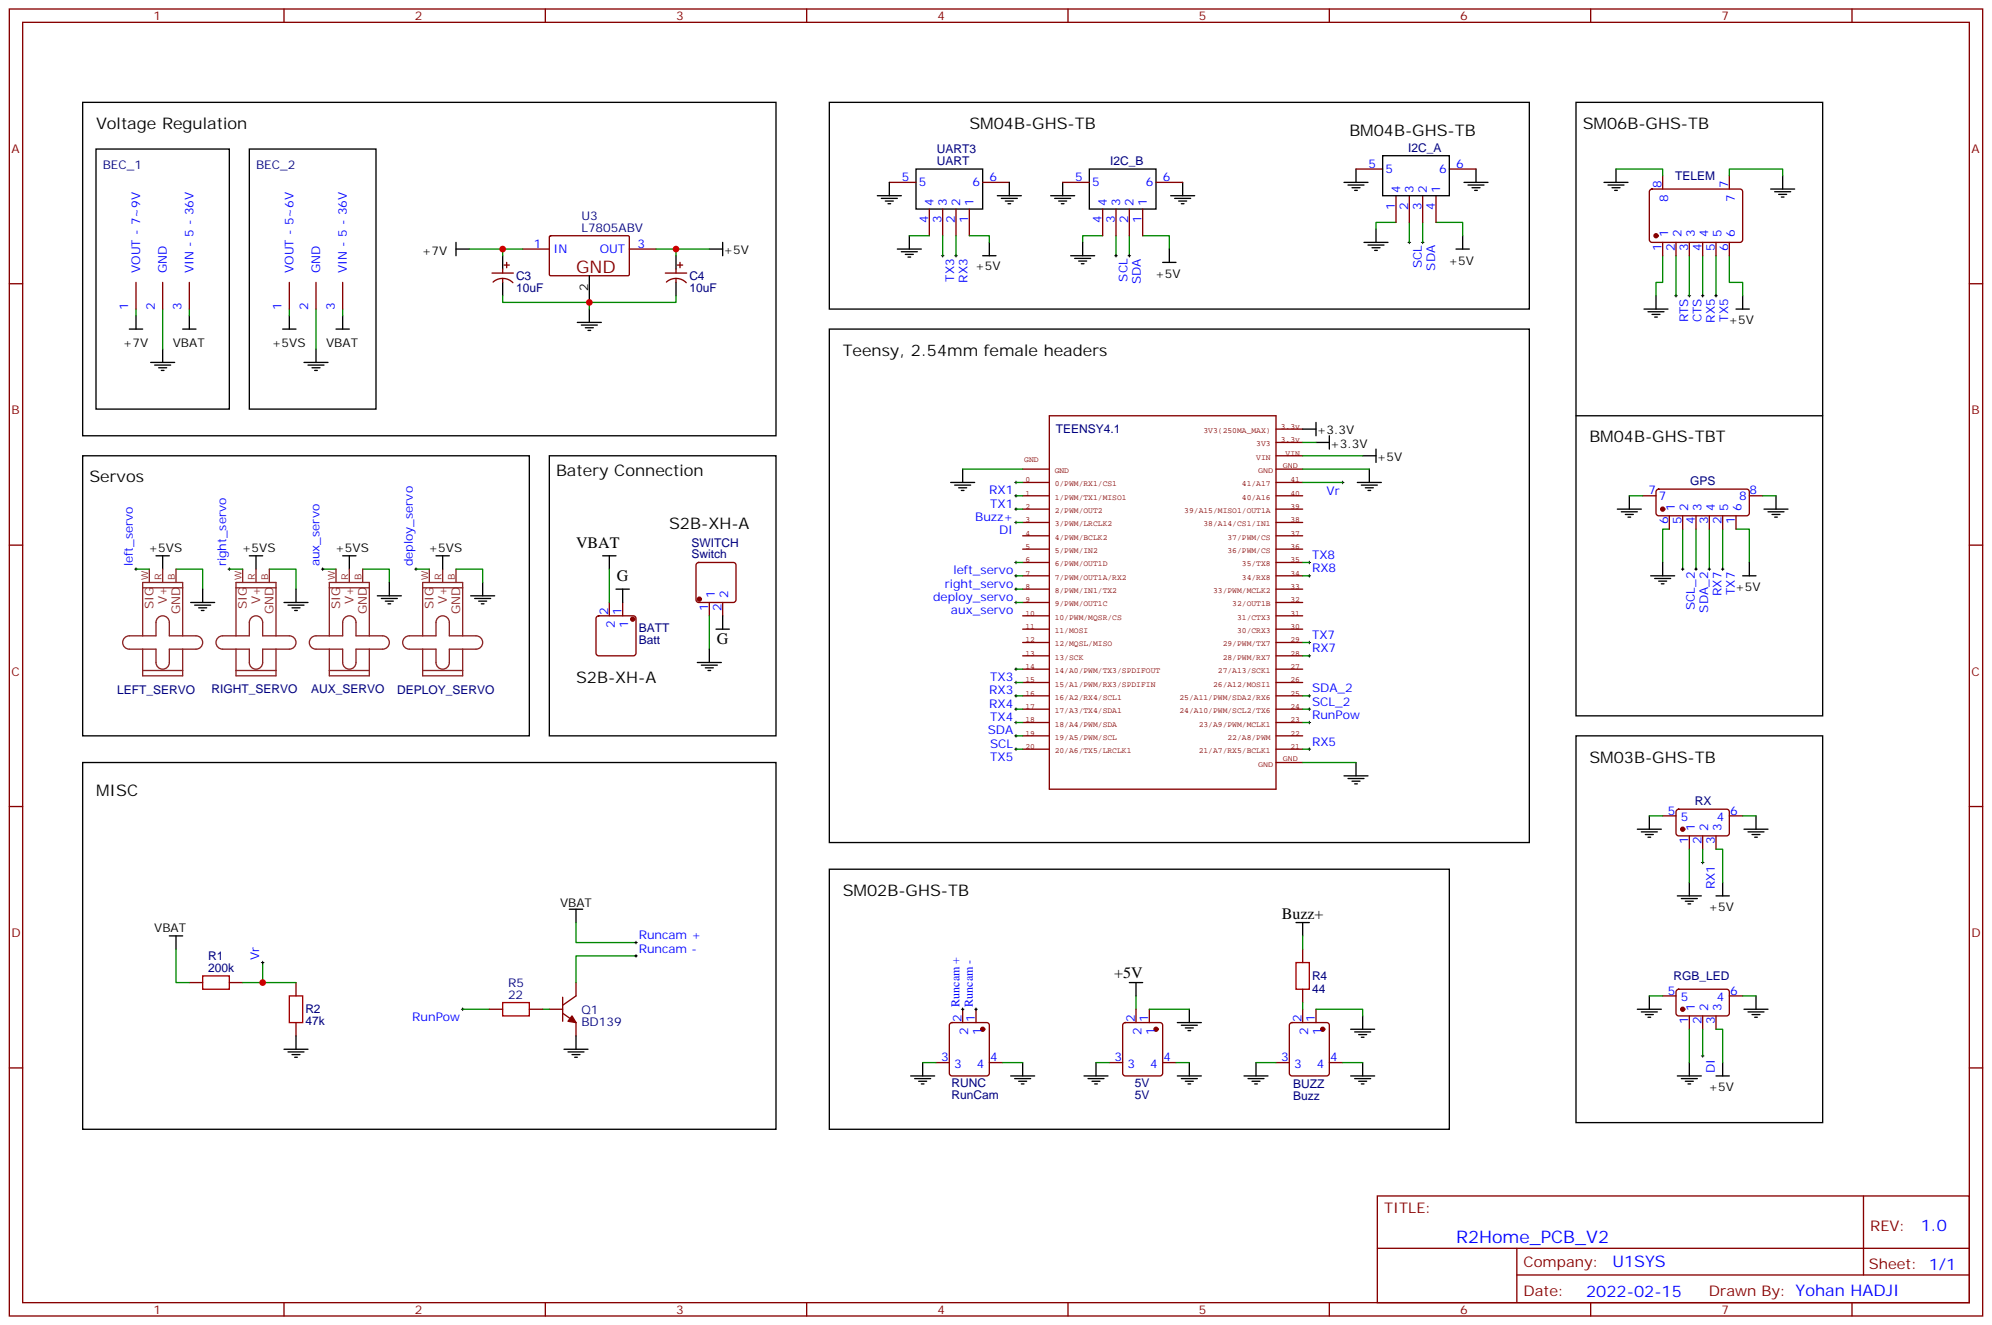
[picture p195: page 1]

Drawn By: Yohan HADJI
