YohanHadji/R2Home/RLS_V1.0/R2Home_HARDWARE_V0.1/R2Home's_PCB/V2/R2Home_PCB_Sch_V2.pdf

A | A

1

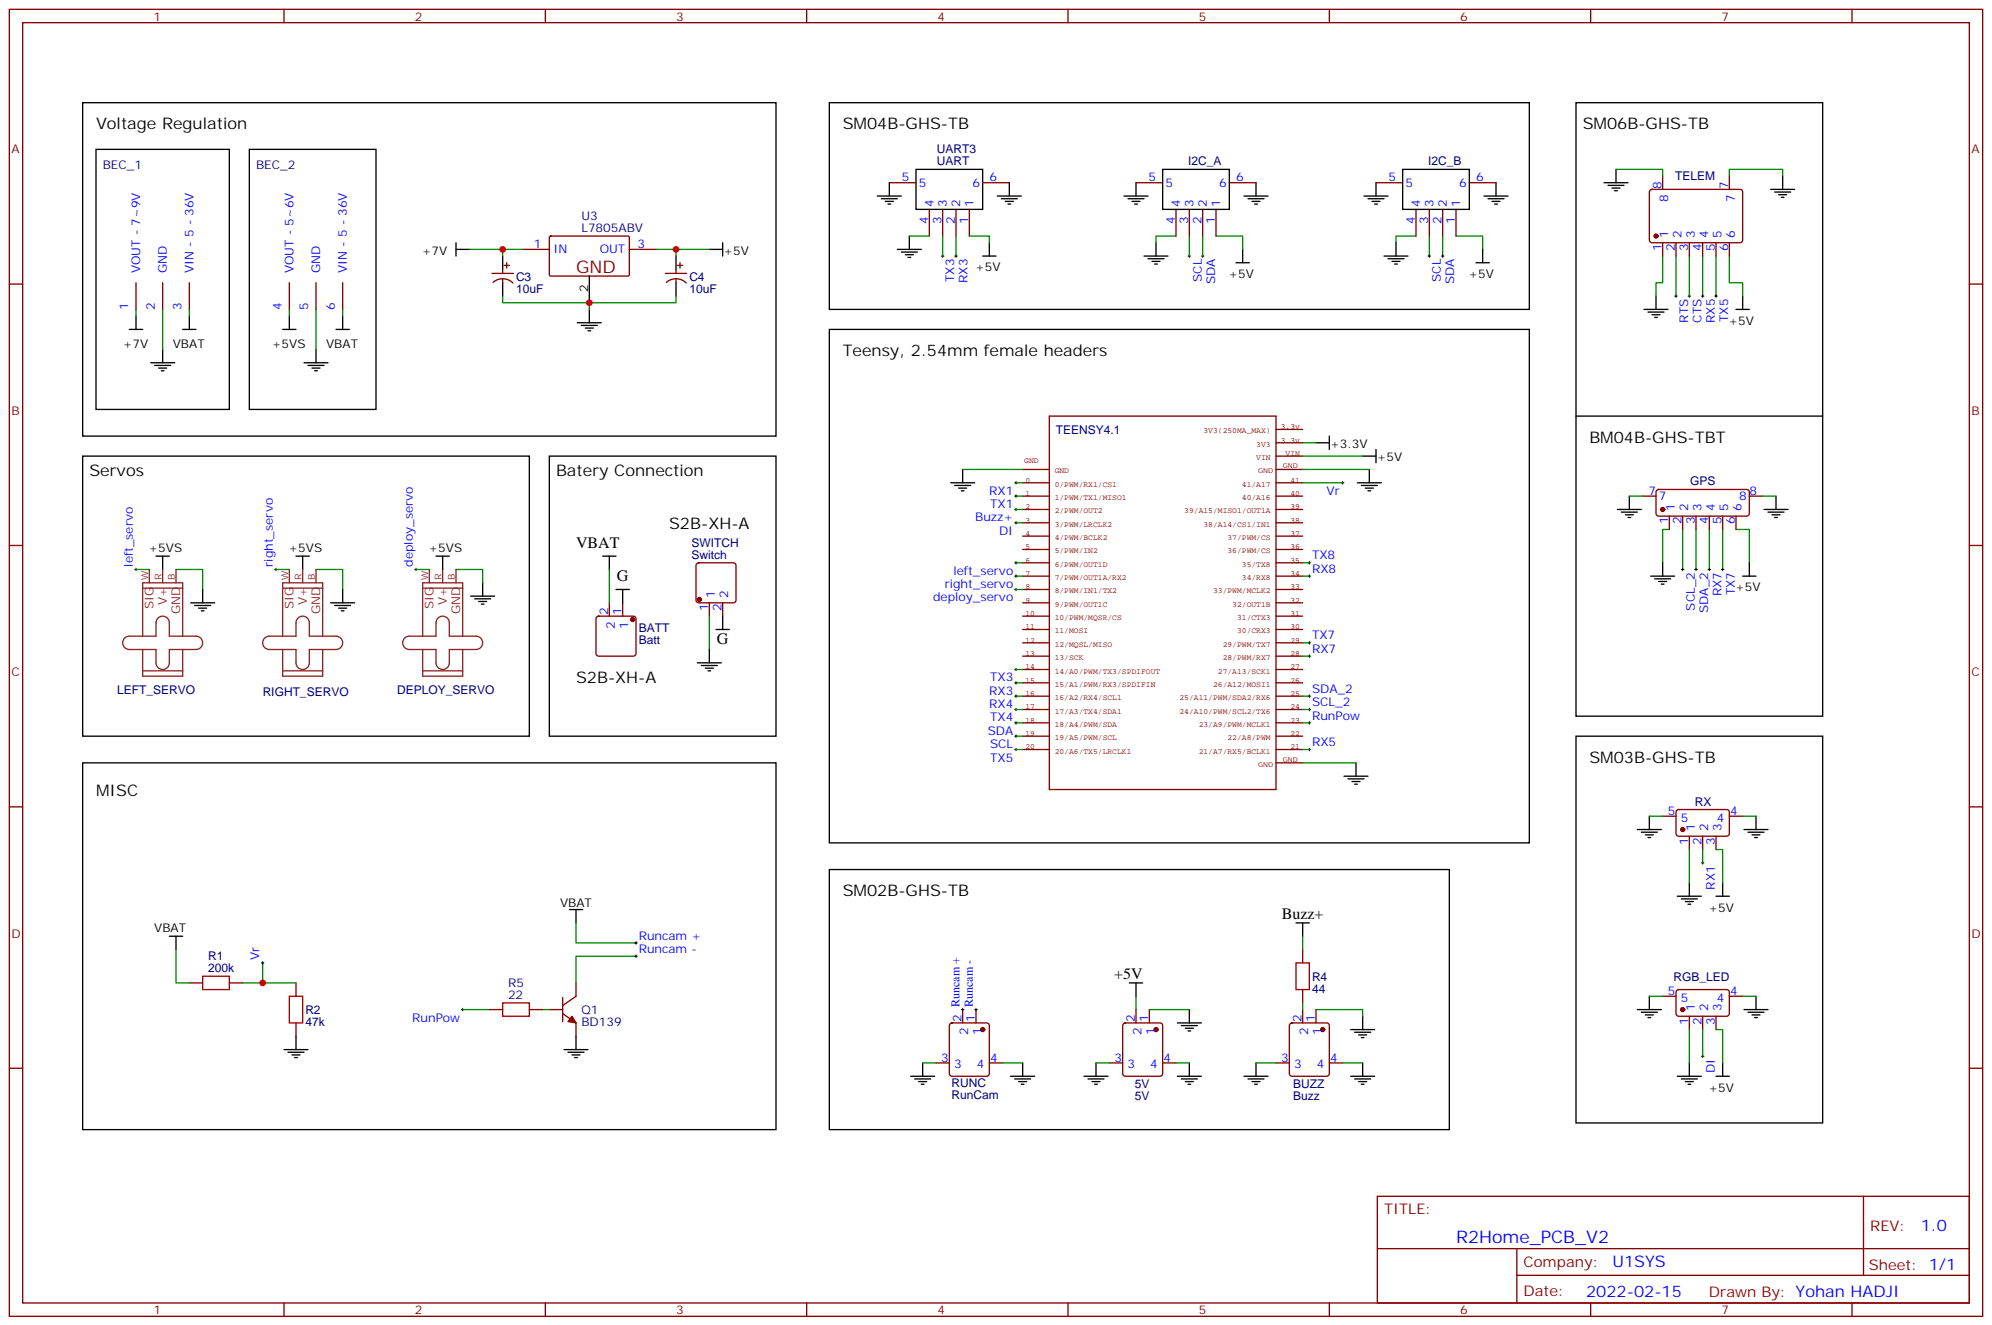
[picture p197: page 1]

Drawn By: Yohan HADJI
