YohanHadji/R2Home/Old_dev_versions/RLS_V0.3/R2Home_PCB_V0.1/R2Home_PCB_Sch_V1.pdf

A | A

1

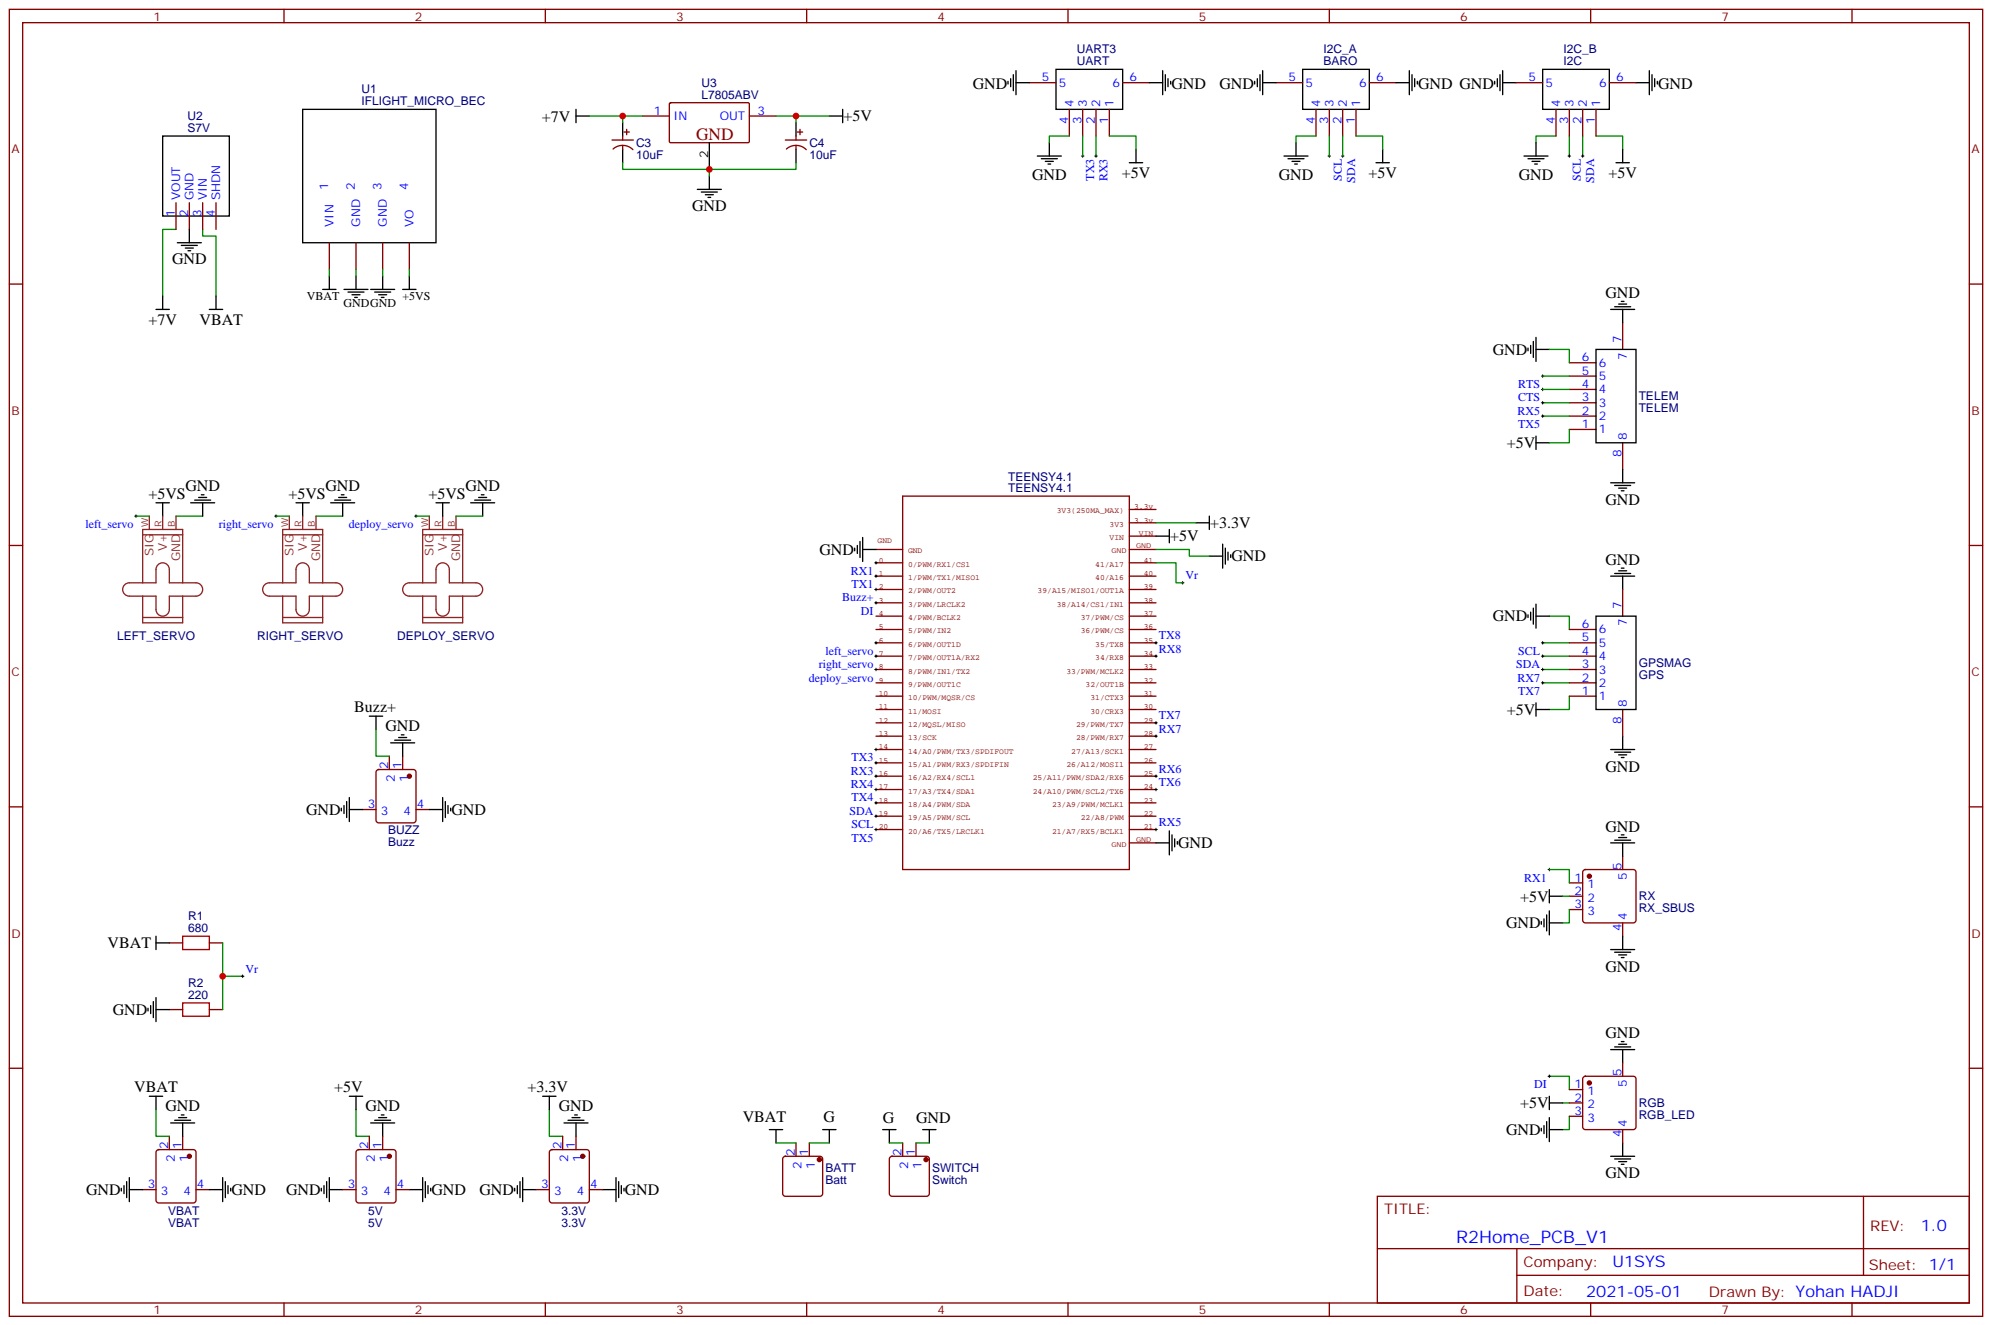
[picture p198: page 1]

Drawn By: Yohan HADJI
