YohanHadji/R2Home/(commit log)

2021-09-27 Add PCB files
2021-10-16 Add PCB BOM V1
    [R2Home's PCB BOM - SMD and small parts.csv]
2021-11-04 Add V1.0
    [R2Home's PCB BOM - SMD and small parts.csv]
2021-11-08 add servo code
2021-11-23 Add STL files
    [Battery_mount.stl, Bottom_bulkhead.stl, External.stl, Internal.stl, PCB_mount.stl, Pin1.stl, Pin2.stl, Servo_drum.stl]
2021-11-27 Update R2Home code with pitch control
2021-12-01 Add independent servos option
2021-12-03 Update PCB and Code
2021-12-09 Update Servo Code
2021-12-10 Update R2Home Servo
2021-12-10 Servo finally fixed..
2021-12-27 Update Servo Control Mode
    [Battery_mount.stl]
2022-01-08 update navigation code + minor fixes
    [R2Home_SERVO.ino]
2022-01-10 update BOM
    [R2Home's BOM.csv, R2Home's PCB BOM - SMD and small parts.csv]
2022-01-10 Correct Name
    [R2Home's BOM.csv]
2022-01-10 Update R2Home's BOM.csv
    [R2Home's BOM.csv]
2022-02-09 update the servo control code
    [Bottom_bulkhead.stl, Bottom_strong_attach.stl, Strongtop.stl]
2022-02-16 Updating schematics and keeping old software version
2022-02-17 Update folders
    [R2Home's PCB BOM - SMD and small parts.csv]
2022-02-17 Create Landing_Pano_A_Traj 2.jpg
2022-03-21 Update after test day
    More delay after opening and before control start to give more time for the wing to stabilize.
    New feature : ground altitude, used to make sure the ground altitude is not reset after the flight has started, even if a GPS fix is lost for a few minutes before being regained
    New old feature, but not tested again : cog_brake, will reduce command if turn rate is too high, but might not be really necessary with a good PID controller.. so..
2022-03-21 Correction on the gerber file
2022-03-22 Updating PCB File
2022-03-26 Correction of bug on gps vertical speed (not yet used in code)
    [gps.hpp]
2022-04-08 Cleaning the debugging and catching a bug in the baro code
    [barometer.hpp, position.hpp]
2022-04-08 Fixing bug in servo
    [feedback.hpp, main.ino, navigation.hpp, servo.hpp]
2022-04-08 Finishing the servo fix
    [control.hpp, main.ino]
2022-04-08 Fix minor glitches and improve GPS vertical speed precision
    [flight_state.hpp, gps.hpp, main.ino]
2022-04-08 Adding X servo capability
2022-04-09 Ready ready ready
    Even servo X is tested-ish
    I simulated a separation event and then datalog shows the the servo signal moved from 2000 to 1000 as needed
2022-04-10 Upgrade separation servo
    Separation altitude is now also relative to ground
    + New option to test the sep servo "TEST_SEP_SERVO"
2022-04-10 Caught bug in baro altitude fusion weight
    Oupsi
    [position.hpp]
2022-04-10 Update version and SEP_ALT
    Changed my mind, it's better to have SEP_ALT relative to the sea level. Because if for a reason it reboots in flight, it'll take the actual altitude as ground altitude and never separate. While if we use sea level as a reference, whatever the reboot altitude is, it'll always deploy daughter at the right altitude.
    [config.h, flight_state.hpp, main.ino]
2022-04-10 Safety improvement
    Barometer and GPS vertical speed are now constrained between -50 and 10m/s which are the physical limit. Any vertical speed higher or lower would just be wrong.
    [barometer.hpp, gps.hpp]
2022-04-10 Update Version + add camera state to datalog
